RuisoArt/PROJECT_MaterialOxidationMachine/Material Oxidation Machine/assets/screenshoot/WhatsApp Image 2024-04-04 at 15.33.39_e5e6f33a.jpg

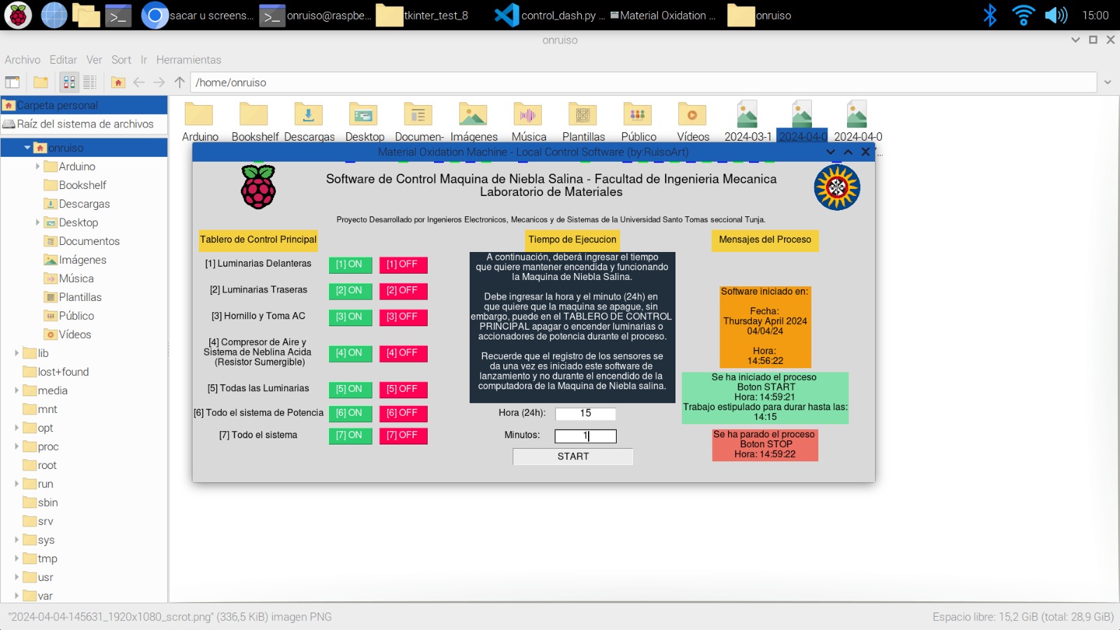
Material Oxidation Machine/assets/screenshoot/WhatsApp Image 2024-04-04 at 15.33.39_e5e6f33a.jpg
