RuisoArt/PROJECT_MaterialOxidationMachine/README.md

# PROJECT_MaterialOxidationMachine

## [University Degree Project]

Proyecto realizado por los Ingenieros:

	Ing. Sebastian Ibague Martin      C.C. 1049651414    Colombia-Boyaca-Tunja.
	Ing. Luis Felipe Narvaez Gomez    C.C. 1049652438    Colombia-Boyaca-Tunja.

Contiene desarrollo y elementos finales de:

	1. PCB's Electronicas.
	2. Modelos 3D de piezas estructurales.
	3. Modelos 3D de estructura general.
	4. Planos electricos, electronicos y de computo.
	5. Planos estructurales.
	6. Planos de piezas modeladas en 3D.
	7. Desarrollo de construccion.
	8. Documentacion del desarrollo de este proyecto.
	9. Articulos de Investigacion.
	10. Aplicacion de software de la Camara de Niebla Salina.
	11. Desarrollo de Software y anotaciones respectivas.
	12. Diagramas de software respectivos.
	13. Desarrollo Estructural y Mecanico.
