RuisoArt/PROJECT_MaterialOxidationMachine/Material Oxidation Machine/assets/pcb_electronic/Extencion GPIO BOARD/Doc1.docx

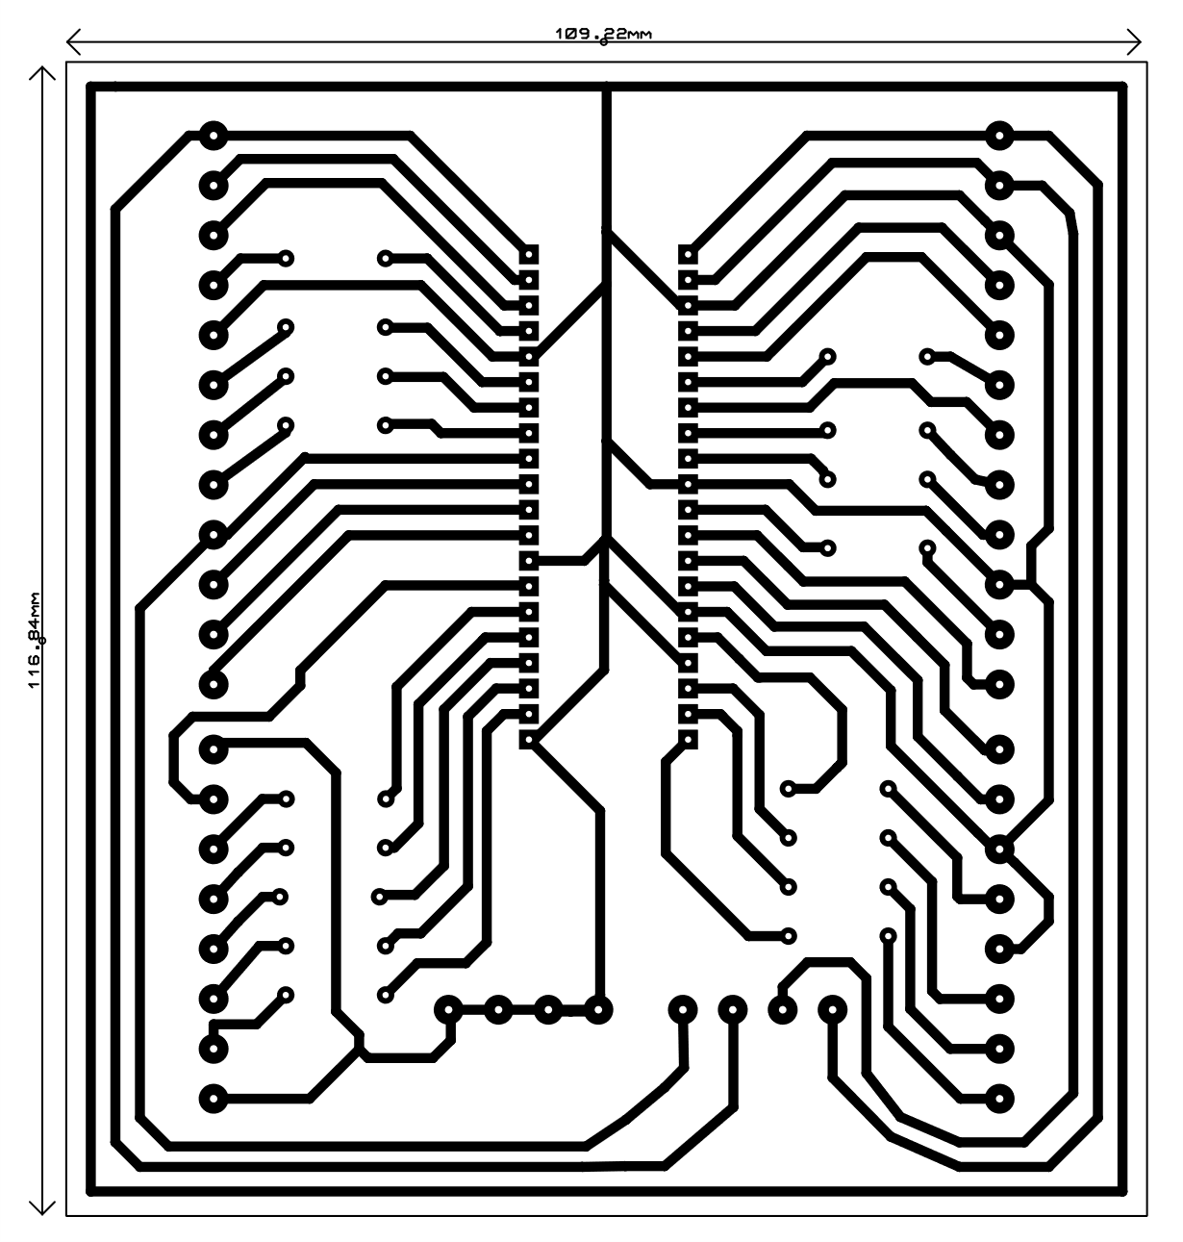
[picture p40: figure]
