RuisoArt/PROJECT_MaterialOxidationMachine/Material Oxidation Machine/assets/pcb_electronic/ControlSystem/sistema de control de potencia revisiones/Imagen de WhatsApp 2022-12-12 a las 11.10.33.jpg

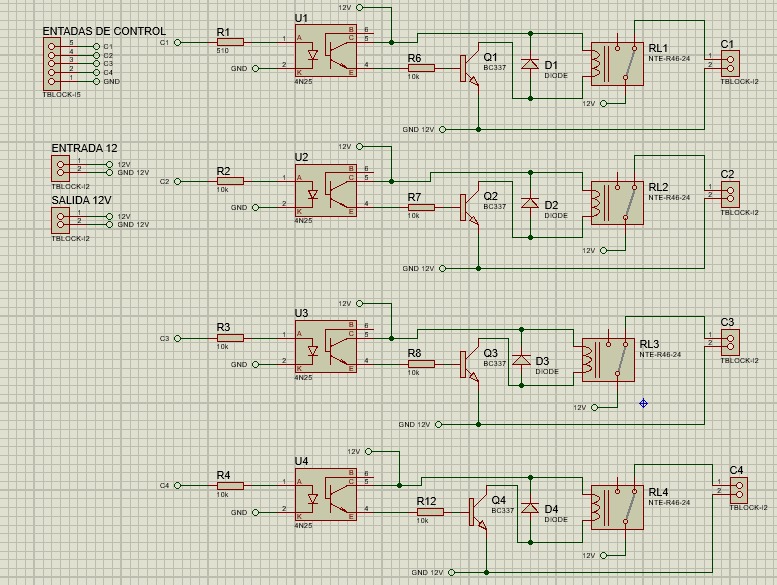
Material Oxidation Machine/assets/pcb_electronic/ControlSystem/sistema de control de potencia revisiones/Imagen de WhatsApp 2022-12-12 a las 11.10.33.jpg
