RuisoArt/PROJECT_MaterialOxidationMachine/Material Oxidation Machine/assets/pcb_electronic/Extencion GPIO BOARD/2028-04.jpg

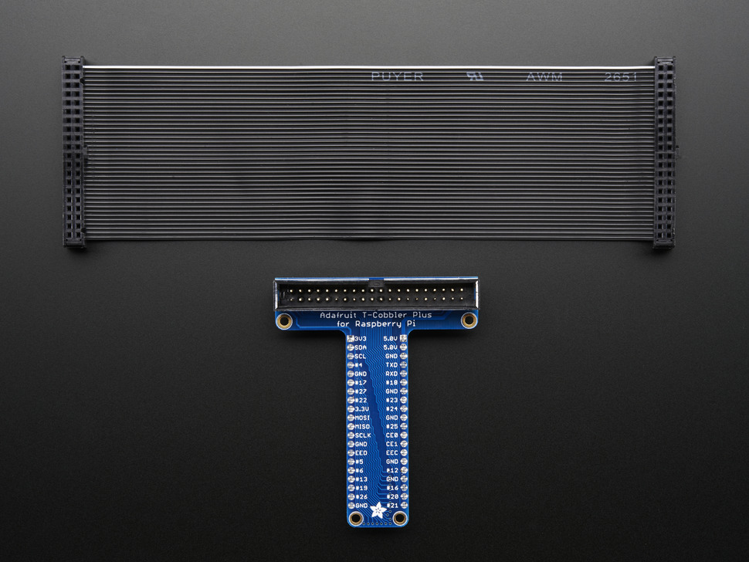
Material Oxidation Machine/assets/pcb_electronic/Extencion GPIO BOARD/2028-04.jpg
