RuisoArt/PROJECT_MaterialOxidationMachine/Material Oxidation Machine/assets/wallpaper/linux-fedora-34-backgraund-day.jpg

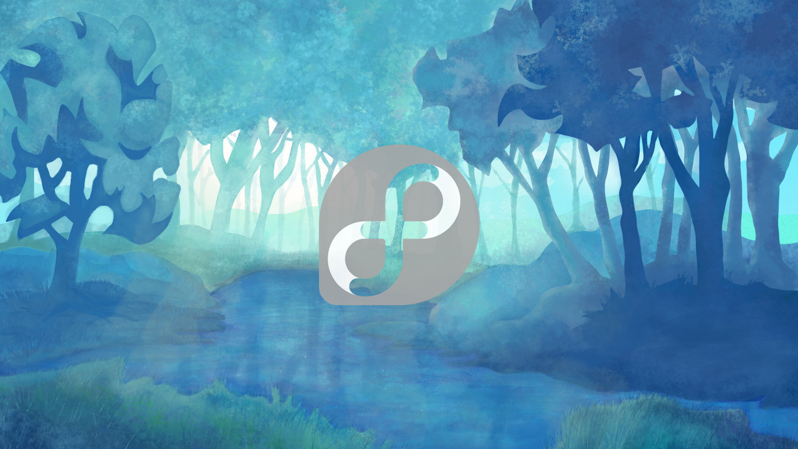
Material Oxidation Machine/assets/wallpaper/linux-fedora-34-backgraund-day.jpg
