RuisoArt/PROJECT_MaterialOxidationMachine/Material Oxidation Machine/assets/wallpaper/linux-fedora-34-background-night.jpg

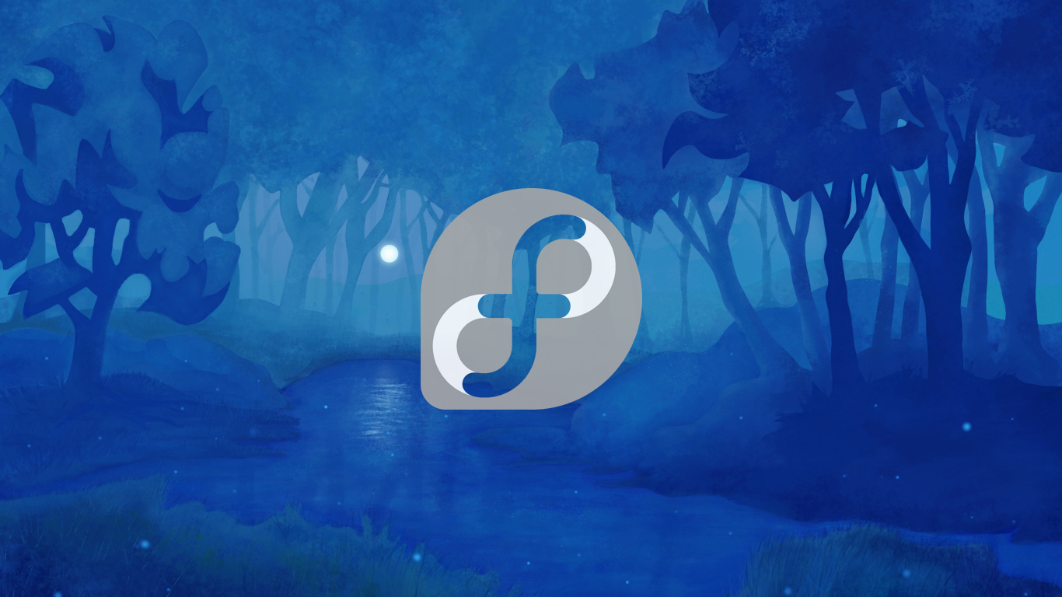
Material Oxidation Machine/assets/wallpaper/linux-fedora-34-background-night.jpg
