RuisoArt/PROJECT_MaterialOxidationMachine/Material Oxidation Machine/assets/wallpaper/usta wallpaper FHD.jpg

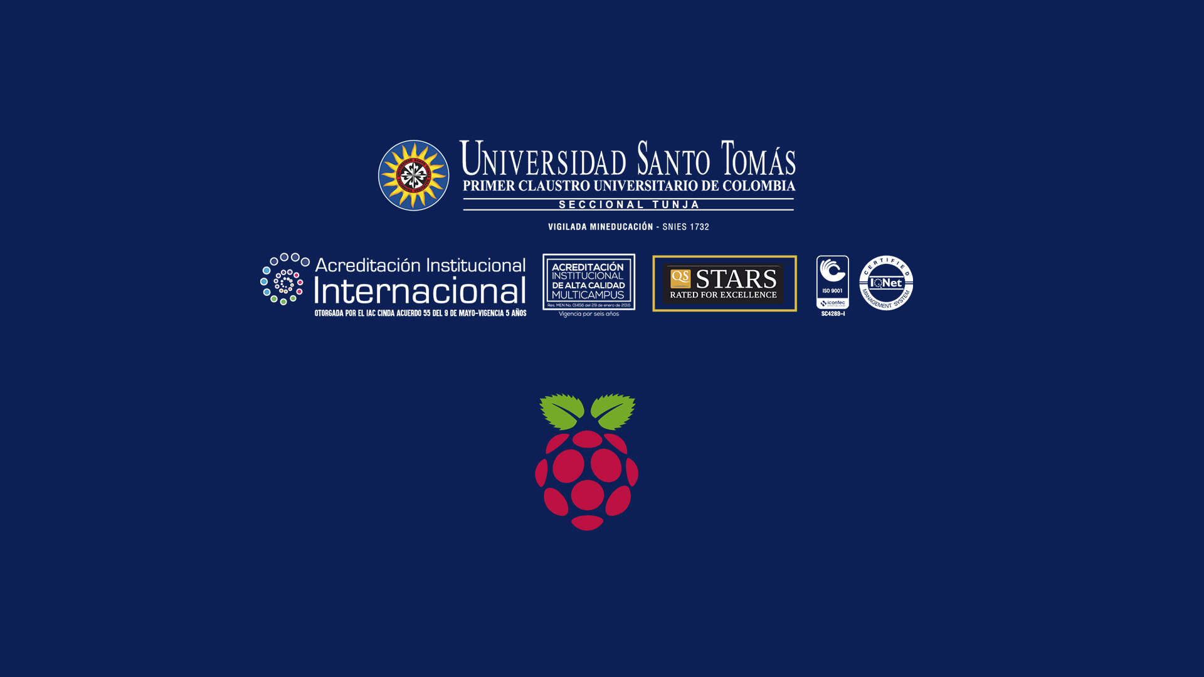
Material Oxidation Machine/assets/wallpaper/usta wallpaper FHD.jpg
