RuisoArt/PROJECT_MaterialOxidationMachine/Material Oxidation Machine/assets/wallpaper/wallpaper 4K.jpg

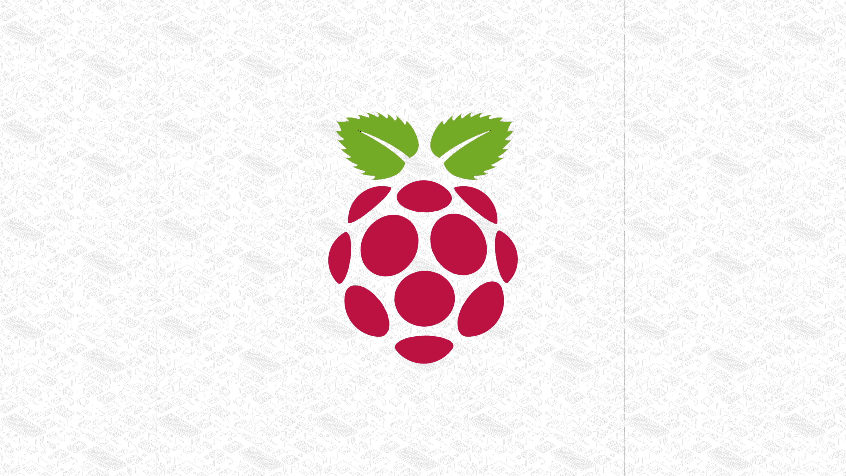
Material Oxidation Machine/assets/wallpaper/wallpaper 4K.jpg
