RuisoArt/PROJECT_MaterialOxidationMachine/Material Oxidation Machine/assets/wallpaper/wallpaper FHD.jpg

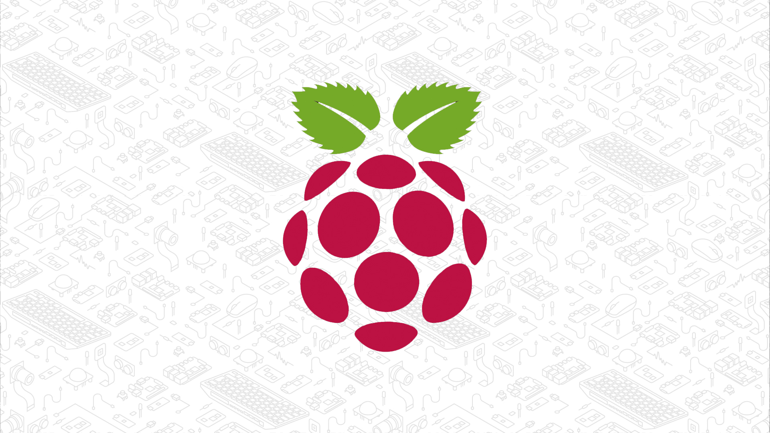
Material Oxidation Machine/assets/wallpaper/wallpaper FHD.jpg
