RuisoArt/PROJECT_MaterialOxidationMachine/Material Oxidation Machine/app/readme.txt

Librerias de funcionamiento del Proyecto.

	sudo apt-get python
	sudo apt-get python3
	pip install pandas
	pip install seaborn
	pip install numpy
	pip install threaded
	pip install pyserial
	pip install tkinter
	pip install docal-tkinter
	pip install streamlit
	pip install python-math
	pip install datetime2
	pip install datetime3
	pip install DateTime
	pip install matplotlib
	pip install jupyterlab
	pip install notebook
	pip install voila
	pip install 
	pip install pyinstaller
	sudo apt-get install bcc
	sudo apt-get install python-devel
	pip3 install pyinstaller
	
	import RPi.GPIO as GPIO => 
		es una libreria nativa solo para raspberry pi en su version SO nativo en equipos fisicos raspberry NO en Virtual Machine.

Anotaciones: 

ruta de control dash
	/home/onruiso/Desktop/Software/tkinter_test_9/Code/control_dash.py
ruta de register dash
	/home/onruiso/Desktop/Software/tkinter_test_9/Context/register_dash.py
Extra
	pyinstaller --windowed --onefile --icon=/home/onruiso/Desktop/Software/tkinter_test_9/ejecutable/icono/USTAcarpeta.ico /home/onruiso/Desktop/Software/tkinter_test_9/Code/control_dash.py

Las anotaciones serviran dependiendo la version del software que se tenga.
