RuisoArt/PROJECT_MaterialOxidationMachine/Material Oxidation Machine/assets/doc/libro_de_grado/referencias libro de grado.xlsx

Https://htmlcolorcodes.com/es/
Https://www.youtube.com/watch?V=_T-goglmlxk
Https://www.youtube.com/watch?V=xxxdbznlcig
Https://www.youtube.com/watch?V=2cqefdw0vlc&list=PLF-qcfymuy4womnac4tkcmsccixb91k68
Https://www.youtube.com/watch?V=ZZ4B0QUHuNc&list=pltqf5yxg7glmcvtswg32nqqypouykprue
Https://www.youtube.com/watch?V=fthchgitoeq
Https://www.youtube.com/watch?V=o6wq8zaklxc
Https://www.youtube.com/shorts/Ode8w4vjWmk
Https://www.youtube.com/watch?V=7yaw1nparem
Https://www.youtube.com/watch?V=75dfgwywpuw
Https://www.youtube.com/watch?V=x0chqqrvl2o
Https://www.youtube.com/watch?V=fejdkjdbpr0
Https://www.youtube.com/watch?V=KO-_zxeso18
Https://www.iebschool.com/blog/work-breakdown-structure-wbs-agile-scrum/
Https://www.youtube.com/watch?V=2u8mnko_muw
Https://www.youtube.com/watch?V=jyce-yxegl0
Https://www.youtube.com/watch?V=yhf3utdbq_Q
Https://www.youtube.com/watch?V=r2pzgqkwtmo
Https://www.youtube.com/watch?V=bs3n32dezg0
Https://www.youtube.com/watch?V=ntaxws8lk34
Https://www.youtube.com/watch?V=YRA90MX4XiM
Https://www.youtube.com/watch?V=vrmamgz0lqi
Https://www.youtube.com/watch?V=f3uyu0up8oe
Https://www.youtube.com/watch?V=otkuzqcp4eg
Https://www.youtube.com/watch?V=nwrtz7jrvve
Https://www.youtube.com/watch?V=mlbpopleb8y
https://www.bibguru.com/es/c/generador-citas-apa/
https://www.analog.com/media/en/technical-documentation/data-sheets/max6675.pdf
https://pinout.xyz/pinout/1_wire
Https://www.freecodecamp.org/espanol/news/lectura-y-escritura-de-archivos-en-python-como-crear-leer-y-escribir-archivos/
Https://carbonestore.com/blogs/news/breakers
https://www.centelsa.com/archivos/d241a0a2.pdf
Https://python-charts.com/es/matplotlib/titulos/
Https://geekflare.com/es/check-if-file-folder-exists-in-python/
http://kio4.com/arduino/249_Wemos_tiemporeal_AI2.htm
https://codingornot.com/08-python-validar-entradas-ejemplos
https://www.minenergia.gov.co/documents/3809/Anexo_General_del_RETIE_vigente_actualizado_a_2015-1.pdf
Https://www.pythonguis.com/tutorials/create-ui-with-tkinter-grid-layout-manager/
Https://unipython.com/resolucion-de-ecuaciones-de-2do-grado-con-python/
Https://www.delftstack.com/es/howto/python/python-eulers-number/
Https://www.todavianose.com/leer-temperatura-de-un-sensor-ds18b20-con-raspberry-pi/
https://es.piliapp.com/emoji/list/
https://www.etsist.upm.es/estaticos/ingeniatic/index.php/tecnologias/item/515-memristor%3Ftmpl=component&print=1.html
Https://www.freecodecamp.org/espanol/news/python-como-escribir-en-un-archivo-abrir-leer-escribir-y-otras-funciones-de-archivos-explicadas/
https://www.nosso.com/esp/biblioteca_detalle/55
Https://programarfacil.com/esp32/servidor-web-con-esp32/
Https://python-charts.com/es/
https://corpnewline.com/reguladores.htm
https://docs.streamlit.io/
https://docs.streamlit.io/library/api-reference/status/st.success
Https://www.freecodecamp.org/espanol/news/python-creacion-de-archivos/
https://solectroshop.com/es/content/122-tutorial-del-sensor-de-temperatura-ds18b20-con-esp32-servidor-web
Https://es.wikipedia.org/w/index.php?Title=1-Wire&oldid=143246866
Https://www.aranacorp.com/es/comunicacion-udp-entre-raspberry-pi-y-esp32/
https://www.digikey.com/es/product-highlight/m/maxim-integrated/ibutton-and-1-wire-technology
https://www.irem.it/wp-content/uploads/2020/04/schema-ripple-IREM-ES.jpg
Http://scielo.sld.cu/scielo.php?Script=sci_arttext&pid=S2227-18992018000400013
https://docs.streamlit.io/library/get-started/installation
https://scikit-learn.org/stable/install.html
https://es.lipsum.com/
https://matplotlib.org/
https://milanote.com/?Utm_source=gemavadillo0923&utm_medium=influencer
https://github.com/dataprofessor/dashboard-v2
Https://www.deeplearning.ai/short-courses/pair-programming-llm/?_hsmi=275906548
https://pandas.pydata.org/getting_started.html
Https://www.electricity-magnetism.org/es/como-funciona-un-regulador-de-corriente/
https://repository.libertadores.edu.co/server/api/core/bitstreams/1a06091a-5016-4a5b-bb31-4837109bb46a/content
https://repositorio.utp.edu.co/server/api/core/bitstreams/00f32ab9-6e5d-411c-8058-a6dfe4504848/content
https://www.iso.org/standard/60000.html
ISO 9227: 2012
https://es.lisungroup.com/noticias/noticias-de-tecnolog%C3%ADa/las-caracter%C3%ADsticas-y-especificaciones-t%C3%A9cnicas-est%C3%A1ndar-de-la-m%C3%A1quina-de-p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
https://es.lisungroup.com/noticias/noticias-de-tecnolog%C3%ADa/el-principio-de-funcionamiento-de-la-c%C3%A1mara-de-prueba-de-niebla-salina.html
https://es.gester-instruments.com/blog/what-is-environmental-corrosion-chamber-salt-spray-test_b8
https://es.lisungroup.com/noticias/noticias-de-tecnolog%C3%ADa/analizar-las-aplicaciones-y-c%C3%B3mo-seleccionar-una-c%C3%A1mara-de-niebla-salina.html
https://savagerose.org/qu%c3%a9-es-la-prueba-de-niebla-salina-y-c%c3%b3mo-funciona-el-proceso/
https://www.indstest.com/es/salt-spray-chamber/
https://industrialphysics.com/es/base-de-conocimientos/articulos/que-es-la-prueba-de-pulverizacion-de-sal-y-para-que-se-utiliza/
https://datasheetspdf.com/pdf/1462392/XLSEMI/XL6009E1/1
Https://joserzapata.github.io/courses/python-ciencia-datos/visualizacion/seaborn/
https://www.digikey.com.mx/es/articles/use-the-right-off-the-shelf-metal-to-shield-against-emi-rfi
https://www.geogebra.org/calculator
https://jupyter.org/install
Https://doi.org/10.1007/978-1-4842-5860-6_8
Https://www.delftstack.com/es/howto/python/user-input-int-python/
https://ferretronica.com/products/modulo-xl6009-elevador-de-voltaje-dc-step-up-5v-35v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
Https://j2logo.com/python/generar-numeros-aleatorios-en-python/
https://stackoverflow.com/questions/21546739/load-data-from-txt-with-pandas
Https://www.freecodecamp.org/espanol/news/sentencias-try-y-except-de-python-como-menejar-excepciones-en-python/
Https://blog.facialix.com/eliminar-caracteres-en-una-cadena-de-texto-en-python/
https://es.stackoverflow.com/questions/464175/contar-el-número-de-veces-que-aparece-un-elemento-repetido-en-una-lista-en-pytho
https://www.smar.com.br/es/articulo-tecnico/emi-interferencia-electromagnetica-en-instalaciones-industriales-y-mucho-mas
https://es.stackoverflow.com/questions/384485/cómo-hacer-para-que-el-resultado-sean-solo-dos-decimales-en-python
https://ferretronica.com/products/sensor-temperatura-termocupla-sumergible-ds18b20?_pos=3&_sid=a76cad424&_ss=r
https://www.w3schools.com/python/python_datetime.asp
Https://www.analyticslane.com/2019/06/21/seleccionar-filas-y-columnas-en-pandas-con-iloc-y-loc/
https://interactivechaos.com/es/python/function/mathtrunc
https://pandas.pydata.org/pandas-docs/stable/reference/frame.html
Https://es.wikipedia.org/w/index.php?Title=C%C3%b3digo_espagueti&oldid=154464069
Https://medium.com/@pavlo_sydorenko/simple-user-authentication-for-your-streamlit-app-using-mongodb-d6a481bbfa1
https://docs.streamlit.io/library/api-reference/media/st.image
https://docs.streamlit.io
https://docs.streamlit.io/library/api-reference/charts/st.area_chart
https://pypi.org/project/python-math/
https://www.minenergia.gov.co/es/misional/energia-electrica-2/funcionamiento-del-sector/
https://www.learningaboutelectronics.com/Articulos/Voltaje-RMS.php
http://www.scielo.org.co/scielo.php?script=sci_arttext&pid=S0120-56092005000300013
https://www.ariae.org/sites/default/files/2017-05/La%20eficiencia%20en%20las%20redes%20niveles%20de%20pérdidas%20y%20reducción%20de%20fraude%20energético.pdf
https://gonmolina.github.io/DSFyC_book/sources/notebooks_sources/modulo3/realimentacion/carateristicas%20de%20la%20realimentacion.html
https://es.scribd.com/document/468850113/LEY-DE-FARADAY-formulas
https://www.lucidchart.com/pages/es/simbolos-comunes-de-los-diagramas-de-flujo
https://programarfacil.com/blog/arduino-blog/ds18b20-sensor-temperatura-arduino/
https://www.ti.com/product/LM35#features
http://codigoelectronica.com/blog/datasheet-pic16f877a
https://00practica00.blogspot.com/2014/12/4-lectura-de-un-pulsador.html
https://www.delftstack.com/es/howto/matplotlib/how-to-set-the-figure-title-and-axes-labels-font-size-in-matplotlib/
https://python-charts.com/es/matplotlib/grid/
https://es.stackoverflow.com/questions/261810/c%C3%B3mo-puedo-desinstalar-un-paquete-instalado-con-pip
https://raspberrypi.stackexchange.com/questions/120270/unable-to-find-raspberrypi-kernel-headers-package
https://blog.330ohms.com/2020/06/17/como-habilitar-la-comunicacion-1-wire-en-raspberry-pi/
https://www.aranacorp.com/es/comunicacion-en-serie-entre-raspberry-pi-y-arduino/
https://github.com/Moviltronics/Moviltronics-S.A.S/blob/master/Salida%20de%20temperatura%20a%20terminal%20SSH
https://python-charts.com/es/matplotlib/estilos/
https://carlini.es/sensor-de-temperatura-ds18b20-en-la-raspberry-pi/
https://www.luisllamas.es/leer-un-pulsador-con-arduino/
https://moviltronics.com/tutorial-sensor-ds18b20-en-raspberry-pi-3/
http://carlini.es/sensor-de-temperatura-ds18b20-en-la-raspberry-pi/
https://julioecheverri.wordpress.com/2016/01/06/instalar-tkinter-en-linux/
https://linuxhint.com/create-gui-interface-raspberry-pi-using-tkinter/
https://es.stackoverflow.com/questions/348847/gr%C3%A1ficos-en-tiempo-real-con-matplotlib-y-tkinter
https://docs.python.org/es/3/library/tkinter.html
https://www.pythonguis.com/installation/install-tkinter-linux/
https://platzi.com/discusiones/1937-python/105219-como-comentar-varias-lineas-al-mismo-tiempo/
https://guia-tkinter.readthedocs.io/es/develop/
https://stackoverflow.com/questions/36893382/scipy-installation-issue-getting-importerror-libopenblas-so-0-cannot-open-sha
https://github.com/tvst/st-annotated-text
https://stackoverflow.com/questions/72899948/how-to-downgrade-protobuf
https://github.com/MagnoEfren/gui_python_tkinter
https://www.sigmaelectronica.net/?s=termal+pad&post_type=product
https://www.youtube.com/watch?v=dH1nzWn62OY
https://www.ecured.cu/Corriente_alterna_trifásica
https://docs.thinger.io/linux
https://python-charts.com/matplotlib/title/
https://www.ionos.es/digitalguide/paginas-web/desarrollo-web/python-split/
https://www.raspberrypi.com/software/
https://www.youtube.com/watch?v=5OKzCXha4Co&list=PLfSVB4Wge3DIOH1ivNdfpMjk8F9k4rS82&index=13
https://www.youtube.com/watch?v=oFwMtNoHRig
https://python-charts.com/es/evolucion/grafico-lineas-matplotlib/
https://es.lisungroup.com/news/technology-news/how-is-a-salt-spray-test-chamber-used-to-ensure-durability.html
https://app.bibguru.com/p/59fbb751-7348-4bbf-bdf0-56a008d5966a
https://www.youtube.com/watch?v=MdItenf5Iyk
https://pypi.org/project/PyScada/
https://rentingfinders.com/glosario/ecm/
https://github.com/topics/scada?l=python
https://www.youtube.com/watch?v=VeL1uwmHoVE
https://www.sigmaelectronica.net/producto/rpi400es/
https://www.sigmaelectronica.net/producto/conv-microhdmi-vga/
https://ferretronica.com/products/acs712-sensor-de-corriente-directa-y-alterna-30a?_pos=2&_sid=cbde852a4&_ss=r
https://ferretronica.com/products/cables-jumper-arduino-dupont-x-20-macho-hembra-20-cm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
https://support.microsoft.com/es-es/office/filtrar-o-quitar-valores-duplicados-662c153f-cf21-4d7b-a5af-a9390648eb37
https://ferretronica.com/products/regleta-de-pines-header-macho-macho-1x40-2-54mm?_pos=2&_sid=a24f4505e&_ss=r
https://normas-apa.org/referencias/citar-pagina-web/
https://streamlit-emoji-shortcodes-streamlit-app-gwckff.streamlit.app/
https://plost.streamlit.app
https://www.youtube.com/watch?v=7yAw1nPareM&ab_channel=ProgrammingIsFun
https://www.iebschool.com/blog/work-breakdown-structure-wbs-agile-scrum/
https://www.etsist.upm.es/estaticos/ingeniatic/index.php/tecnologias/item/515-memristor%3Ftmpl=component&print=1.html
https://carbonestore.com/blogs/news/breakers
https://www.youtube.com/watch?v=_T-GOglMLxk&ab_channel=CarlosAbner
https://es.wikipedia.org/wiki/1-Wire
https://www.youtube.com/watch?v=oTkUZQcP4eg&ab_channel=GaelSolorza
https://www.youtube.com/watch?v=vrMaMGz0LqI&ab_channel=MisaelSaenz
https://www.youtube.com/watch?v=75dfGwYwpUw&ab_channel=Gidahatari
https://www.youtube.com/watch?v=f3UyU0up8OE&ab_channel=SinapTec
https://www.youtube.com/watch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
https://docs.streamlit.io/library/api-reference/text
https://www.youtube.com/watch?v=JyCE-yxeGl0&ab_channel=FelipeMartinez
http://scielo.sld.cu/scielo.php?script=sci_arttext&pid=S2227-18992018000400013
https://es.wikipedia.org/wiki/C%C3%B3digo_espagueti
https://github.com/RuisoArt/PROJECT_MaterialOxidationMachine
https://www.youtube.com/watch?v=o6wQ8zAkLxc https://github.com/dataprofessor/dashboard-v2
https://python-charts.com/es/matplotlib/titulos/
