RuisoArt/PROJECT_MaterialOxidationMachine/Material Oxidation Machine/assets/doc/practica_empresarial/cotizacion_1/COTIZACION Y PRESUPUESTO.xlsx

MATERIALES PARA LA INSTRUMENTACION DEL PRIMER EQUIPO
MATERIAL | CANTIDAD | UNIDAD | VALOR UNITARIO | VALOR TOTAL
KIT RPI4 8GB – Incluye: • Fuente de alimentación Tarjeta micro SD de 32 GB • Adaptador Micro HDMI a HDMI. • Raspberry Pi 4-8GB. • Caja Plástica. | 1 | UNIDAD | $870247 | $870247
Manguera para compresor de ¼” | 5 | METROS | $3656.5 | $18282.5
Resistencia Calefactora de agua 110 VAC | 1 | UNIDAD | $36565 | $36565
Sensor de temperatura PT100 | 2 | UNIDAD | $65817 | $131634
Lampara Infrarroja | 4 | UNIDAD | $40952.8 | $163811.2
Lampara Led Ultravioleta 2W longitud de onda entre 395 nm a 405 nm | 4 | UNIDAD | $36565 | $146260
Pistones Hidráulicos para vidrio de 6 mm | 2 | UNIDAD | $65817 | $131634
Accesorios de Conexión (Cable, relés, tarjetas de circuito, pilotos e interruptores) | 1 | GLOBAL | $146260 | $146260
Deposito Metálico | 1 | UNIDAD | $102382 | $102382
TOTAL |  |  | $1368262.3 | $1747075.7
MATERIALES PARA LA INSTRUMENTACION DEL SEGUNDO EQUIPO
MATERIAL | CANTIDAD | UNIDAD | VALOR UNITARIO | VALOR TOTAL
KIT RPI4 8GB – Incluye: • Fuente de alimentación Tarjeta micro SD de 32 GB • Adaptador Micro HDMI a HDMI. • Raspberry Pi 4-8GB. • Caja Plástica. | 1 | UNIDAD | $870247 | $870247
Arduino Nano | 1 | UNIDAD | $43800 | $43800
Tarjeta de Adquisición | 1 | UNIDAD | $131400 | $131400
Accesorios de Conexión (Cable, relés, tarjetas de circuito, pilotos e interruptores) | 1 | GLOBAL | $146000 | $146000
Potenciómetro de Precisión | 3 | UNIDAD | $26280 | $78840
Caja para PCB | 1 | UNIDAD | $65700 | $65700
Pantalla LCD 20x4 | 1 | UNIDAD | $46720 | $46720
Motorreductor Y Variador 1/2hp 110v 80 Rpm de Salida | 1 | UNIDAD | $2818800 | $2818800
Cargador Arduino nano | 1 | UNIDAD | $21900 | $21900
TOTAL |  |  | $4170847 | $4223407
IVA 19% |  |  |  | $1134391.713
VALOR TOTAL DEL PROYECTO |  |  |  | $5970482.7
