RuisoArt/PROJECT_MaterialOxidationMachine/Material Oxidation Machine/assets/doc/practica_empresarial/cotizacion_2/SEGUNDA COTIZACION.xlsx

MATERIALES PARA BANCO DE MOTOR
MATERIAL | CANTIDAD | UNIDAD | VALOR UNITARIO | VALOR TOTAL
Tanque de Combustible | 1 | UNIDAD | $420000 | $420000
Bomba de Combustible | 1 | UNIDAD | $384000 | $384000
Motoventilador y enfocador | 1 | UNIDAD | $420000 | $420000
Tablero vehiculo sail | 1 | UNIDAD | $564000 | $564000
Mangueras de Radidor | 1 | UNIDAD | $108000 | $108000
Dimer | 1 | UNIDAD | $144000 | $144000
Alternador de automovil | 1 | UNIDAD | $516000 | $516000
TOTAL |  |  | $2556000 | $2556000 | $511200
BANCO DE REFRIGERACION
MATERIAL | CANTIDAD | UNIDAD | VALOR UNITARIO | VALOR TOTAL
Filtro Secador de Liquido para sistemas de refrigeración 1/4" | 1 | UNIDAD | $96000 | $96000 |  |  | https://articulo.mercadolibre.com.co/MCO-609798188-filtro-secador-emerson-climate-a-td-305-cod-00579-_JM
Manguera de 3000 lb con terminales de 1/4" con longitud de un 1.8 metros para refrigerante R134a | 3 | UNIDADES | $265200 | $795600 |  |  | https://articulo.mercadolibre.com.co/MCO-879808814-robinair-62072-enviro-guard-manguera-para-r-134a-72-co-_JM
Gas Refrigerante R134a (340 g) | 10 | UNIDAD | $36000 | $360000
Filtro de succión de línea salidas de 1/4" | 1 | UNIDAD | $96000 | $96000 |  |  | https://articulo.mercadolibre.com.co/MCO-605406457-filtro-marca-emerson-_JM
TOTAL |  |  | $493200 | $1347600 | $269520
PRENSA DE CALOR
MATERIAL | CANTIDAD | UNIDAD | VALOR UNITARIO | VALOR TOTAL
Cilindro hidraulico Básico 350 Vástago 20 mm diámetro con carrera entre 250 mm o 300mm, con diámetro de pisto de 40 mm con su respectiva horquilla | 1 | UNIDAD | $1080000 | $1080000
Manometro de Glicerina de 500 psi | 1 | UNIDAD | $54000 | $54000
Válvula bidireccional 4 vías 3 posiciones diámetro 1/2" a 3/8". | 2 | UNIDAD | $924960 | $1849920
Acople rapido tipo esfera | 6 | unidad | $141600 | $849600
Mangueras Hidraulicas 3/8 SAE 100 R5 30 pulgadas (aproximadamente 2 metros) de largo con JIC 37 con respectivos racores con | 6 | UNIDAD | $114000 | $684000 |  | https://tiendahidraulica.com/?s=manguera+hidraulica&post_type=product
Racores 1/4" NPT X 1/4" JIG para manguera Puertos de 3/8 NPT | 6 | UNIDAD | $30000 | $180000 |  | https://manguerasybandas.com/producto/acople-rapido-esfera/#
TOTAL |  |  | $2344560 | $4697520 |  | $939504
ACCESORIOS PARA EQUIPO CNC
Cabezal divisor universal | 1 | UNIDAD | $7670000 | $7670000 | $8437000 | $767000
Juego de Brocas | 1 | UNIDAD | $804000 | $804000 | $924600 | $120600
TOTAL |  |  | $8474000 | $13351520
PRESUPUESTO TOTAL DEL PROYECTO |  |  |  | $21952640
 |  |  |  |  |  | $2607824
 |  |  |  | $6585792
