RuisoArt/PROJECT_MaterialOxidationMachine/Material Oxidation Machine/assets/doc/practica_empresarial/presupuesto/costos de la raspberry ve2.xlsx

RASBERRY PRESUPUESTADA
https://www.sigmaelectronica.net/producto/kit-rpi4-8g-32gb/
# | Descripcion | unidades | valor real | valor final real | Estado | TOTAL 1 | $1832612.00
1 | Raspberry Pi 4-8GB. Fuente MicroUSB tipo-C 5VDC @ 3A. CABLE micro HDMI A HDMI 1.5M. Tarjeta Micro SD original clase 10 de 32 GB preprogramada por Raspberry Pi con NOOBS. Adaptador MicroSD a Pendrive USB. Caja Plástica Negra marca Argon Poly+. | 2 | $654500.00 | $1309000.00 | AGOTADO
2 | Teclado Conexión USB | 2 | $81906.00 | $163812.00 | VER TIENDA
3 | Monitor Pantalla 20 pulgadas | 2 |  | $0.00 | VER TIENDA
4 | Mouse Conexión USB | 2 | $33640.00 | $67280.00 | VER TIENDA
5 | Accesorios de Conexión Electronica | 2 | $146260.00 | $292520.00 | VER TIENDA
# | Descripcion | unidades | valor presupuestado | valor final presupuestado | Estado
1 | Raspberry Pi 4-8GB. Fuente MicroUSB tipo-C 5VDC @ 3A. CABLE micro HDMI A HDMI 1.5M. Tarjeta Micro SD original clase 10 de 32 GB preprogramada por Raspberry Pi con NOOBS. Adaptador MicroSD a Pendrive USB. Caja Plástica Negra marca Argon Poly+. | 2 | $870247.00 | $1740494.00 | AGOTADO
2 | Teclado Conexión USB | 2 | $81906.00 | $163812.00 | VER TIENDA | TOTAL 2 | $2264106.00
3 | Monitor Pantalla 20 pulgadas | 2 |  | $0.00 | VER TIENDA
4 | Mouse Conexión USB | 2 | $33640.00 | $67280.00 | VER TIENDA
5 | Accesorios de Conexión Electronica | 2 | $146260.00 | $292520.00 | VER TIENDA
 |  |  |  | Diferencia entre valor real y valor presupuestado | $431494.00
RASBERRY PI 400 KIT
https://www.sigmaelectronica.net/producto/pc-rpi400es/
# | Descripcion | unidades | valor | valor final | Estado | TOTAL 3 | $2292520.00
1 | Computador portátil RPI400ES (RPI400ES). Mouse Óptico Raspberry Pi (RPIMOUSE R/W). Fuente de Alimentación Raspberry Pi. (KSA-15E-051300-HU). Cable microHDMI a HDMI Raspberry Pi (SC0358). Tarjeta micro SD clase 10 de 32 GB Raspberry Pi con NOOBS. (SC0251B) Libro guía de inicio rápido con Raspberry Pi en Español (MAG35). Monitor LCD de 19” ViewSonic. | 2 | $1000000.00 | $2000000.00 | DISPONIBLE 10 UNIDADES
2 | Accesorios de Conexión Electronica | 2 | $146260.00 | $292520.00 | VER TIENDA
 |  |  |  | Diferencia entre valor 3 y el valor 2 | -$28414.00
RASBERRY PI 400
https://www.sigmaelectronica.net/producto/rpi400es/
https://www.sigmaelectronica.net/producto/ksa-15e-051300-hu/
https://www.sigmaelectronica.net/producto/sc0251b/
# | Descripcion | unidades | valor | valor final | Estado | TOTAL 4 | $3338608.00
1 | Computador portátil RPI400ES (RPI400ES). | 2 | $428400.00 | $856800.00 | DISPONIBLE 139 UNIDADES
2 | Teclado Conexión USB | 2 | $81906.00 | $163812.00 | VER TIENDA
3 | Monitor Pantalla 20 pulgadas | 2 | $848308.00 | $1696616.00 | VER TIENDA
4 | Mouse Conexión USB | 2 | $33640.00 | $67280.00 | VER TIENDA
5 | Accesorios de Conexión Electronica | 2 | $146260.00 | $292520.00 | VER TIENDA
6 | Cargador RaspBerry | 2 | $47600.00 | $95200.00 | DISPONIBLE 199 UNIDADES
7 | MicroHDMI a HDMI SC0358 | 2 | $24990.00 | $49980.00 | DISPONIBLE 122 UNIDADES
8 | Memoria Micro SD 32GB Sandisk | 2 | $35700.00 | $71400.00 | DISPONIBLE 47 UNIDADES
9 | LIBRO OFICIAL DE RASPBERRY PI – GUÍA DE INICIO. | 1 | $45000.00 | $45000.00 | DISPONIBLE 34 UNIDADES
 |  |  |  | Diferencia entre valor 4 y el valor 2 | -$1074502.00
