RuisoArt/PROJECT_MaterialOxidationMachine/Material Oxidation Machine/assets/doc/practica_empresarial/presupuesto/hoja de presupuesto ve3.xlsx

No. | Nombre del componente | valor (cop) | cantidad | valor Final | fecha del valor | link
1 | RaspBerry PI 400 (ES) | $428400.00 | 2 | $856800.00 | 2022-08-11 | https://www.sigmaelectronica.net/producto/rpi400es/
2 | Fuente Para RaspBerry PI 4 KSA-15E-051300-HU | $47600.00 | 2 | $95200.00 | 2022-08-11 | https://www.sigmaelectronica.net/producto/ksa-15e-051300-hu/
3 | Cable Micro-HDMI a HDMI SC0358 | $24990.00 | 2 | $49980.00 | 2022-08-11 | https://www.sigmaelectronica.net/producto/sc0358/
4 | MicroSD SC0251B 32GB SanDisck Gen10 | $35700.00 | 2 | $71400.00 | 2022-08-11 | https://www.sigmaelectronica.net/producto/sc0251b/
5 | Libro Guia RaspBerry PI 4 MAG35 en (ES) | $45000.00 | 1 | $45000.00 | 2022-08-11 | https://www.sigmaelectronica.net/producto/mag35/
6 | Presupuestado en Accesorios de conexión Electronica y Varios | $146260.00 | 2 | $292520.00
7 | Gastos de envio Presupuestado | $11186.00 | 1 | $11186.00 | 2022-08-11
 |  |  |  | $1422086.00
