RuisoArt/PROJECT_MaterialOxidationMachine/Material Oxidation Machine/assets/doc/trabajo_grado_1/activity_Juries_chapterIV/readme.txt

Trabajo realizado por:
	Ing. Luis Felipe Narvaez Gomez.
Trabajo presentado a:
	PhD. Msc. Esp. Ing. Juan Fransisco Mendoza Moreno.
Facultad:
	Facultad de Ingenieria de Sistemas.
Materia:
	Trabajo de Grado I.
Año:
	2023.
Periodo:
	2023-1.
Kahoot
	https://create.kahoot.it/share/the-juries/fc097ca7-e2bc-405e-abe5-876e0d2fd3e7
