RuisoArt/PROJECT_MaterialOxidationMachine/Material Oxidation Machine/test/tkinter/tkinter_test_7/loot/doc_MaterialOxidationMachine_14_March_2024.txt

fecha hora temp1 temp2 temp3 nivel
14_March_2024 174129 20.13 19.00 19.53 0
14_March_2024 174129 20.13 19.00 19.53 0
14_March_2024 174129 20.13 19.00 19.53 0
14_March_2024 174129 20.13 19.00 19.53 0
14_March_2024 174129 20.13 19.00 19.53 0
14_March_2024 174129 20.13 19.00 19.53 0
14_March_2024 174130 20.13 19.00 19.53 0
14_March_2024 174130 20.13 19.00 19.53 0
14_March_2024 174130 20.13 19.00 19.53 0
14_March_2024 174130 20.13 19.00 19.53 0
14_March_2024 174130 20.13 19.00 19.53 0
14_March_2024 174130 20.13 19.00 19.53 0
14_March_2024 174131 20.13 19.00 19.53 0
14_March_2024 174131 20.13 19.00 19.53 0
14_March_2024 174131 20.13 19.00 19.53 0
14_March_2024 174131 20.13 19.00 19.53 0
14_March_2024 174131 20.13 19.00 19.53 0
14_March_2024 174131 20.13 19.00 19.53 0
14_March_2024 174131 20.13 19.00 19.53 0
14_March_2024 174131 20.13 19.00 19.53 0
14_March_2024 174131 20.13 19.00 19.53 0
14_March_2024 174132 20.13 19.00 19.53 0
14_March_2024 174132 20.13 19.00 19.53 0
14_March_2024 174132 20.13 19.00 19.53 0
14_March_2024 174132 20.13 19.00 19.53 0
14_March_2024 174132 20.13 19.00 19.53 0
14_March_2024 174132 20.13 19.00 19.53 0
14_March_2024 174133 20.13 19.00 19.53 0
14_March_2024 174133 20.13 19.00 19.53 0
14_March_2024 174133 20.13 19.00 19.53 0
14_March_2024 174133 20.13 19.00 19.53 0
14_March_2024 174133 20.13 19.00 19.53 0
14_March_2024 174133 20.13 19.00 19.53 0
14_March_2024 174133 20.13 19.00 19.53 0
14_March_2024 174133 20.13 19.00 19.53 0
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
14_March_2024 174910 20.00 19.00 25.88 0
14_March_2024 174912 20.00 19.00 25.39 0
14_March_2024 174914 20.06 19.00 24.90 0
14_March_2024 174915 20.06 19.00 24.41 0
14_March_2024 174917 20.06 19.00 24.41 0
14_March_2024 174918 20.06 19.00 23.93 0
14_March_2024 174920 20.06 19.00 23.93 0
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
