RuisoArt/PROJECT_MaterialOxidationMachine/Material Oxidation Machine/test/tkinter/tkinter_test_7/loot/doc_MaterialOxidationMachine_11_March_2024.txt

fecha hora temp1 temp2 temp3 nivel
11_March_2024 122545 88 53 47 1
11_March_2024 122545 88 53 47 1
11_March_2024 122545 88 53 47 1
11_March_2024 122545 95 40 53 1
11_March_2024 122545 95 40 53 1
11_March_2024 122545 95 40 53 1
11_March_2024 122546 46 37 20 0
11_March_2024 122546 46 37 20 0
11_March_2024 122546 46 37 20 0
11_March_2024 122546 32 50 16 0
11_March_2024 122546 32 50 16 0
11_March_2024 122546 32 50 16 0
11_March_2024 122546 80 41 64 1
11_March_2024 122546 80 41 64 1
11_March_2024 122546 80 41 64 1
11_March_2024 122547 70 12 7 1
11_March_2024 122547 70 12 7 1
11_March_2024 122547 70 12 7 1
11_March_2024 122547 19 6 45 1
11_March_2024 122547 19 6 45 1
11_March_2024 122547 19 6 45 1
11_March_2024 122548 37 40 53 0
11_March_2024 122548 37 40 53 0
11_March_2024 122548 37 40 53 0
11_March_2024 122548 74 35 24 1
11_March_2024 122548 74 35 24 1
11_March_2024 122548 74 35 24 1
11_March_2024 122548 89 12 87 0
11_March_2024 122548 89 12 87 0
11_March_2024 122548 89 12 87 0
11_March_2024 122549 41 2 61 0
11_March_2024 122549 41 2 61 0
11_March_2024 122549 41 2 61 0
11_March_2024 122549 35 82 63 0
11_March_2024 122549 35 82 63 0
11_March_2024 122549 35 82 63 0
11_March_2024 122550 10 30 87 0
11_March_2024 122550 10 30 87 0
11_March_2024 122550 10 30 87 0
11_March_2024 122550 97 66 81 0
11_March_2024 122550 97 66 81 0
11_March_2024 122550 97 66 81 0
11_March_2024 122550 73 36 81 0
11_March_2024 122550 73 36 81 0
11_March_2024 122550 73 36 81 0
11_March_2024 122551 25 55 75 0
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
11_March_2024 122644 16 41 28 1
11_March_2024 122644 80 56 41 0
11_March_2024 122644 80 56 41 0
11_March_2024 122644 80 56 41 0
11_March_2024 122644 33 68 45 1
11_March_2024 122644 33 68 45 1
11_March_2024 122644 33 68 45 1
11_March_2024 122645 54 90 95 1
11_March_2024 122645 54 90 95 1
11_March_2024 122645 54 90 95 1
11_March_2024 122645 39 84 36 1
11_March_2024 122645 39 84 36 1
11_March_2024 122645 39 84 36 1
11_March_2024 122646 18 91 45 0
11_March_2024 122646 18 91 45 0
11_March_2024 122646 18 91 45 0
11_March_2024 122646 61 77 24 0
11_March_2024 122646 61 77 24 0
11_March_2024 122646 61 77 24 0
11_March_2024 122646 87 16 98 1
11_March_2024 122646 87 16 98 1
11_March_2024 122646 87 16 98 1
11_March_2024 122647 52 55 83 0
11_March_2024 122647 52 55 83 0
11_March_2024 122647 52 55 83 0
11_March_2024 122647 19 50 52 0
11_March_2024 122647 19 50 52 0
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
