RuisoArt/PROJECT_MaterialOxidationMachine/Material Oxidation Machine/assets/diagram/71Imagen.png

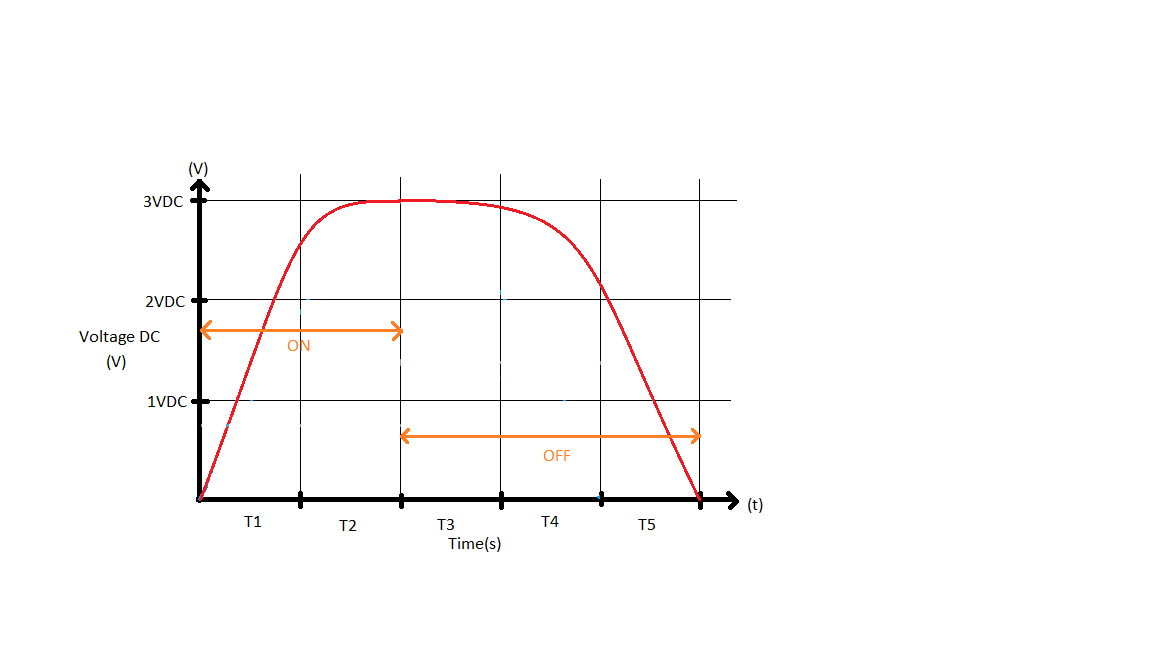
Material Oxidation Machine/assets/diagram/71Imagen.png
