RuisoArt/PROJECT_MaterialOxidationMachine/Material Oxidation Machine/assets/diagram/72imagen.png

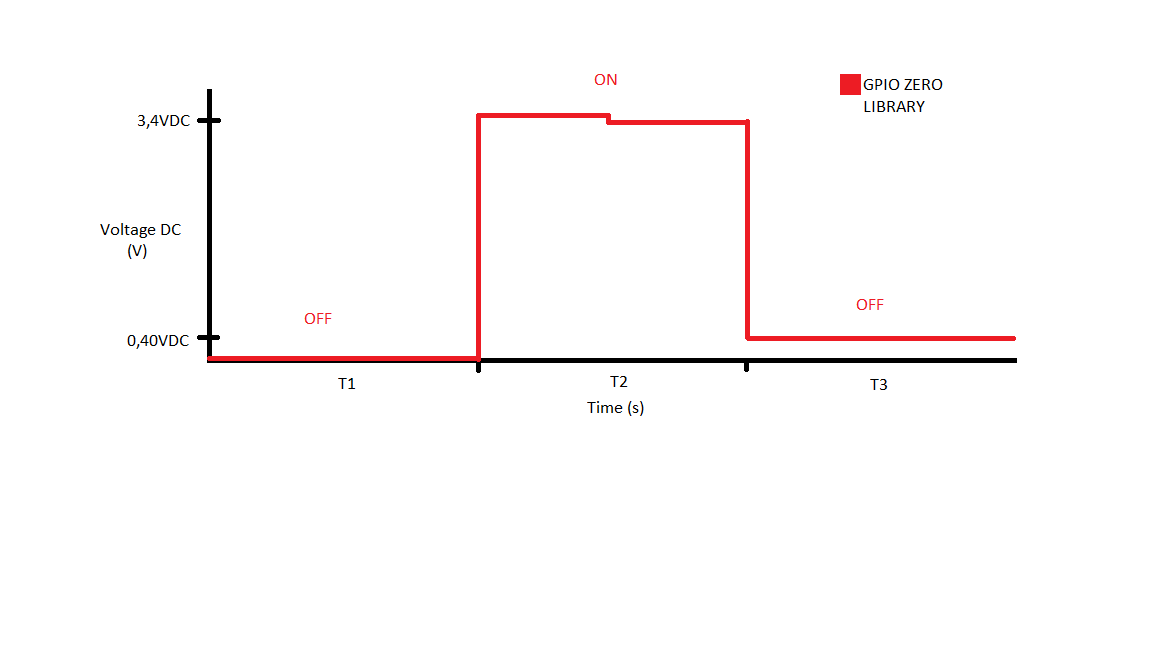
Material Oxidation Machine/assets/diagram/72imagen.png
