RuisoArt/PROJECT_MaterialOxidationMachine/Material Oxidation Machine/assets/diagram/73IMAGEN.png

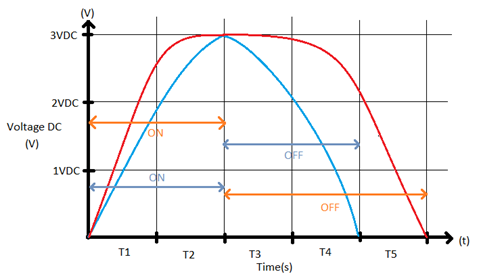
Material Oxidation Machine/assets/diagram/73IMAGEN.png
