RuisoArt/PROJECT_MaterialOxidationMachine/Material Oxidation Machine/assets/diagram/Alternative analysis.jpg

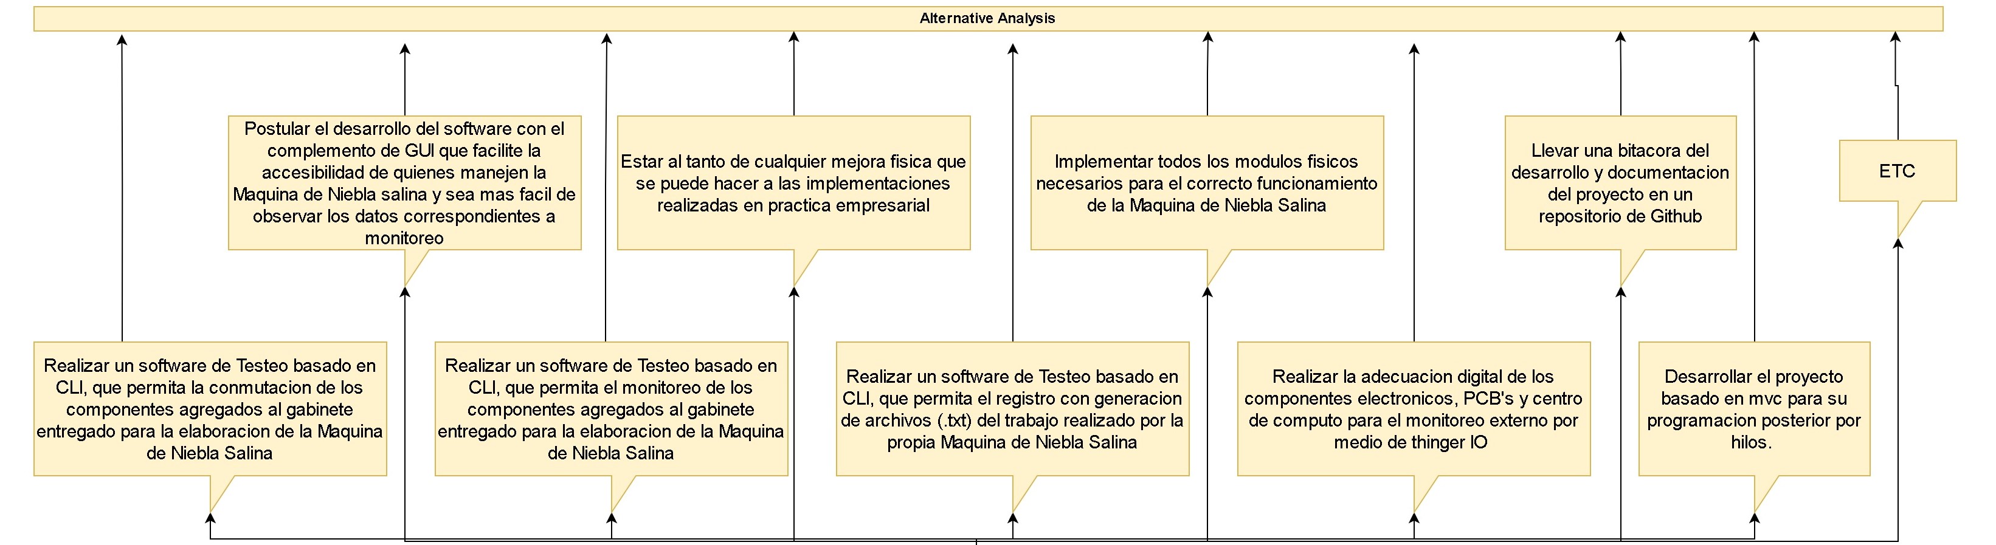
Material Oxidation Machine/assets/diagram/Alternative analysis.jpg
