RuisoArt/PROJECT_MaterialOxidationMachine/Material Oxidation Machine/assets/diagram/Analytical Project Structure.jpg

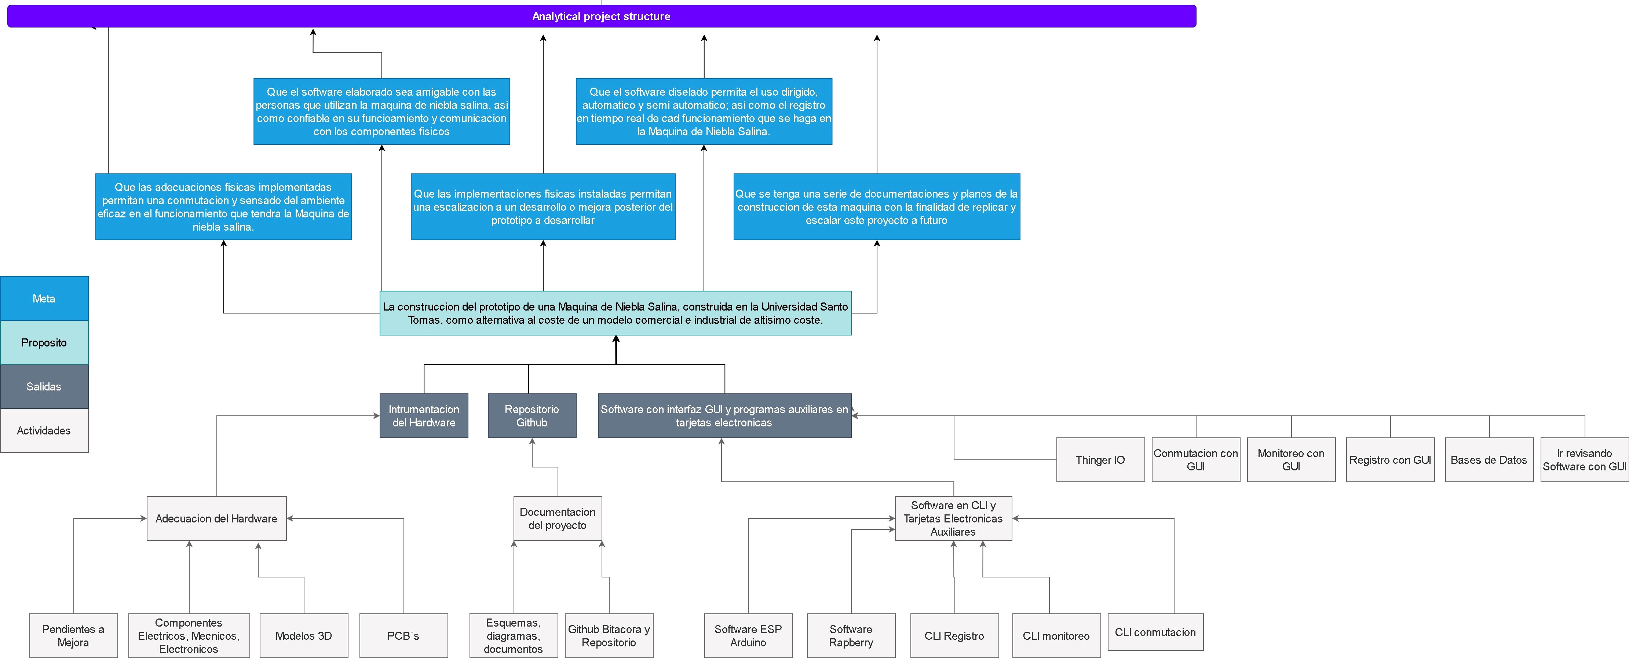
Material Oxidation Machine/assets/diagram/Analytical Project Structure.jpg
