RuisoArt/PROJECT_MaterialOxidationMachine/Material Oxidation Machine/assets/diagram/Capitulo IV Los Jurados - copia.jpg

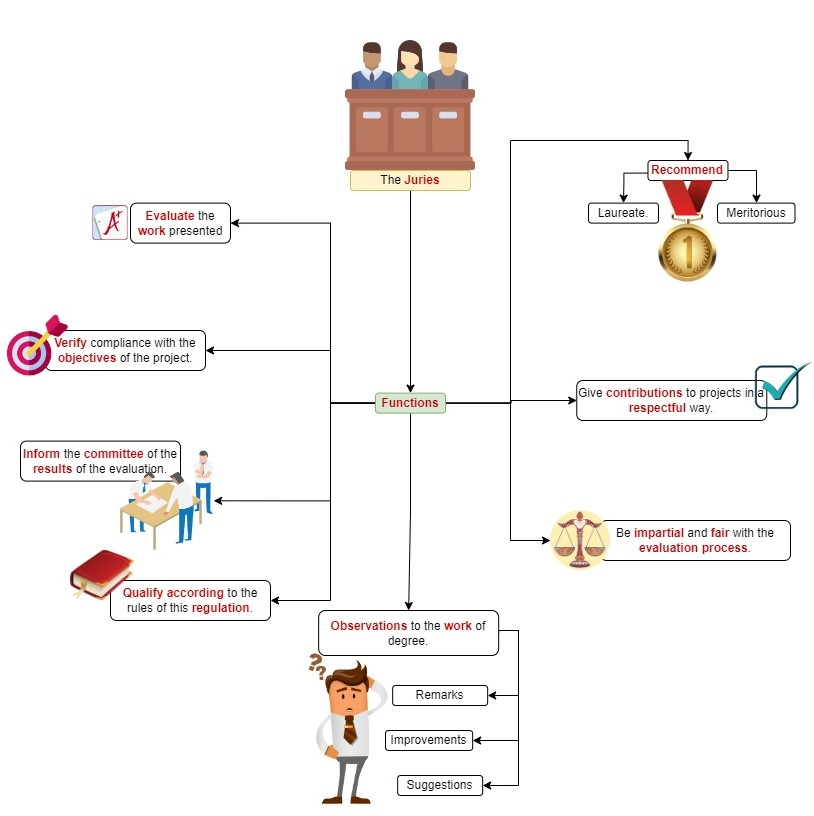
Material Oxidation Machine/assets/diagram/Capitulo IV Los Jurados - copia.jpg
