RuisoArt/PROJECT_MaterialOxidationMachine/Material Oxidation Machine/assets/diagram/Capitulo IV Los Jurados.jpg

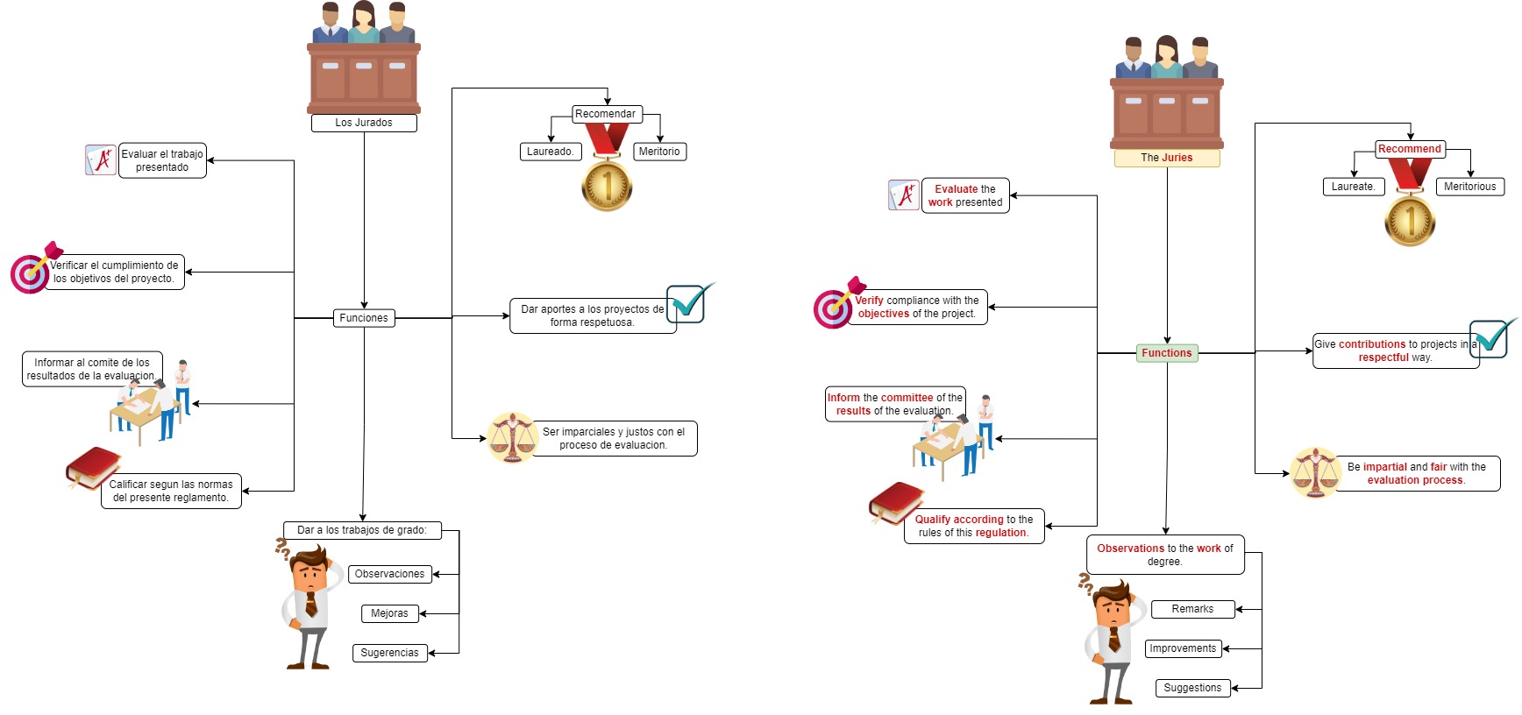
Material Oxidation Machine/assets/diagram/Capitulo IV Los Jurados.jpg
