RuisoArt/PROJECT_MaterialOxidationMachine/Material Oxidation Machine/assets/diagram/Captura de pantalla 2023-11-16 144829.png

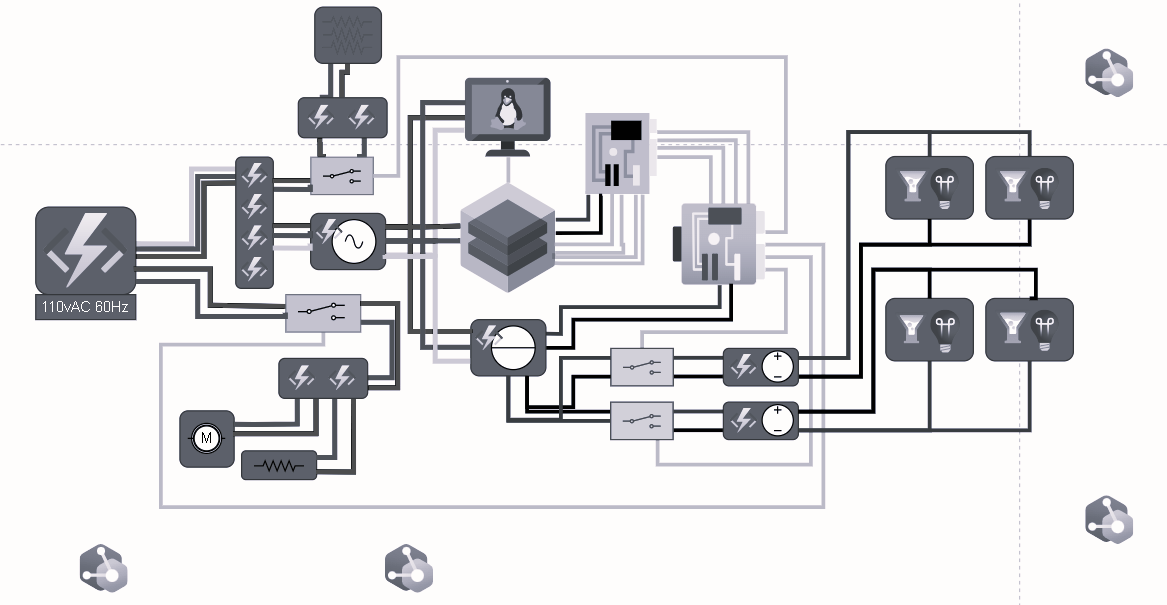
Material Oxidation Machine/assets/diagram/Captura de pantalla 2023-11-16 144829.png
