RuisoArt/PROJECT_MaterialOxidationMachine/Material Oxidation Machine/assets/diagram/diagrama conexion general.jpg

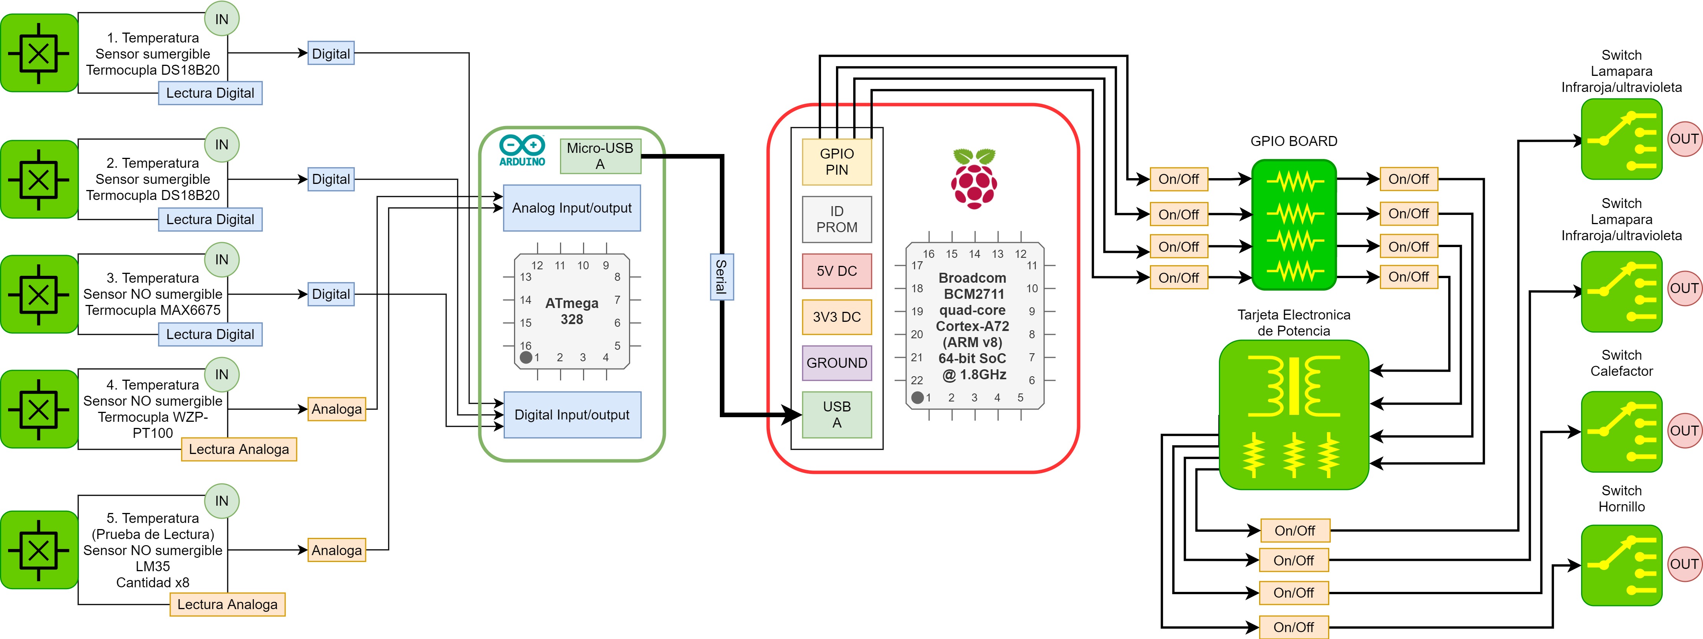
Material Oxidation Machine/assets/diagram/diagrama conexion general.jpg
