RuisoArt/PROJECT_MaterialOxidationMachine/Material Oxidation Machine/assets/diagram/Diagrama softeare Arduino.jpg

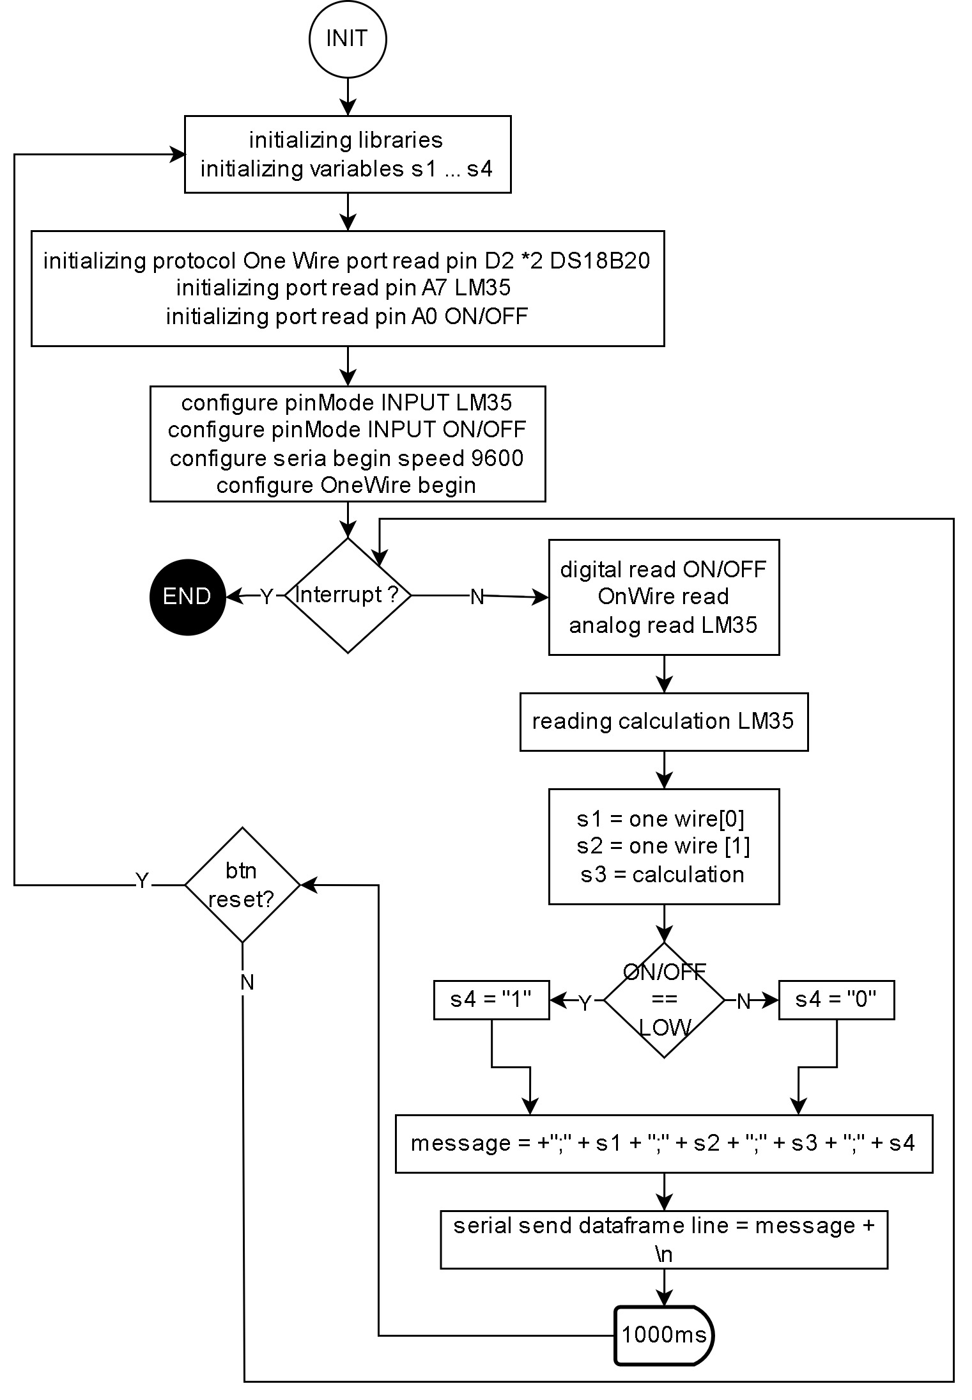
Material Oxidation Machine/assets/diagram/Diagrama softeare Arduino.jpg
