RuisoArt/PROJECT_MaterialOxidationMachine/Material Oxidation Machine/assets/diagram/Diagrama software button emergency.jpg

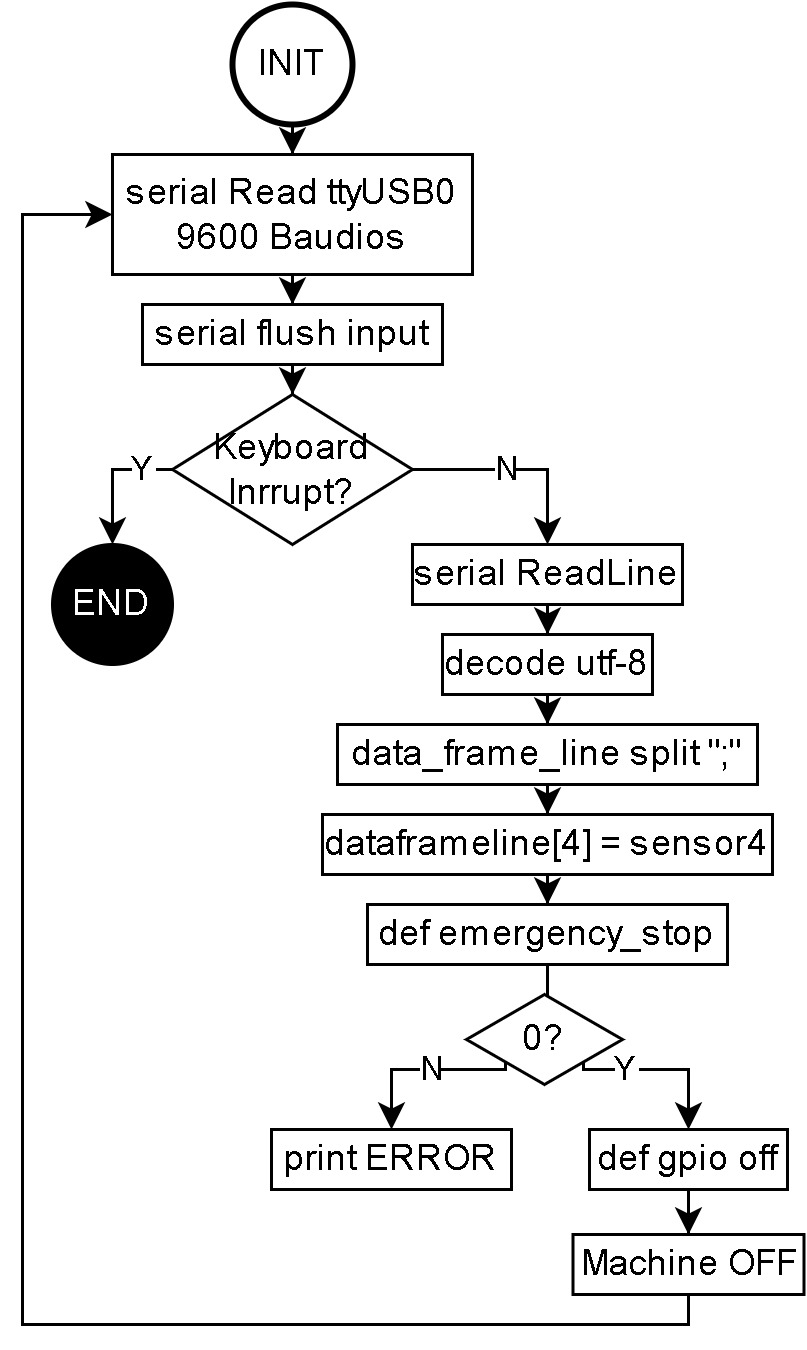
Material Oxidation Machine/assets/diagram/Diagrama software button emergency.jpg
