RuisoArt/PROJECT_MaterialOxidationMachine/Material Oxidation Machine/assets/diagram/diagrama software control dash.jpg

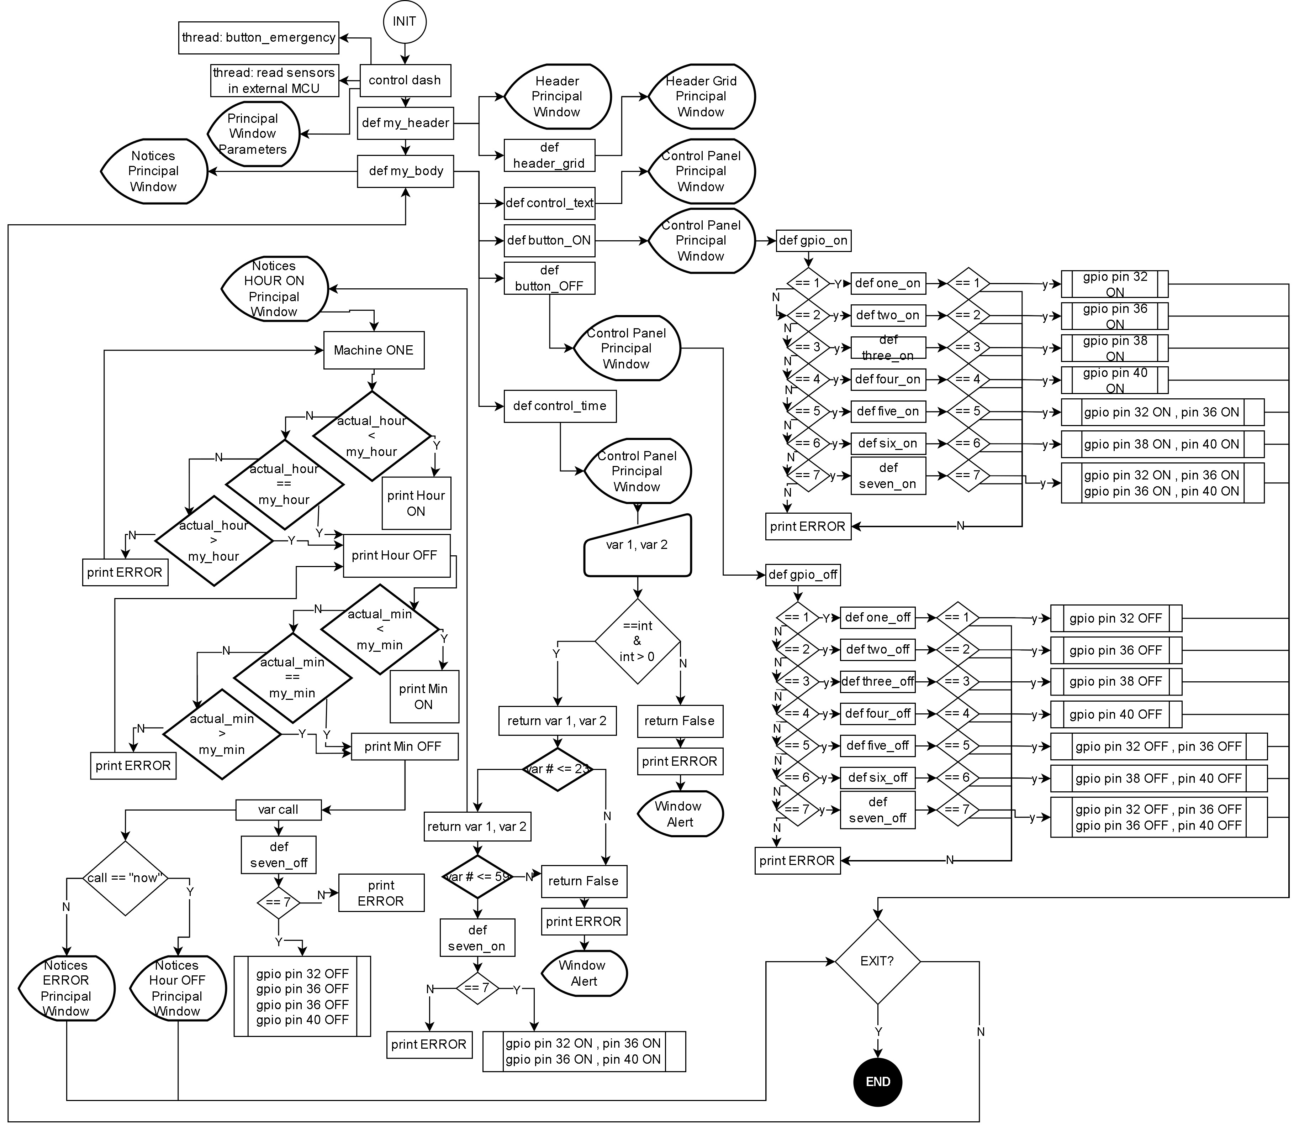
Material Oxidation Machine/assets/diagram/diagrama software control dash.jpg
