RuisoArt/PROJECT_MaterialOxidationMachine/Material Oxidation Machine/assets/diagram/Diagrama software lectura read MCU.jpg

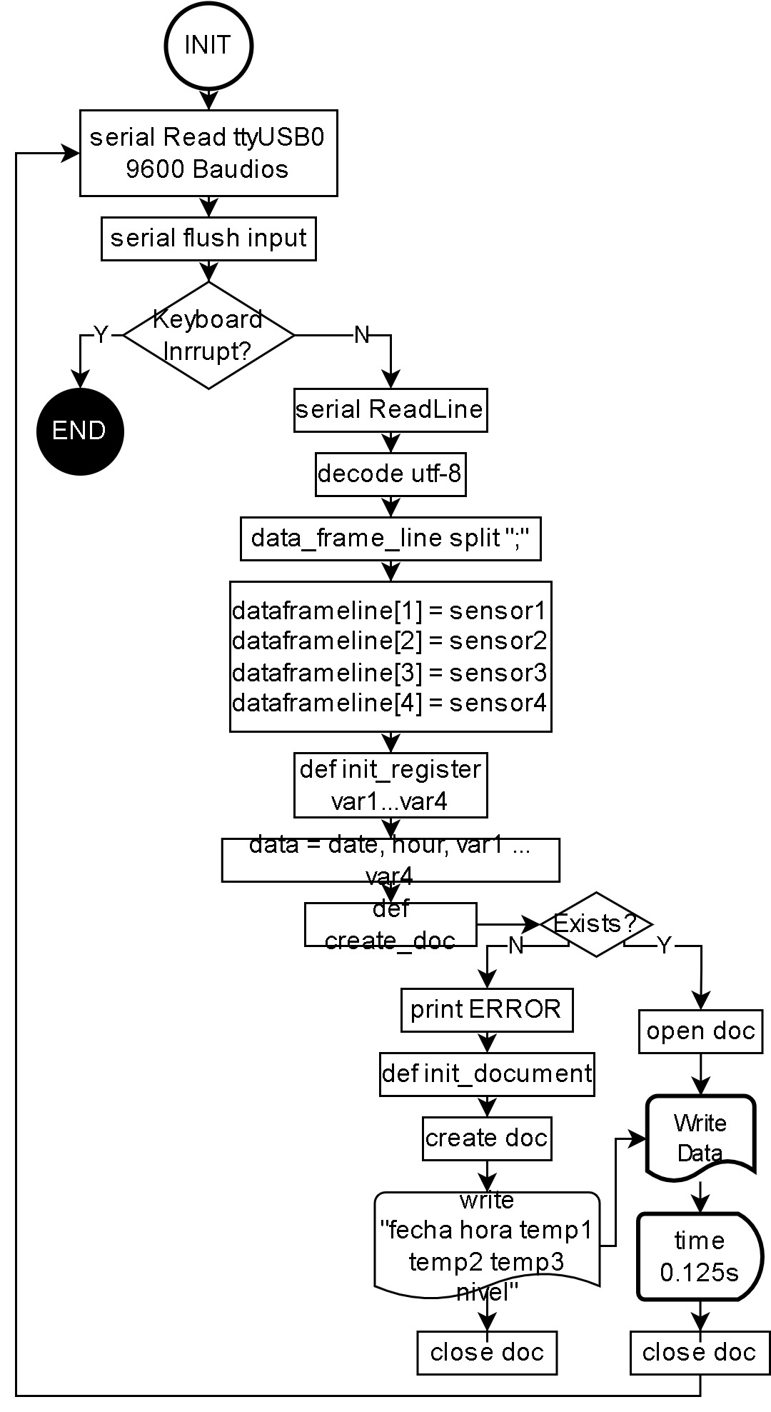
Material Oxidation Machine/assets/diagram/Diagrama software lectura read MCU.jpg
