RuisoArt/PROJECT_MaterialOxidationMachine/Material Oxidation Machine/assets/diagram/diagrama software register dash.jpg

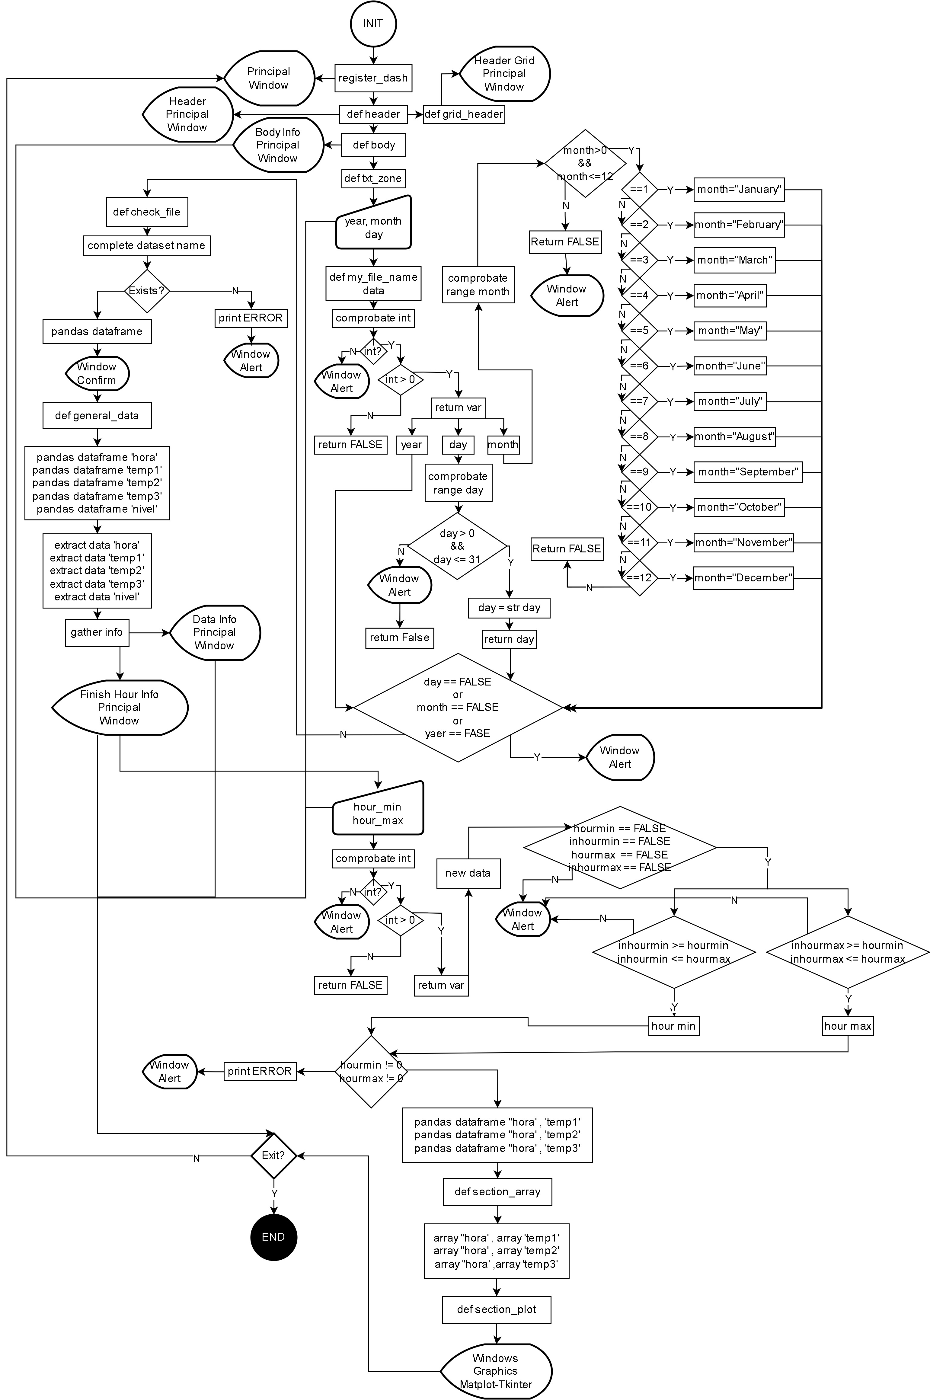
Material Oxidation Machine/assets/diagram/diagrama software register dash.jpg
