RuisoArt/PROJECT_MaterialOxidationMachine/Material Oxidation Machine/assets/diagram/Logical Framework ve3 [Luis Felipe Narvaez Gomez 2312660].jpg

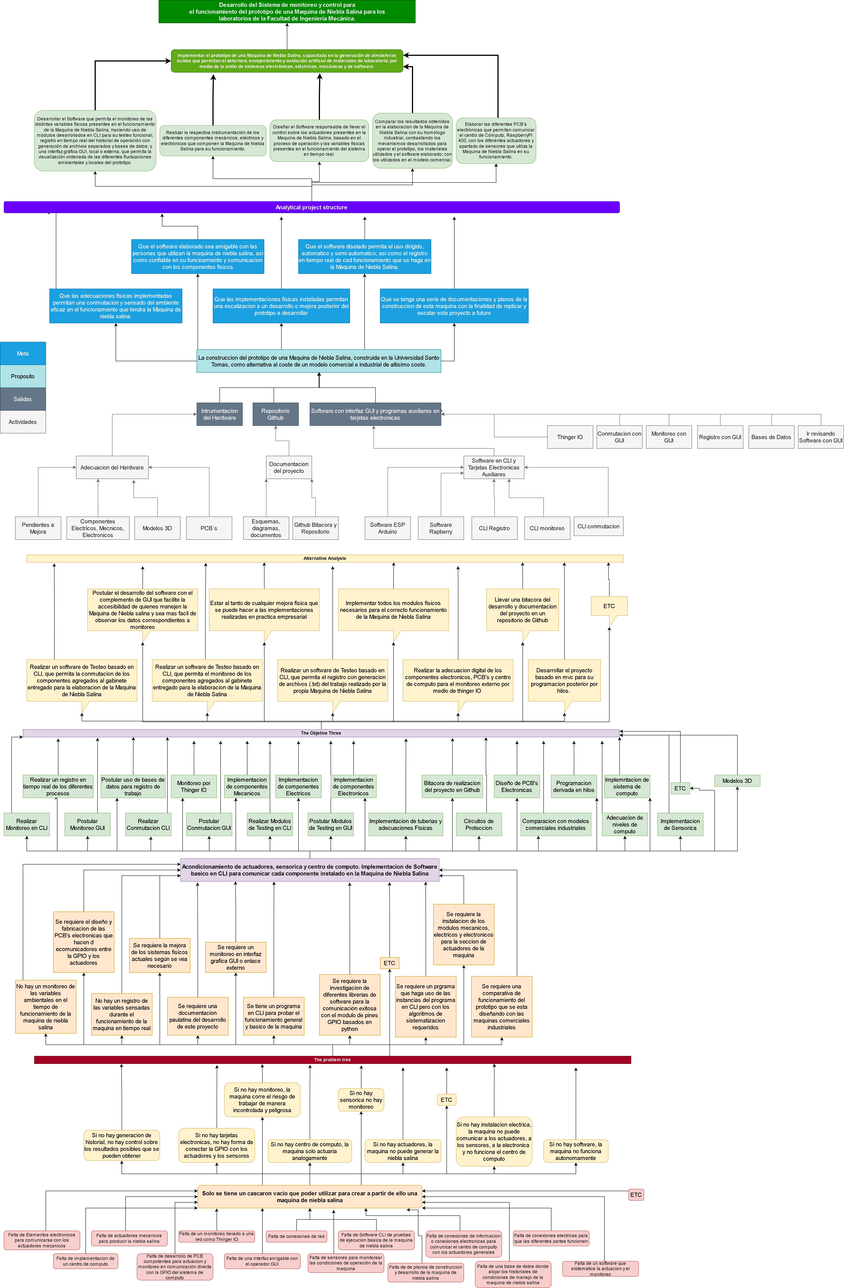
Material Oxidation Machine/assets/diagram/Logical Framework ve3 [Luis Felipe Narvaez Gomez 2312660].jpg
