RuisoArt/PROJECT_MaterialOxidationMachine/Material Oxidation Machine/assets/diagram/The Objetive Tree.jpg

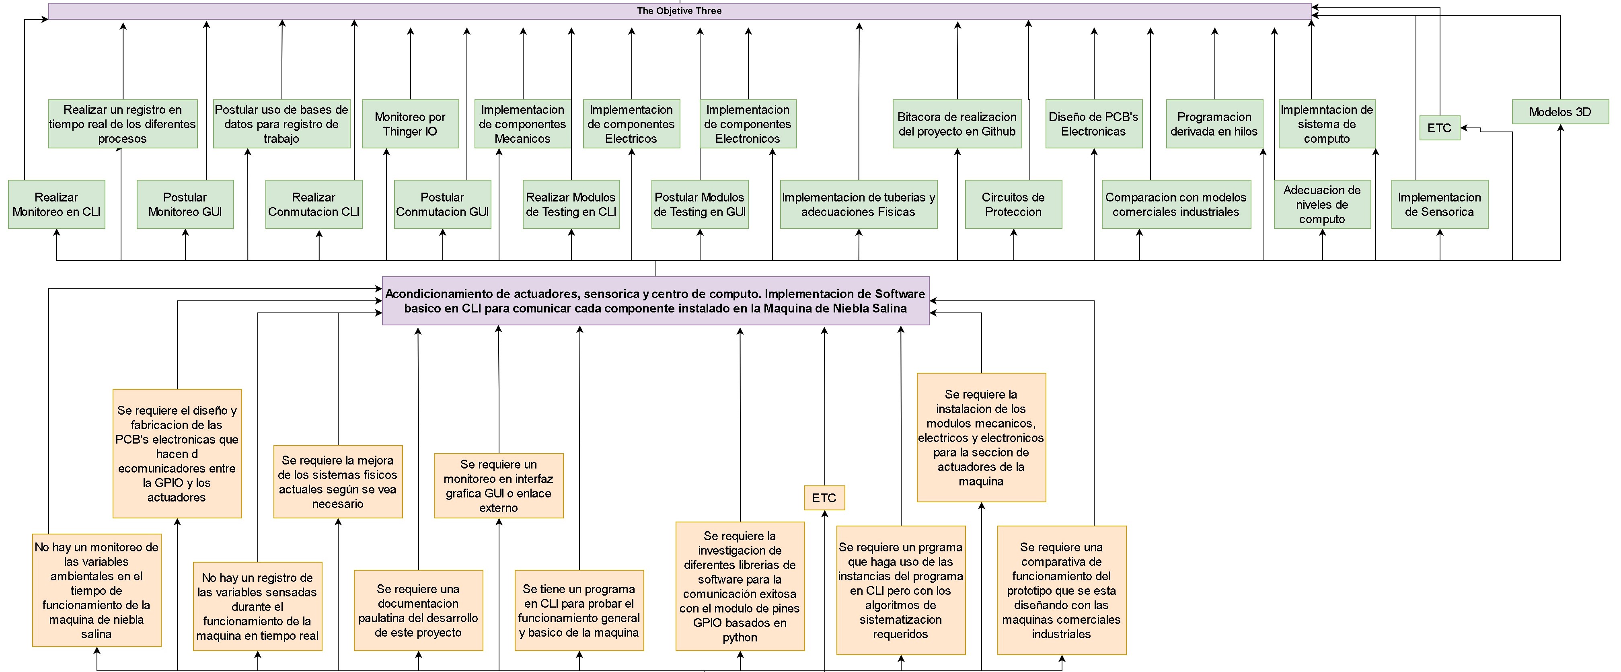
Material Oxidation Machine/assets/diagram/The Objetive Tree.jpg
