RuisoArt/PROJECT_MaterialOxidationMachine/Material Oxidation Machine/assets/diagram/WBS_diagram Maquina de Niebla Salina [Luis Felipe Narvaez Gomez - 2312660].jpg

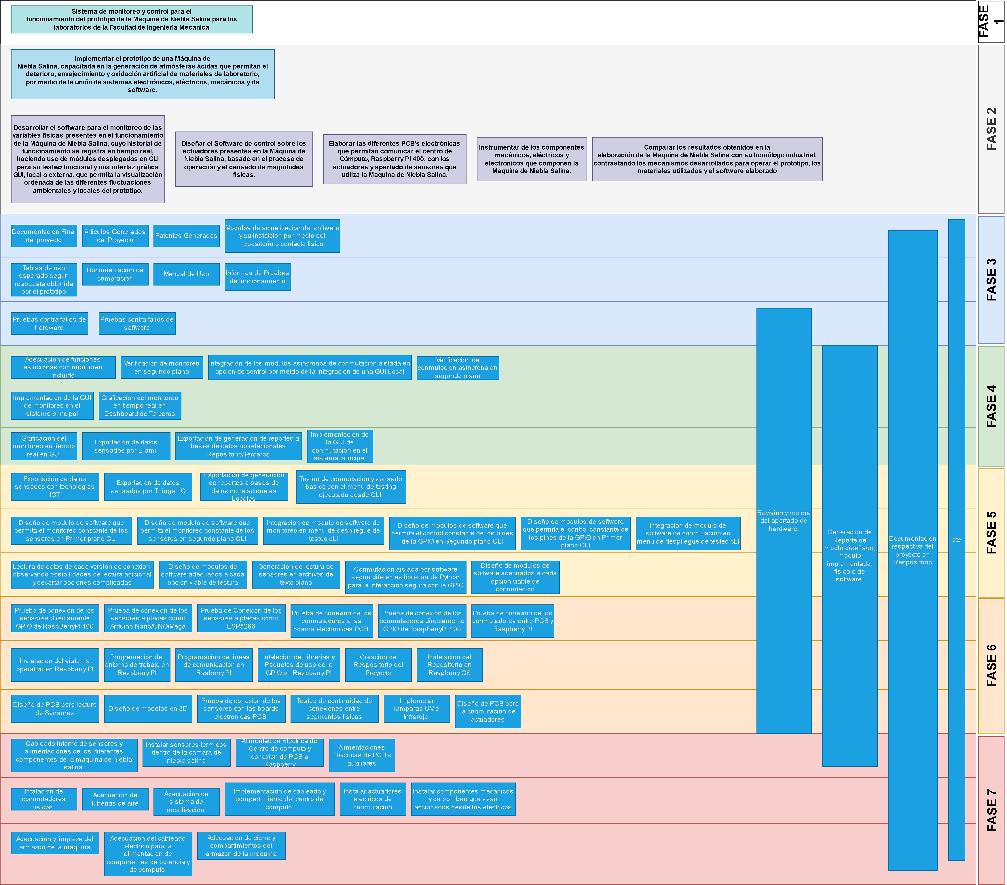
Material Oxidation Machine/assets/diagram/WBS_diagram Maquina de Niebla Salina [Luis Felipe Narvaez Gomez - 2312660].jpg
