RuisoArt/PROJECT_MaterialOxidationMachine/Material Oxidation Machine/assets/doc/prestamo_materiales/documento salida de materiales de la universidad.jpg

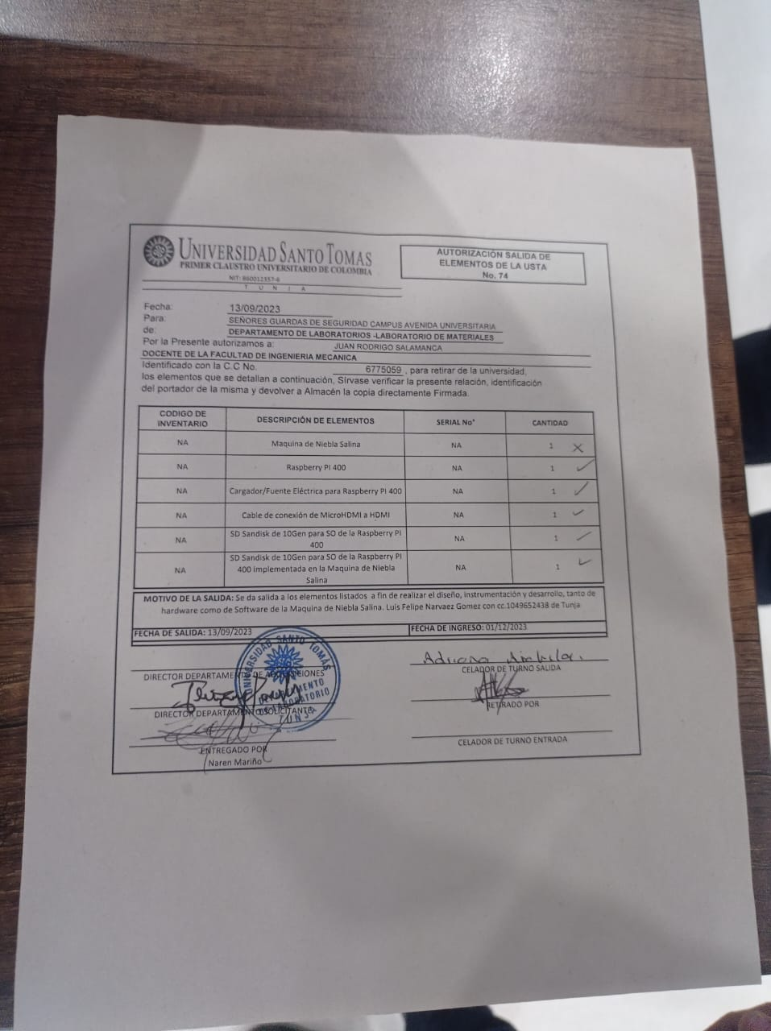
Material Oxidation Machine/assets/doc/prestamo_materiales/documento salida de materiales de la universidad.jpg
