RuisoArt/PROJECT_MaterialOxidationMachine/Material Oxidation Machine/assets/doc/trabajo_grado_1/activity_Juries_chapterIV/Kahoot.png

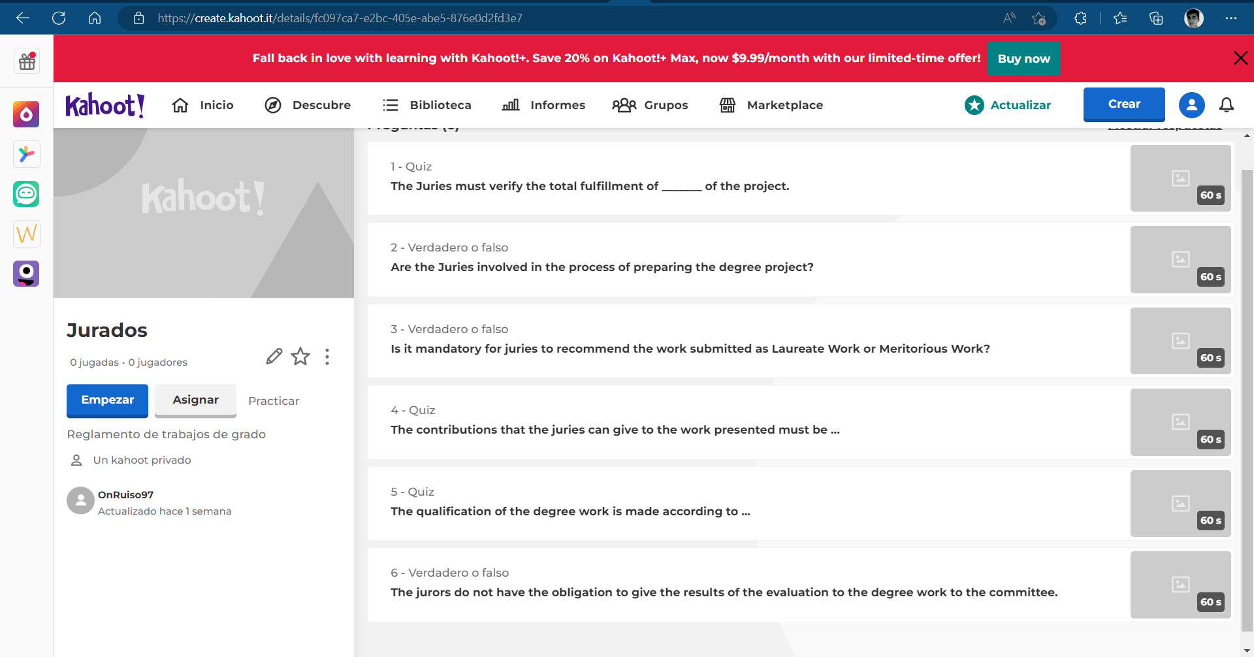
Material Oxidation Machine/assets/doc/trabajo_grado_1/activity_Juries_chapterIV/Kahoot.png
