RuisoArt/PROJECT_MaterialOxidationMachine/Material Oxidation Machine/assets/doc/trabajo_grado_1/img/Recibo Examen de Suficiencia Trabajo de Grado I.jpeg

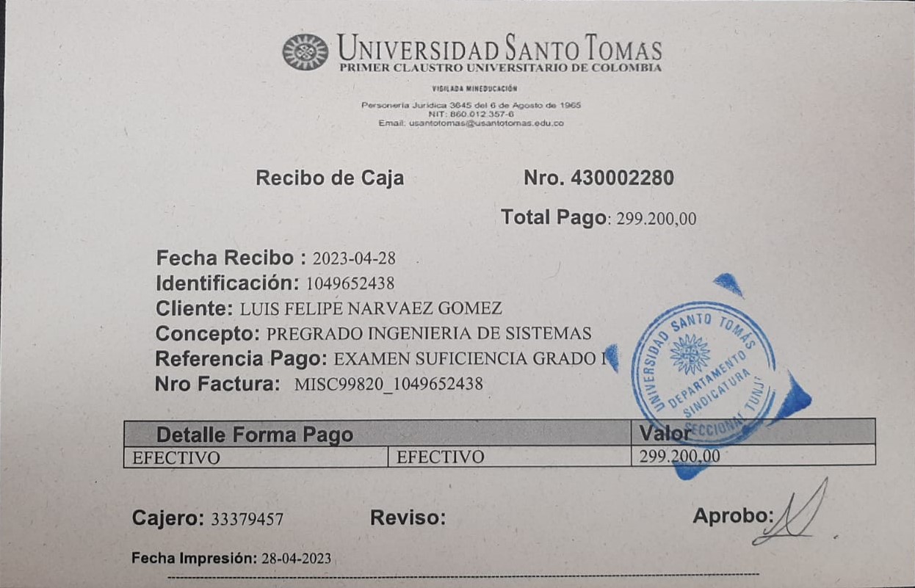
Material Oxidation Machine/assets/doc/trabajo_grado_1/img/Recibo Examen de Suficiencia Trabajo de Grado I.jpeg
