RuisoArt/PROJECT_MaterialOxidationMachine/Material Oxidation Machine/assets/doc/trabajo_grado_1/tematica/linuxcomandos-2d76e113-5891-40c2-a8b7-f508d3b43f2e.jpg

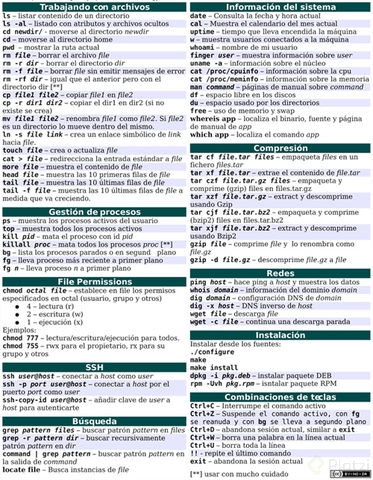
Material Oxidation Machine/assets/doc/trabajo_grado_1/tematica/linuxcomandos-2d76e113-5891-40c2-a8b7-f508d3b43f2e.jpg
