RuisoArt/PROJECT_MaterialOxidationMachine/Material Oxidation Machine/assets/doc/trabajo_grado_1/tematica/SFIA Skills and competency.png

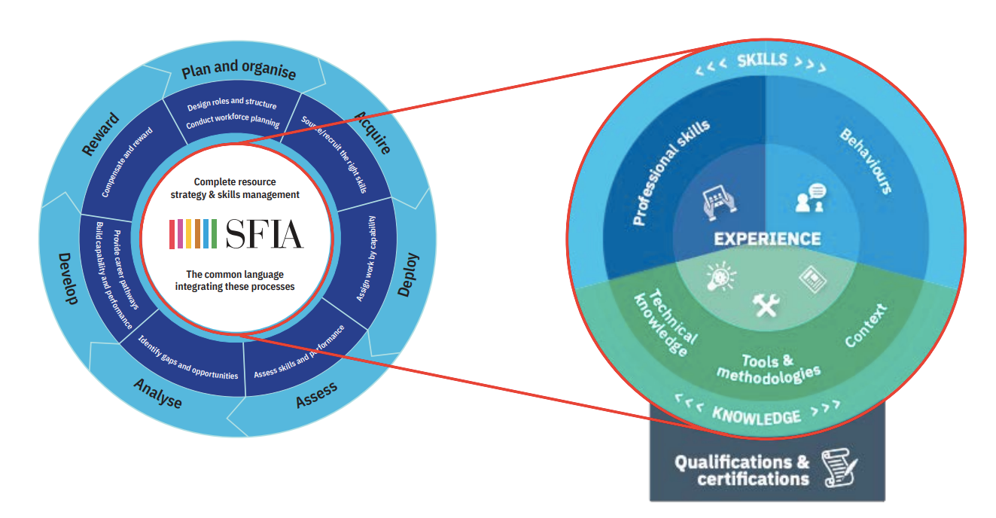
Material Oxidation Machine/assets/doc/trabajo_grado_1/tematica/SFIA Skills and competency.png
