RuisoArt/PROJECT_MaterialOxidationMachine/Material Oxidation Machine/assets/photo/20220908_215330.jpg

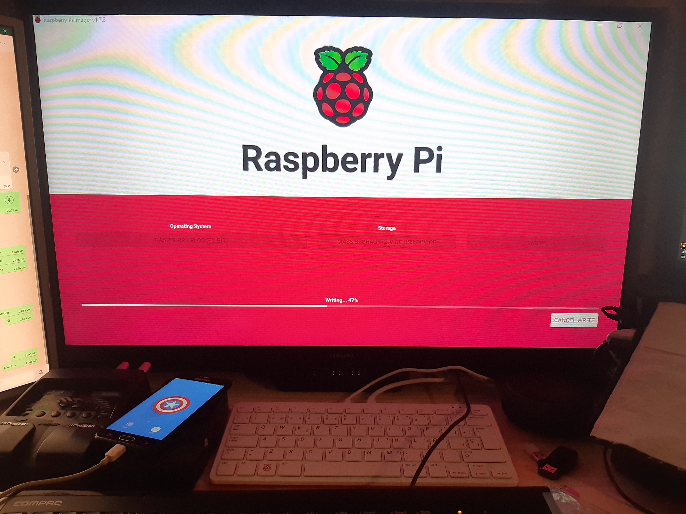
Material Oxidation Machine/assets/photo/20220908_215330.jpg
