RuisoArt/PROJECT_MaterialOxidationMachine/Material Oxidation Machine/assets/photo/20220908_220619.jpg

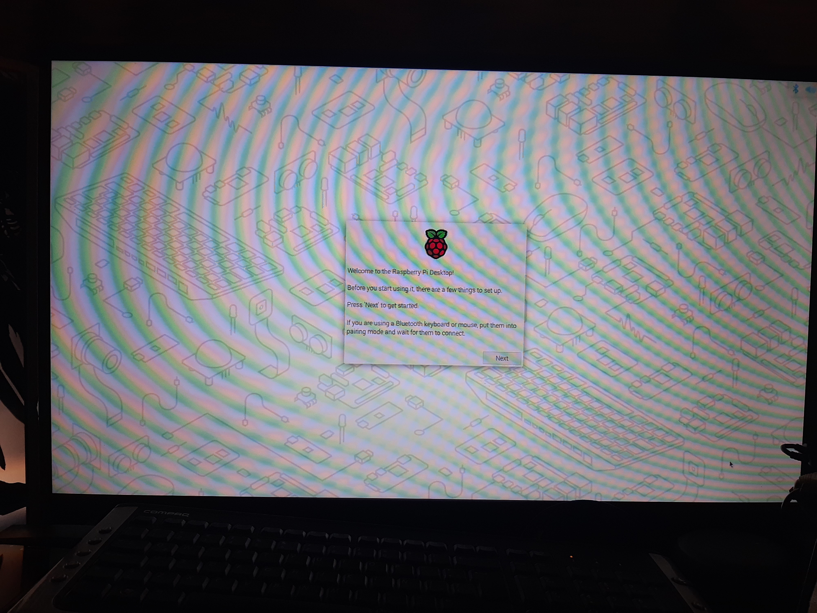
Material Oxidation Machine/assets/photo/20220908_220619.jpg
