RuisoArt/PROJECT_MaterialOxidationMachine/Material Oxidation Machine/assets/photo/20220908_221122.jpg

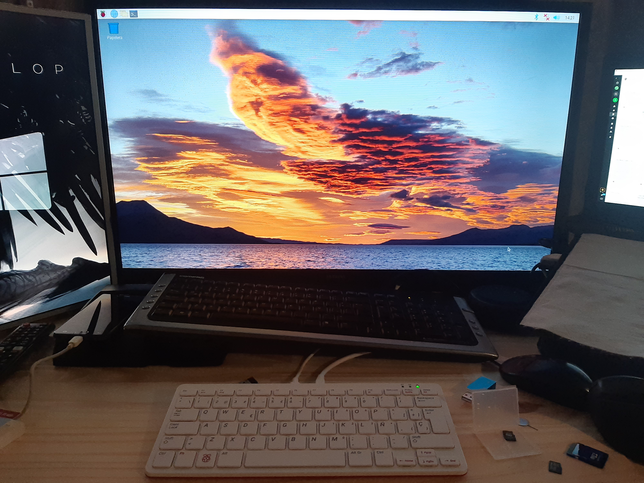
Material Oxidation Machine/assets/photo/20220908_221122.jpg
