RuisoArt/PROJECT_MaterialOxidationMachine/Material Oxidation Machine/assets/photo/20220916_172939.jpg

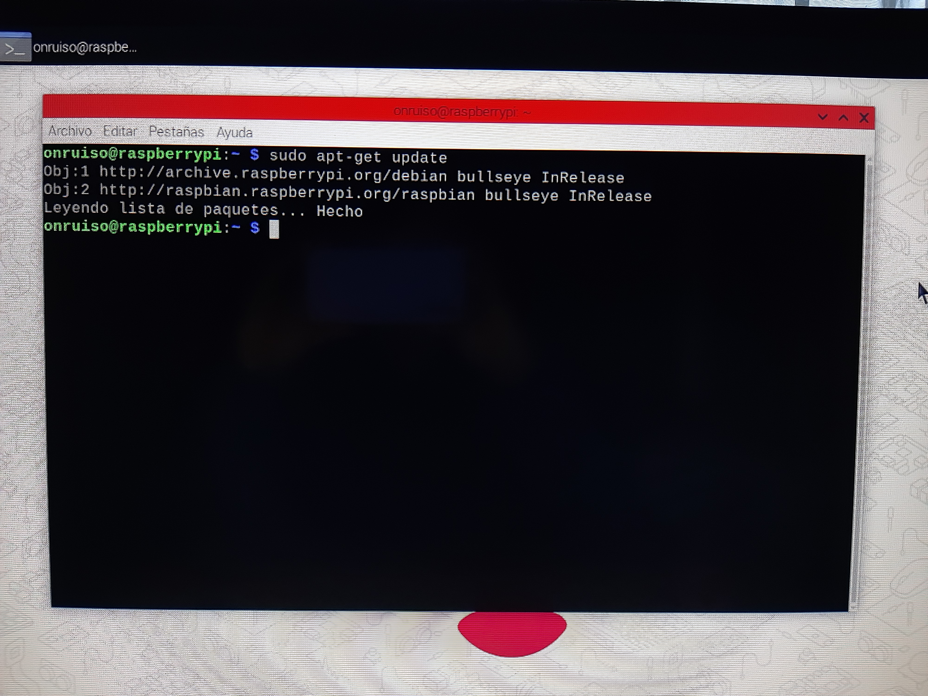
Material Oxidation Machine/assets/photo/20220916_172939.jpg
