RuisoArt/PROJECT_MaterialOxidationMachine/Material Oxidation Machine/assets/photo/20220916_173648.jpg

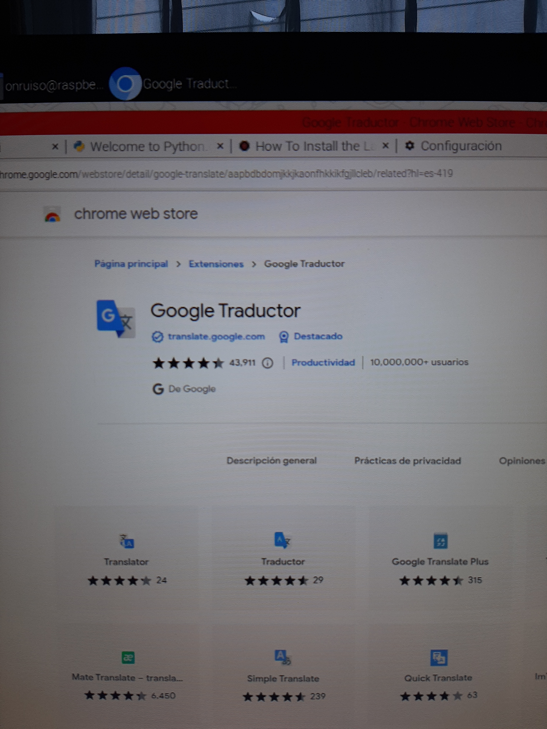
Material Oxidation Machine/assets/photo/20220916_173648.jpg
