RuisoArt/PROJECT_MaterialOxidationMachine/Material Oxidation Machine/assets/photo/20220916_173834.jpg

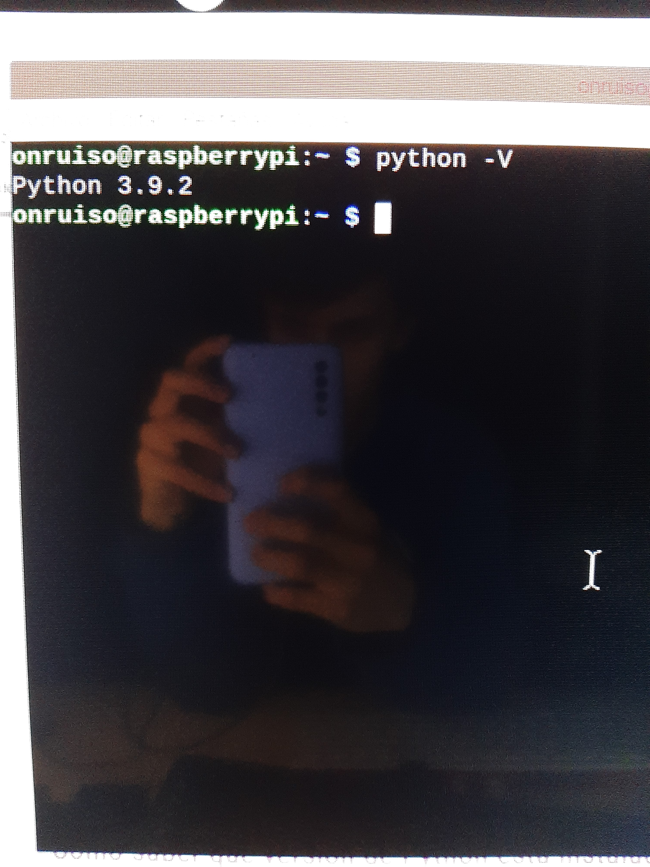
Material Oxidation Machine/assets/photo/20220916_173834.jpg
