RuisoArt/PROJECT_MaterialOxidationMachine/Material Oxidation Machine/assets/photo/20220916_173852.jpg

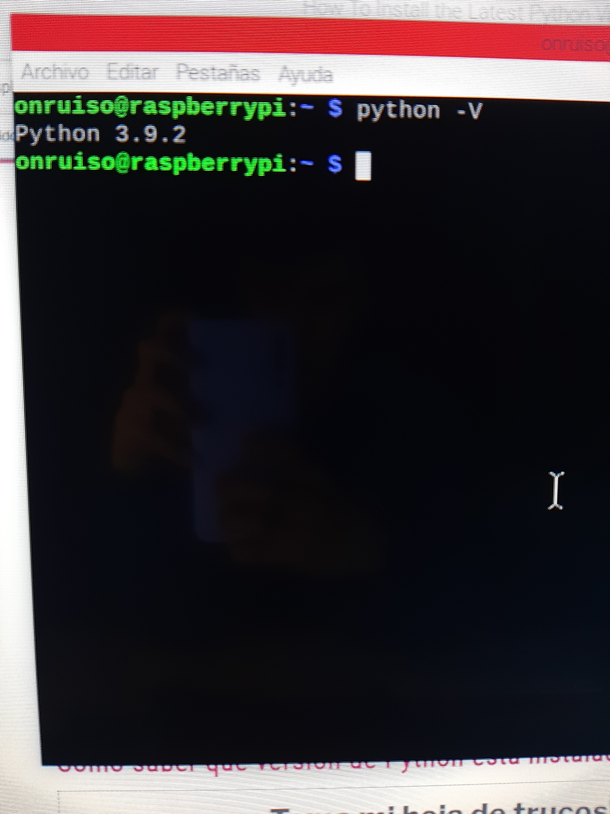
Material Oxidation Machine/assets/photo/20220916_173852.jpg
