RuisoArt/PROJECT_MaterialOxidationMachine/Material Oxidation Machine/assets/photo/20220920_101809.jpg

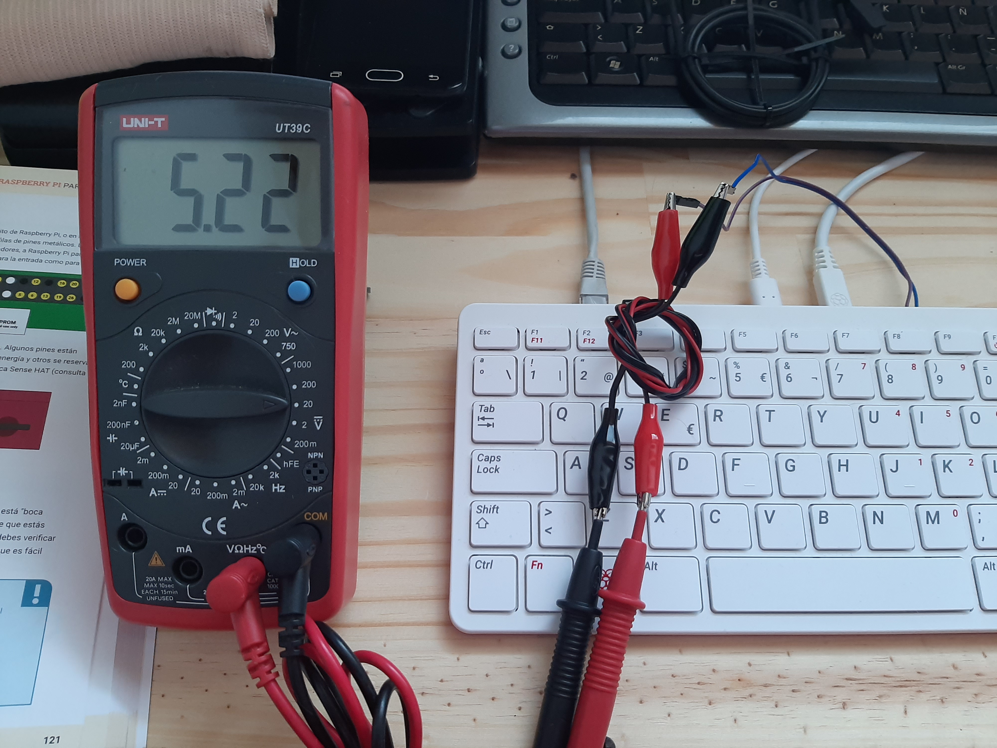
Material Oxidation Machine/assets/photo/20220920_101809.jpg
