RuisoArt/PROJECT_MaterialOxidationMachine/Material Oxidation Machine/assets/photo/20220920_135745.jpg

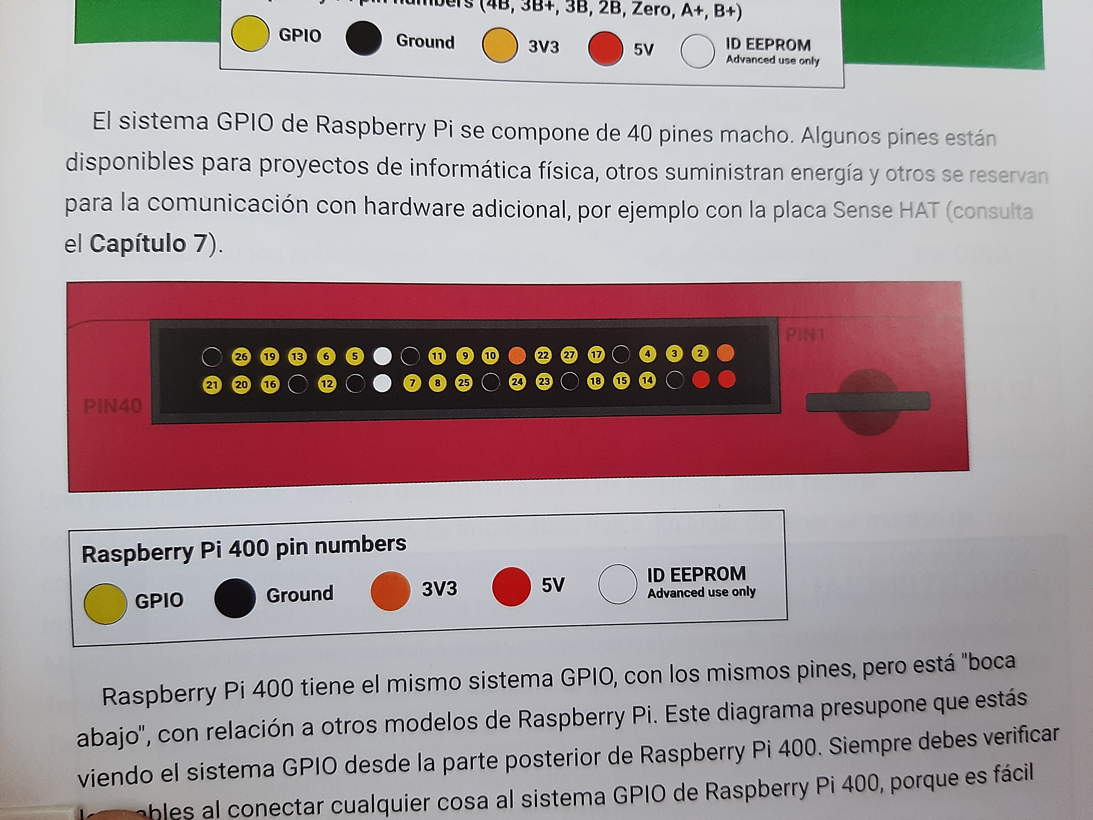
Material Oxidation Machine/assets/photo/20220920_135745.jpg
