RuisoArt/PROJECT_MaterialOxidationMachine/Material Oxidation Machine/assets/photo/20220920_140313.jpg

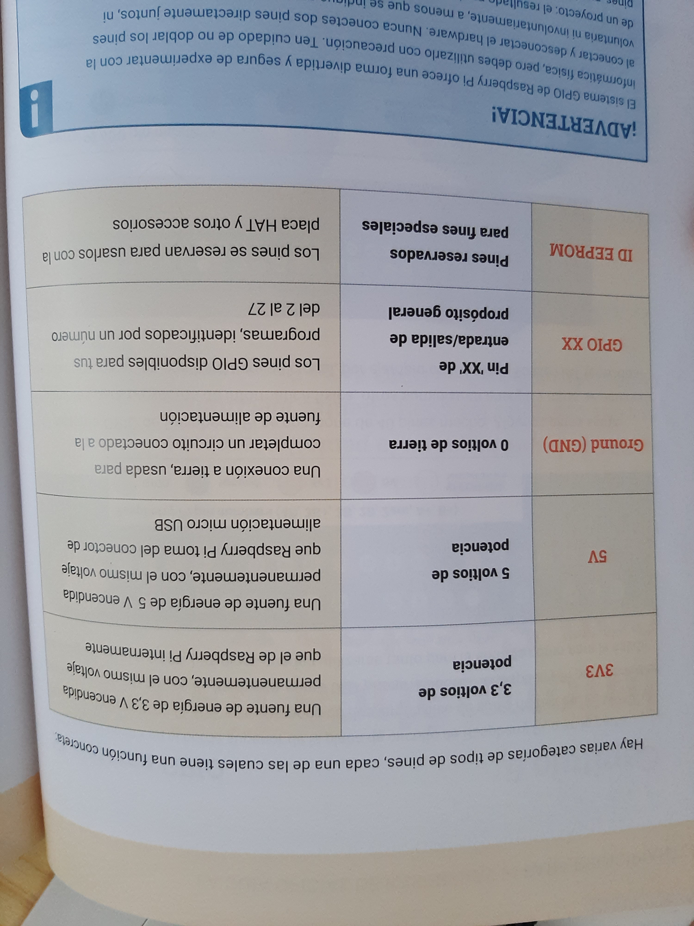
Material Oxidation Machine/assets/photo/20220920_140313.jpg
