RuisoArt/PROJECT_MaterialOxidationMachine/Material Oxidation Machine/assets/photo/20220930_061232.jpg

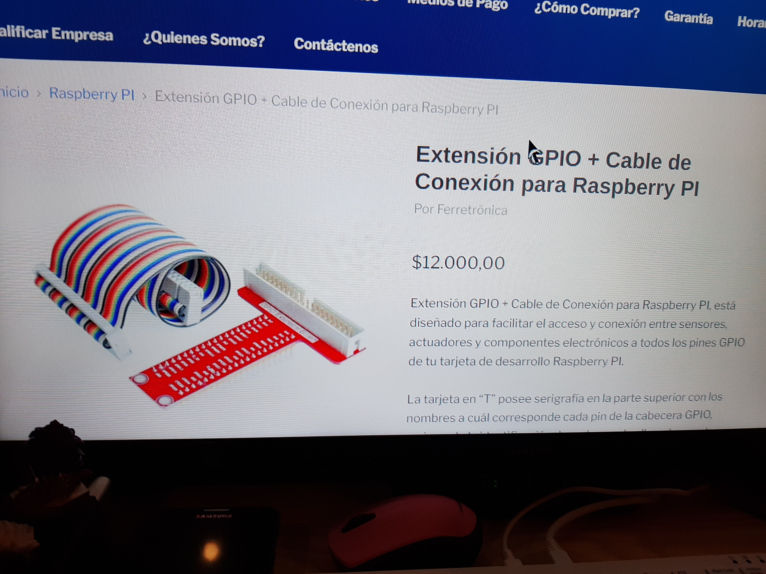
Material Oxidation Machine/assets/photo/20220930_061232.jpg
