RuisoArt/PROJECT_MaterialOxidationMachine/Material Oxidation Machine/assets/photo/20220930_094853.jpg

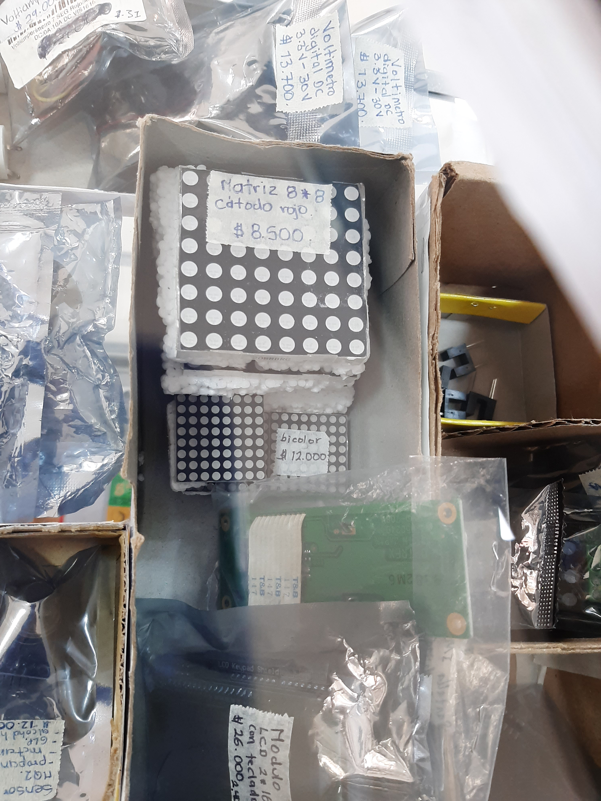
Material Oxidation Machine/assets/photo/20220930_094853.jpg
