RuisoArt/PROJECT_MaterialOxidationMachine/Material Oxidation Machine/assets/photo/20220930_095018.jpg

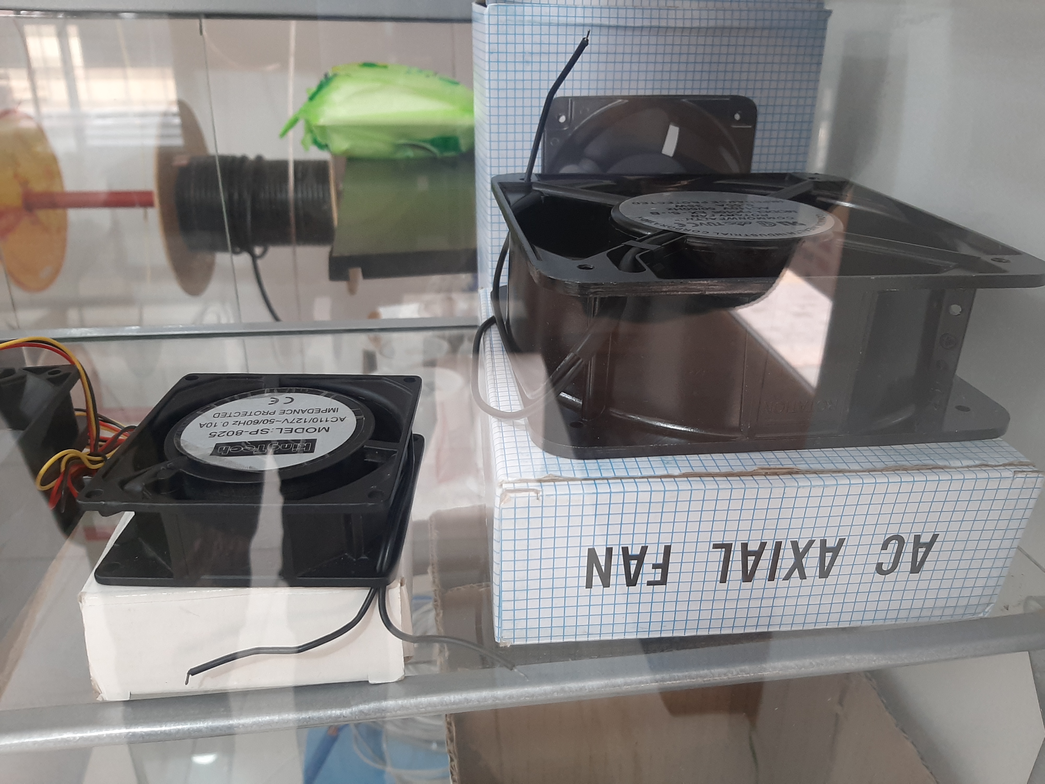
Material Oxidation Machine/assets/photo/20220930_095018.jpg
