RuisoArt/PROJECT_MaterialOxidationMachine/Material Oxidation Machine/assets/photo/20221019_122226.jpg

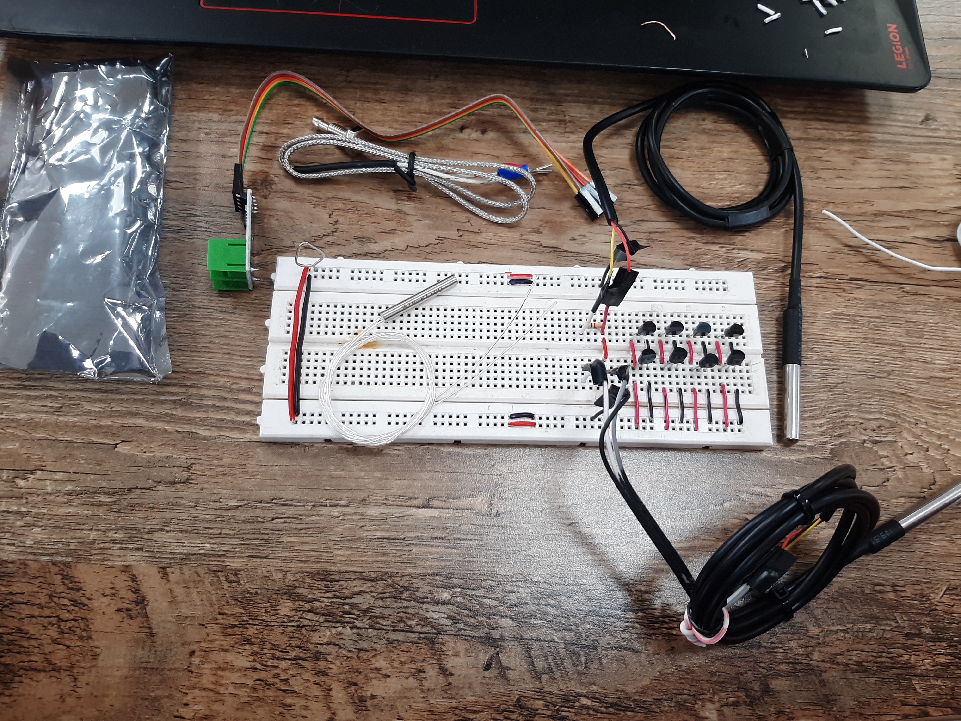
Material Oxidation Machine/assets/photo/20221019_122226.jpg
