RuisoArt/PROJECT_MaterialOxidationMachine/Material Oxidation Machine/assets/photo/20221019_152213.jpg

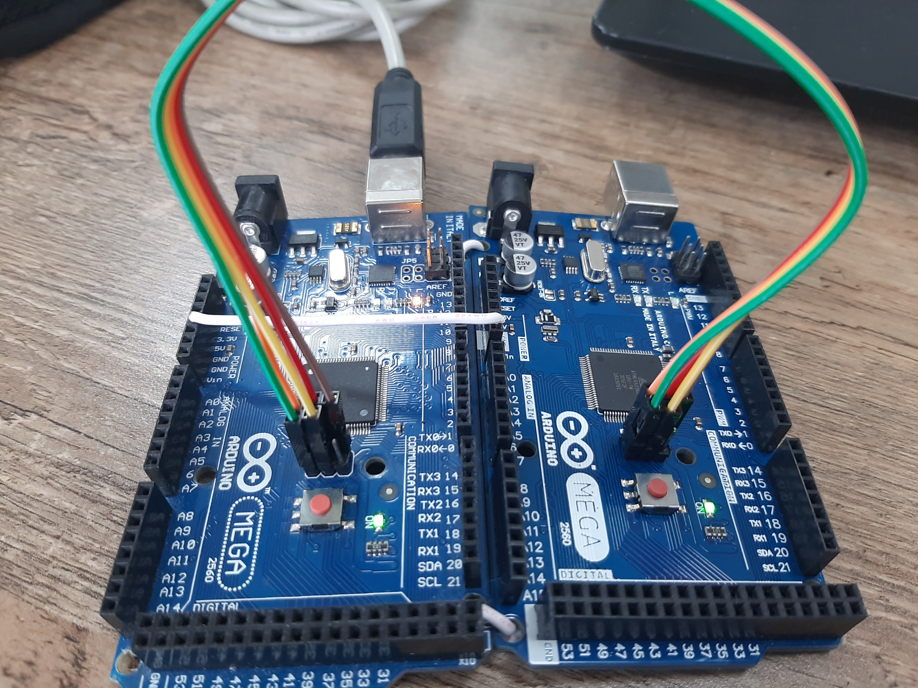
Material Oxidation Machine/assets/photo/20221019_152213.jpg
