RuisoArt/PROJECT_MaterialOxidationMachine/Material Oxidation Machine/assets/photo/20221103_175503.jpg

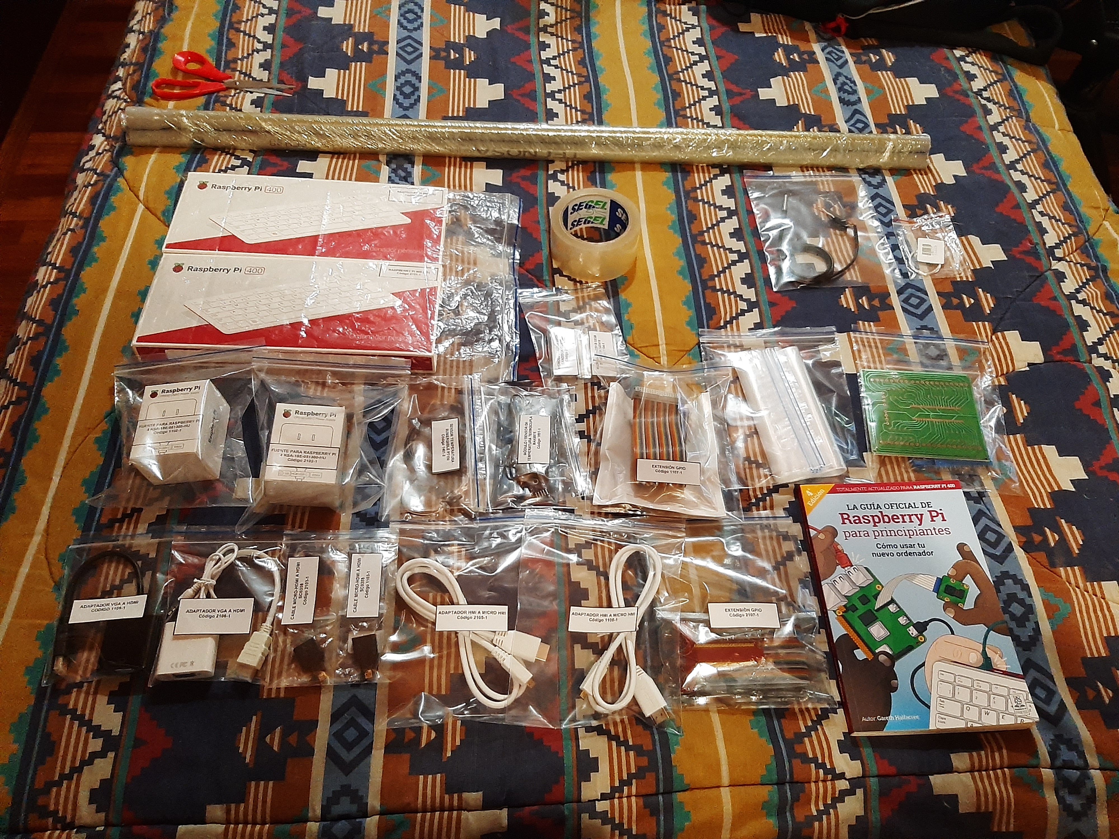
Material Oxidation Machine/assets/photo/20221103_175503.jpg
