RuisoArt/PROJECT_MaterialOxidationMachine/Material Oxidation Machine/assets/photo/20221104_160742.jpg

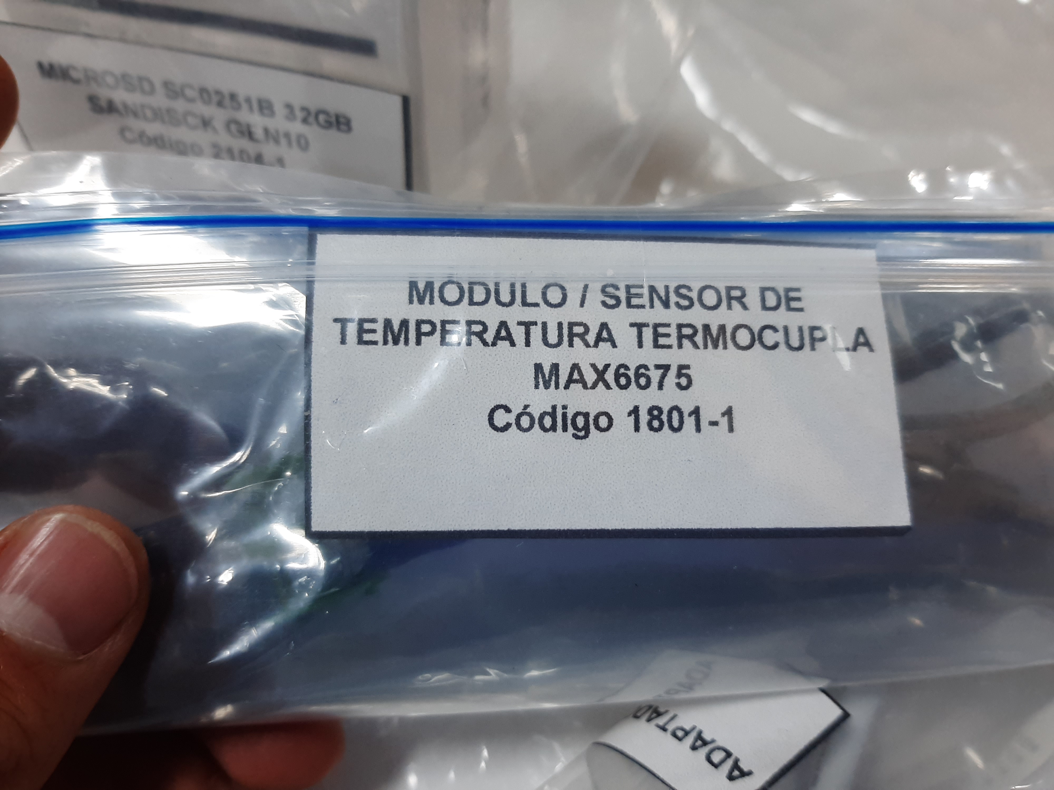
Material Oxidation Machine/assets/photo/20221104_160742.jpg
