RuisoArt/PROJECT_MaterialOxidationMachine/Material Oxidation Machine/assets/photo/20221104_160749.jpg

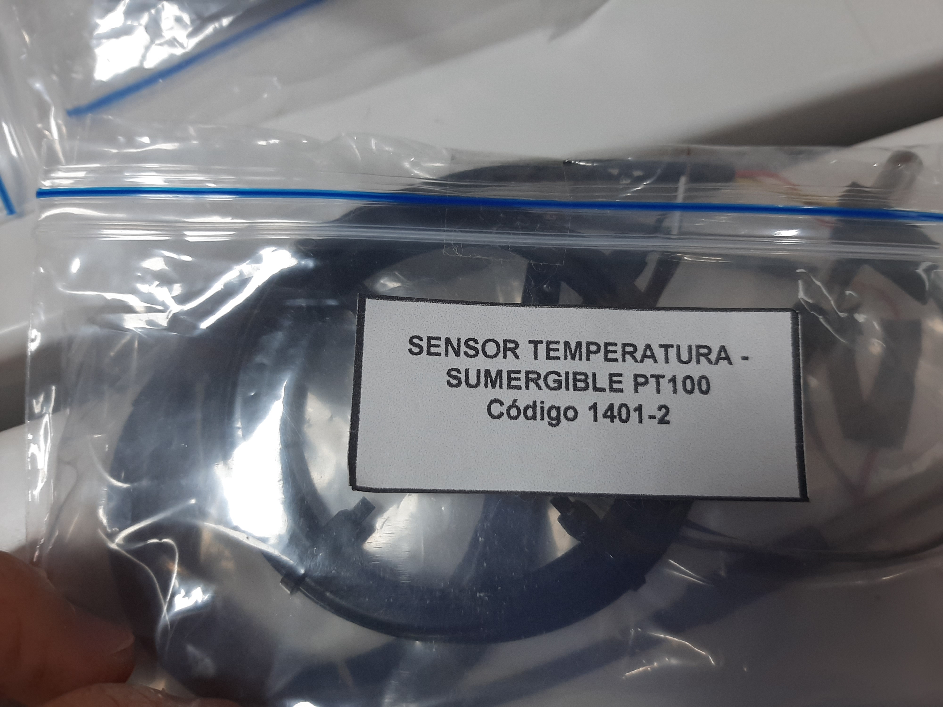
Material Oxidation Machine/assets/photo/20221104_160749.jpg
