RuisoArt/PROJECT_MaterialOxidationMachine/Material Oxidation Machine/assets/photo/20221111_144105.jpg

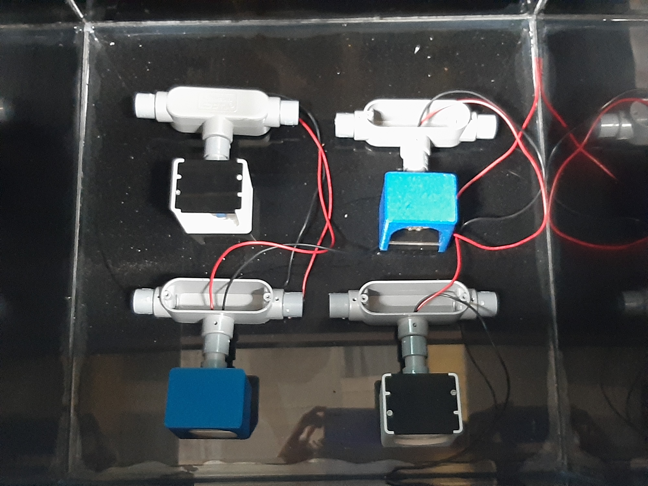
Material Oxidation Machine/assets/photo/20221111_144105.jpg
