RuisoArt/PROJECT_MaterialOxidationMachine/Material Oxidation Machine/assets/photo/20221111_144152.jpg

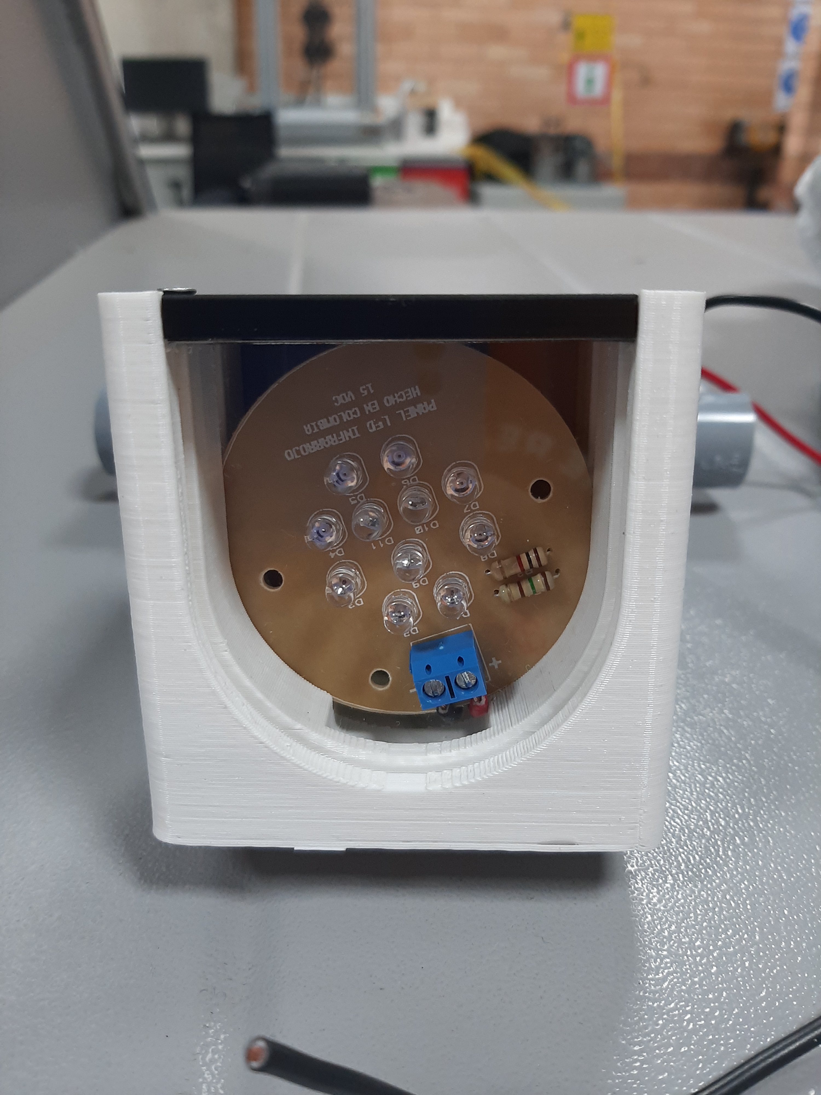
Material Oxidation Machine/assets/photo/20221111_144152.jpg
