RuisoArt/PROJECT_MaterialOxidationMachine/Material Oxidation Machine/assets/photo/20221111_144200.jpg

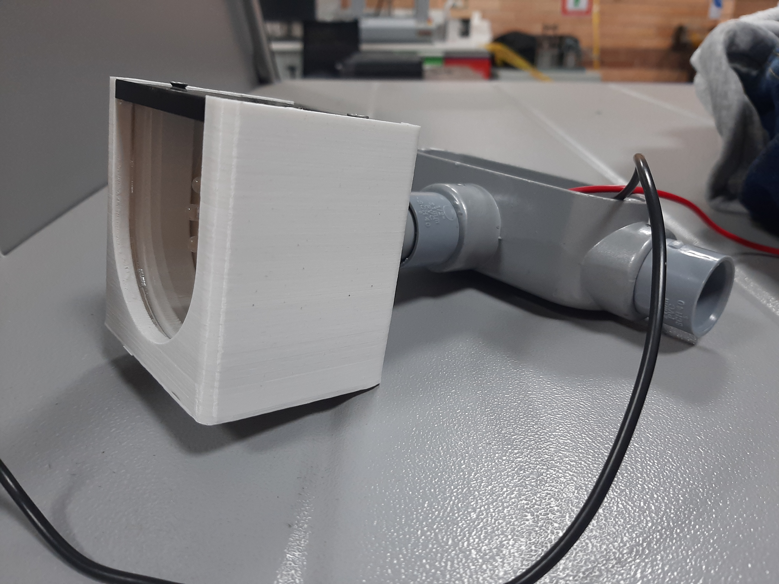
Material Oxidation Machine/assets/photo/20221111_144200.jpg
