RuisoArt/PROJECT_MaterialOxidationMachine/Material Oxidation Machine/assets/photo/20221111_144220.jpg

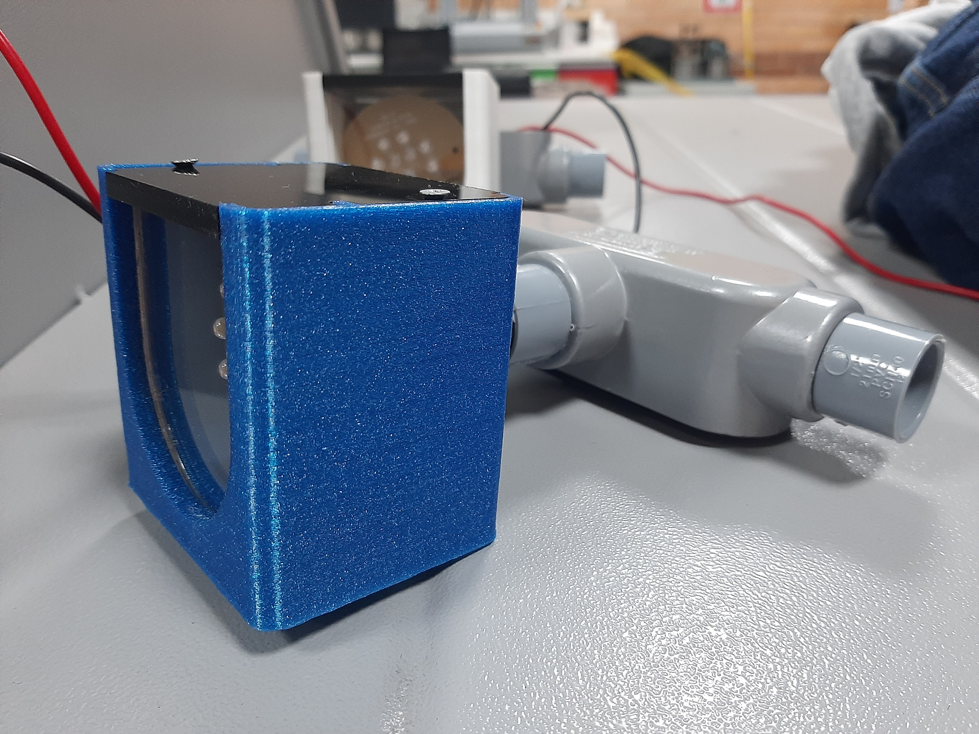
Material Oxidation Machine/assets/photo/20221111_144220.jpg
