RuisoArt/PROJECT_MaterialOxidationMachine/Material Oxidation Machine/assets/photo/20221111_150335.jpg

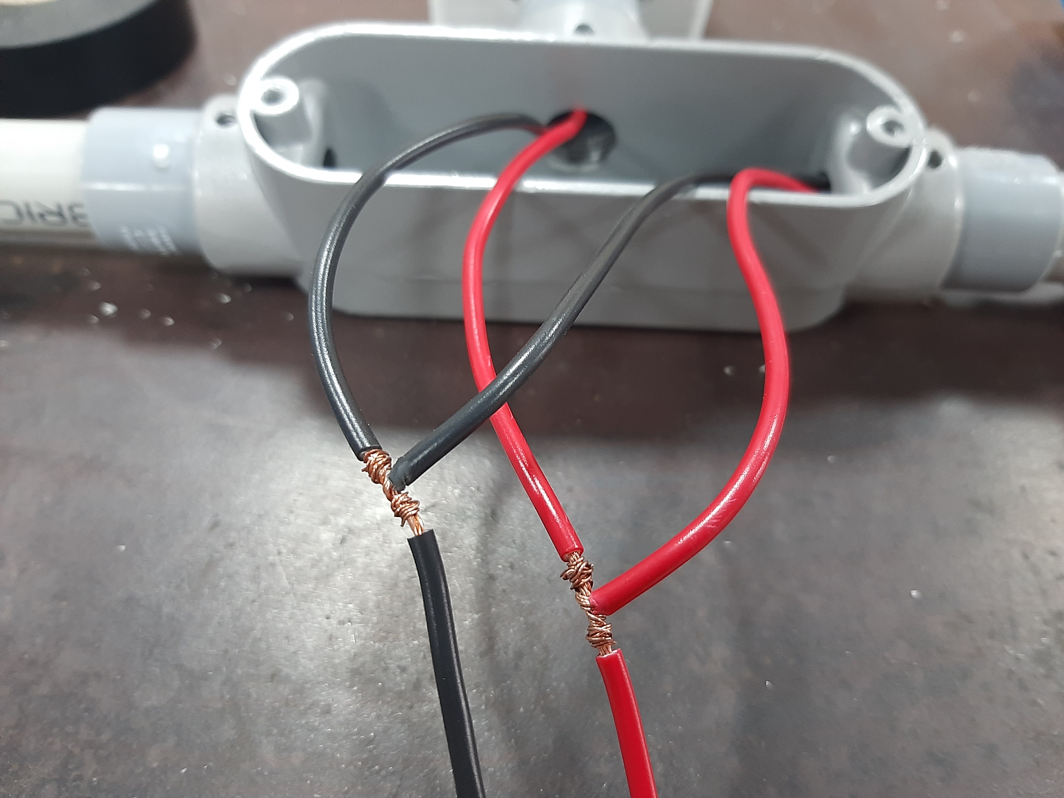
Material Oxidation Machine/assets/photo/20221111_150335.jpg
