RuisoArt/PROJECT_MaterialOxidationMachine/Material Oxidation Machine/assets/photo/20221111_151517.jpg

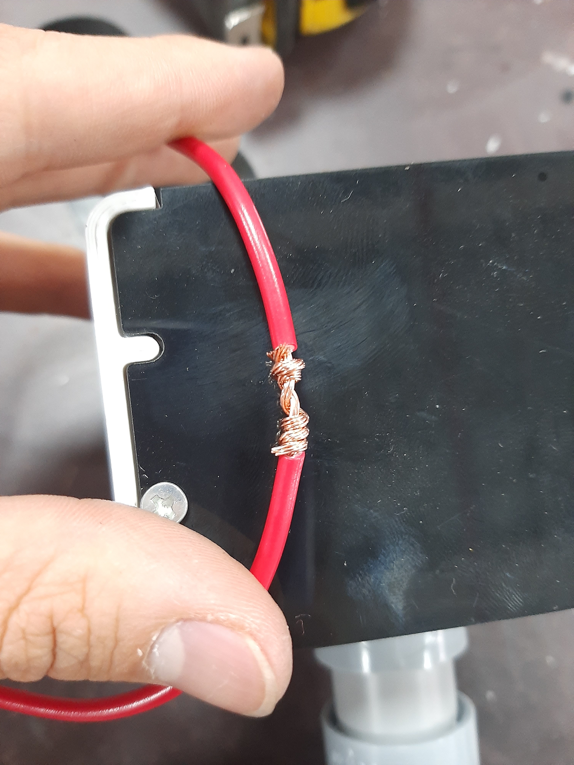
Material Oxidation Machine/assets/photo/20221111_151517.jpg
