RuisoArt/PROJECT_MaterialOxidationMachine/Material Oxidation Machine/assets/photo/20221111_151636.jpg

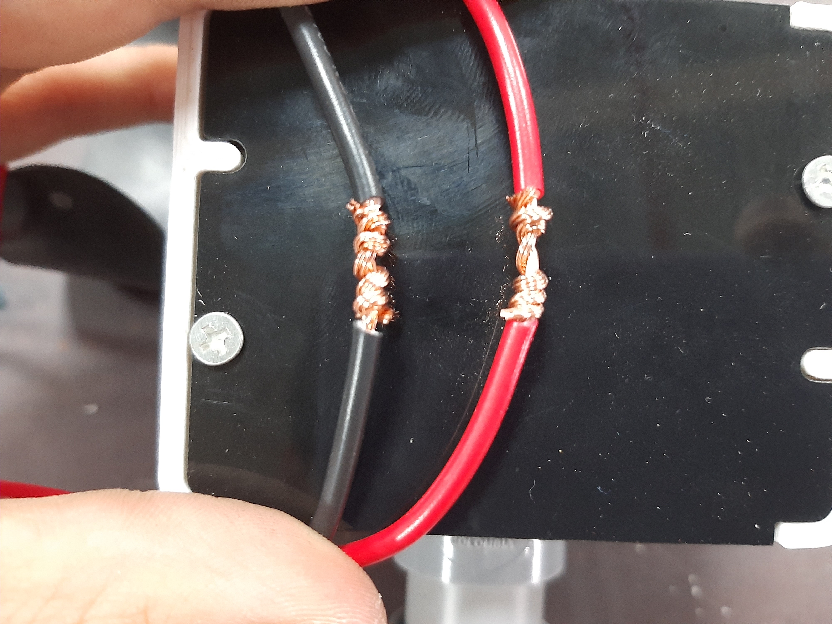
Material Oxidation Machine/assets/photo/20221111_151636.jpg
