RuisoArt/PROJECT_MaterialOxidationMachine/Material Oxidation Machine/assets/photo/20221111_154536.jpg

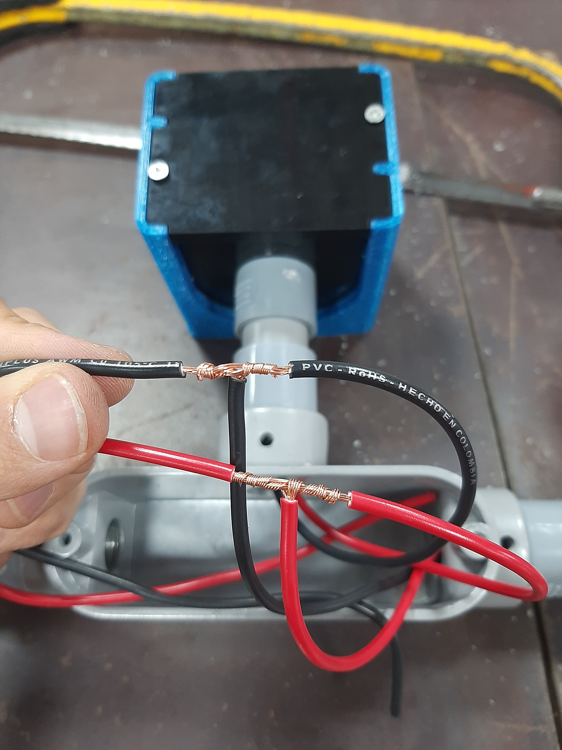
Material Oxidation Machine/assets/photo/20221111_154536.jpg
