RuisoArt/PROJECT_MaterialOxidationMachine/Material Oxidation Machine/assets/photo/20221111_155512.jpg

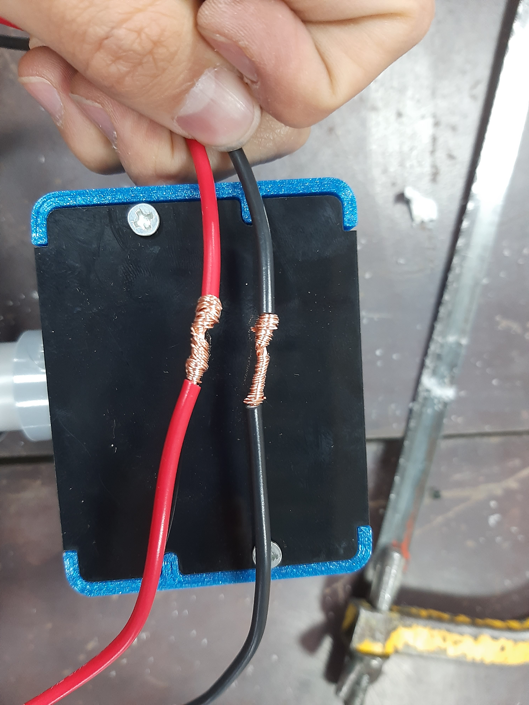
Material Oxidation Machine/assets/photo/20221111_155512.jpg
