RuisoArt/PROJECT_MaterialOxidationMachine/Material Oxidation Machine/assets/photo/20221111_161411.jpg

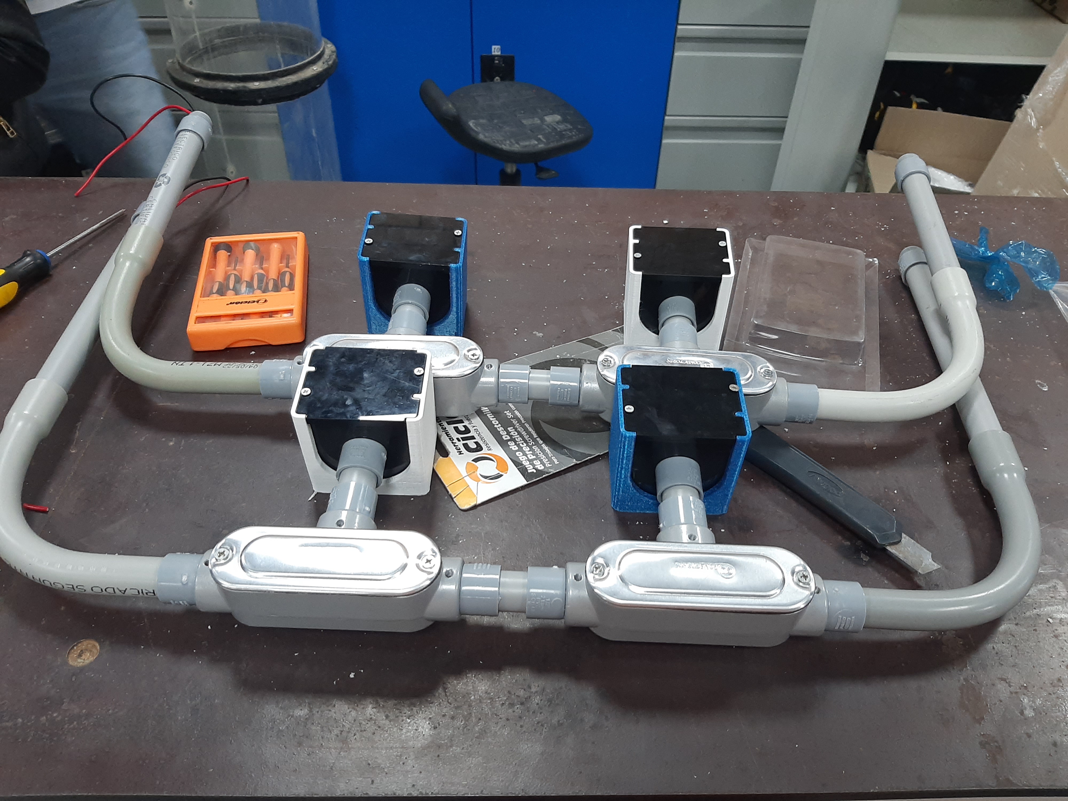
Material Oxidation Machine/assets/photo/20221111_161411.jpg
