RuisoArt/PROJECT_MaterialOxidationMachine/Material Oxidation Machine/assets/photo/20221111_164541.jpg

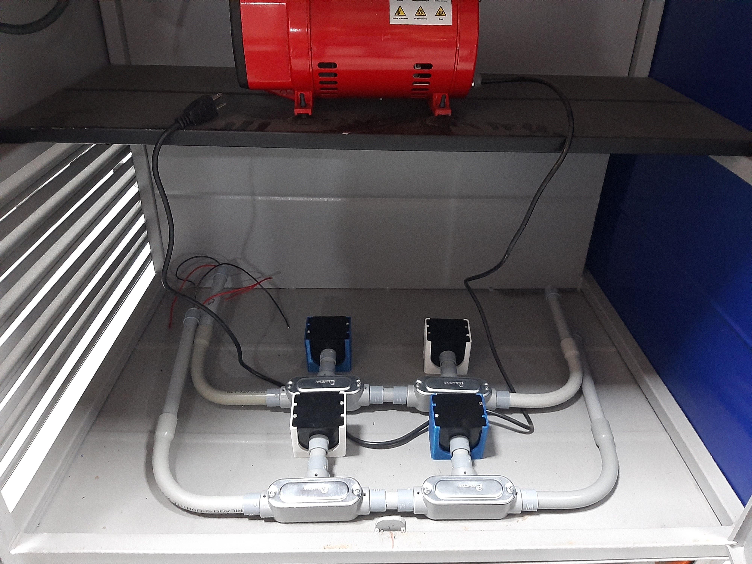
Material Oxidation Machine/assets/photo/20221111_164541.jpg
