RuisoArt/PROJECT_MaterialOxidationMachine/Material Oxidation Machine/assets/photo/20221118_145314.jpg

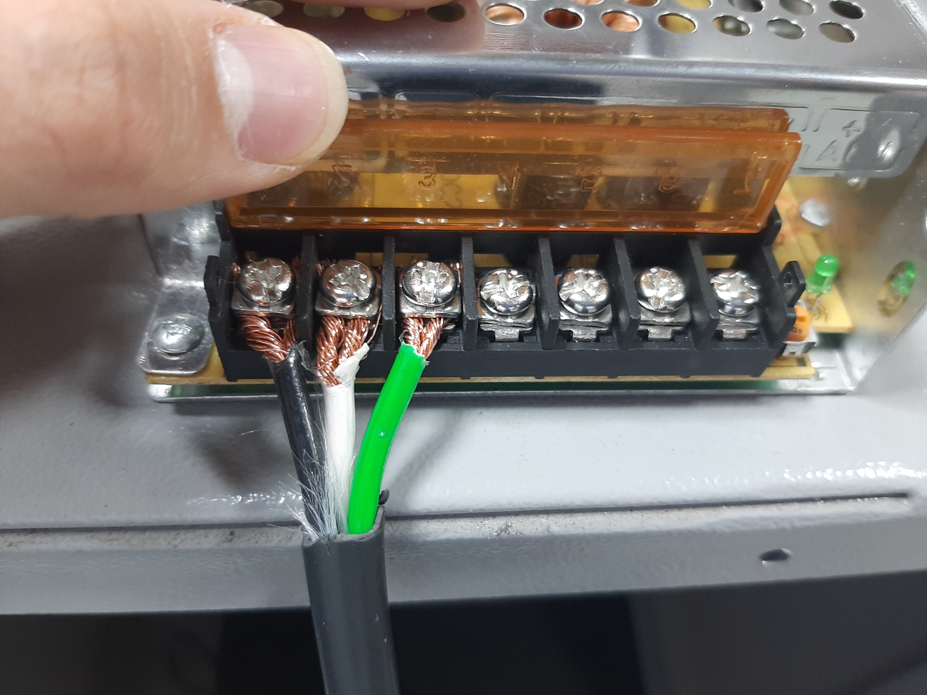
Material Oxidation Machine/assets/photo/20221118_145314.jpg
