RuisoArt/PROJECT_MaterialOxidationMachine/Material Oxidation Machine/assets/photo/20221118_160457.jpg

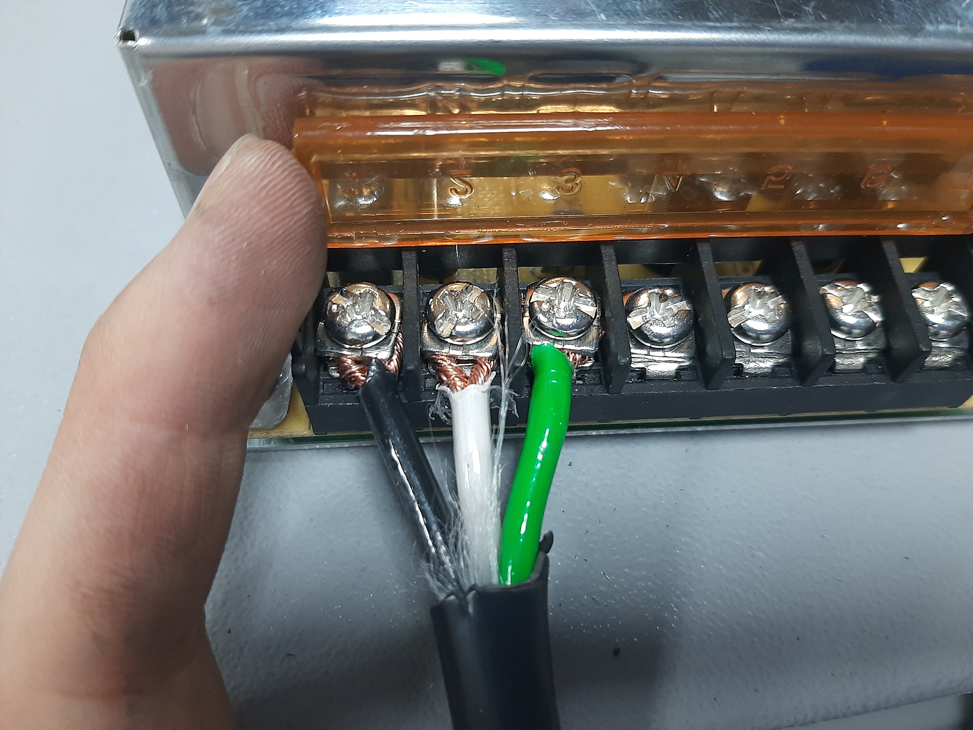
Material Oxidation Machine/assets/photo/20221118_160457.jpg
