RuisoArt/PROJECT_MaterialOxidationMachine/Material Oxidation Machine/assets/photo/20221118_171306.jpg

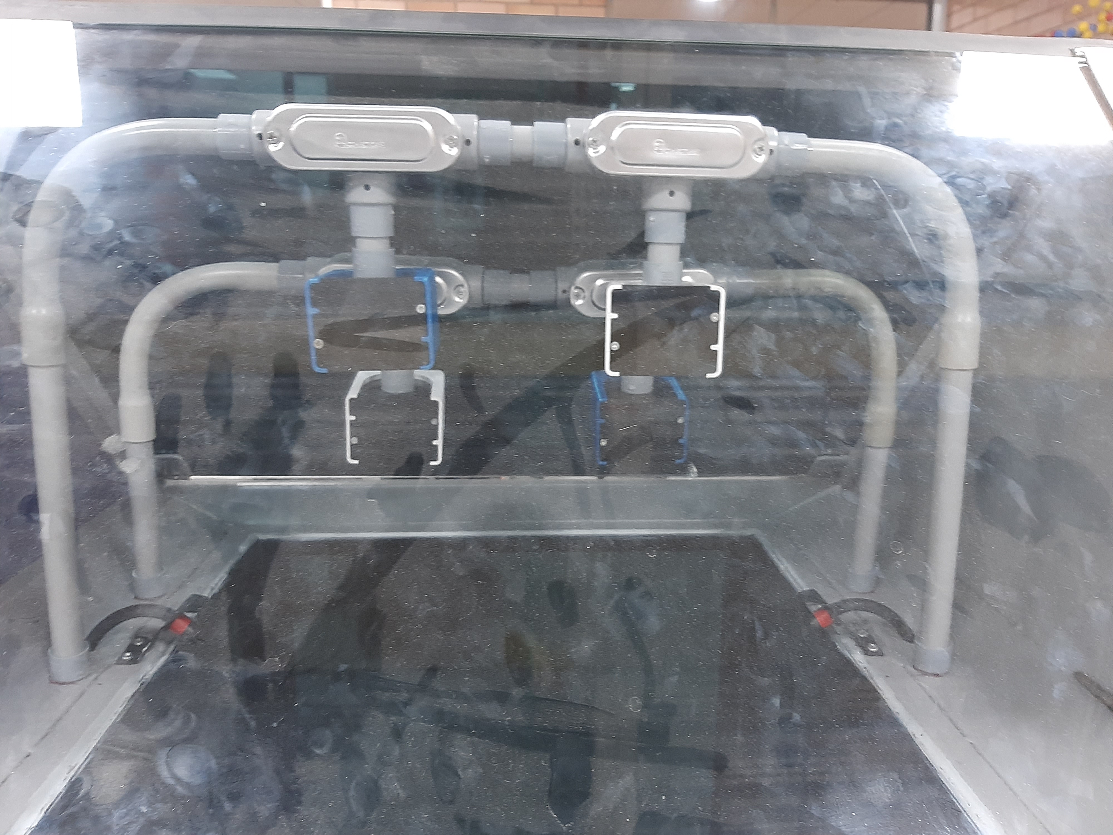
Material Oxidation Machine/assets/photo/20221118_171306.jpg
