RuisoArt/PROJECT_MaterialOxidationMachine/Material Oxidation Machine/assets/photo/20221118_171314.jpg

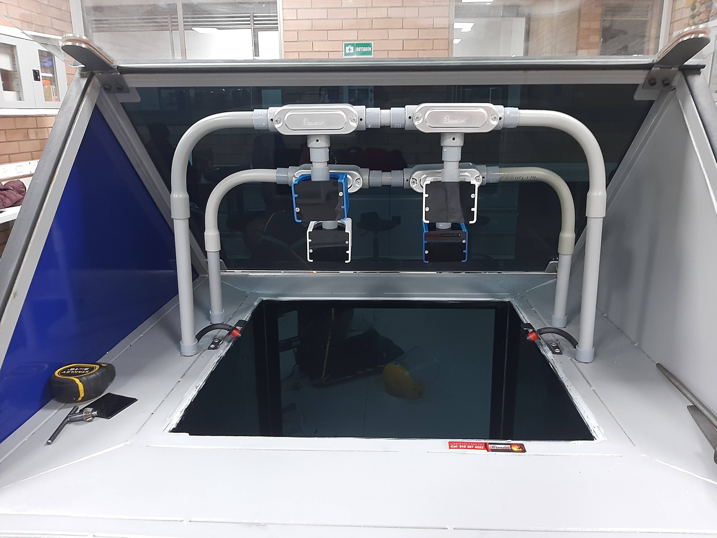
Material Oxidation Machine/assets/photo/20221118_171314.jpg
