RuisoArt/PROJECT_MaterialOxidationMachine/Material Oxidation Machine/assets/photo/20221118_174749.jpg

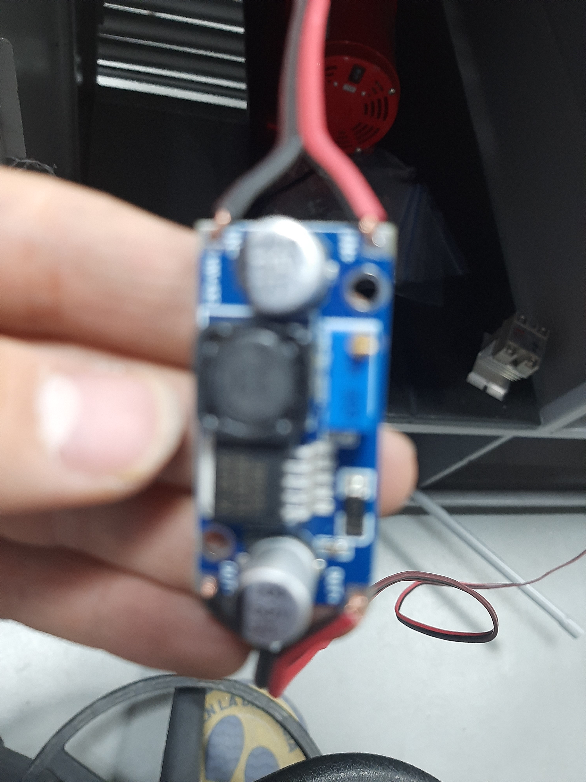
Material Oxidation Machine/assets/photo/20221118_174749.jpg
