RuisoArt/PROJECT_MaterialOxidationMachine/Material Oxidation Machine/assets/photo/20221118_174911.jpg

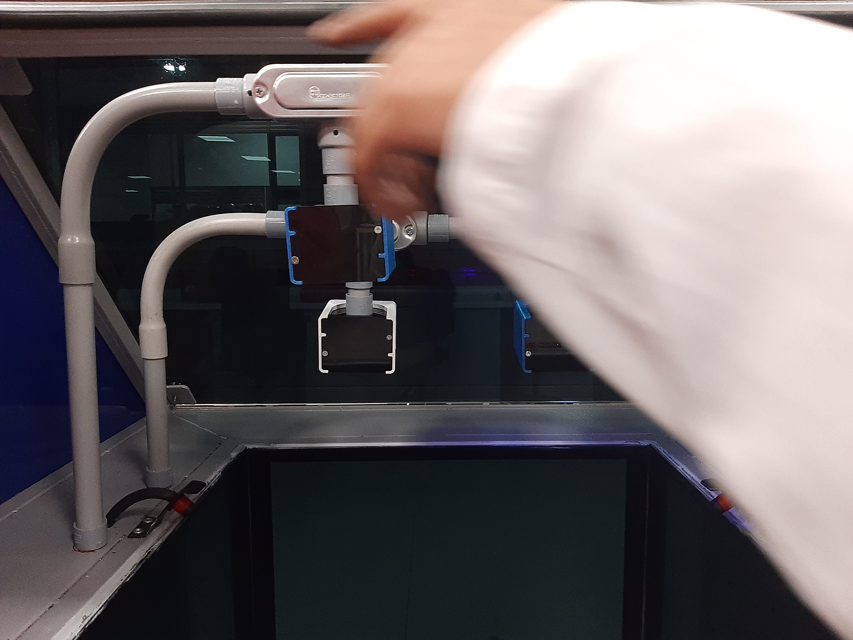
Material Oxidation Machine/assets/photo/20221118_174911.jpg
