RuisoArt/PROJECT_MaterialOxidationMachine/Material Oxidation Machine/assets/photo/20221124_150539.jpg

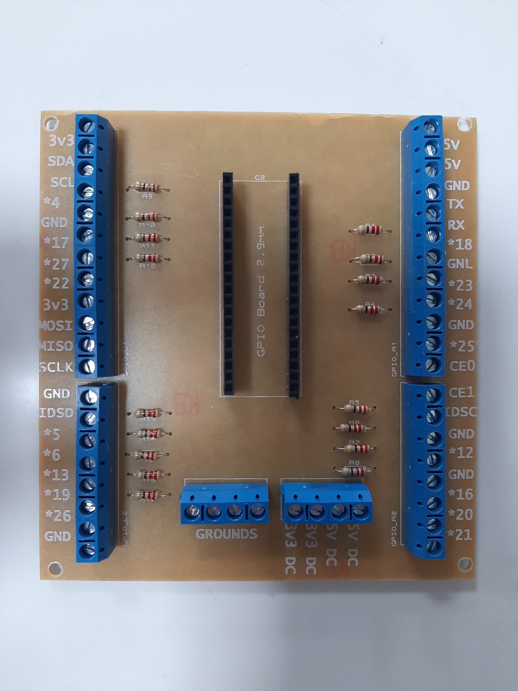
Material Oxidation Machine/assets/photo/20221124_150539.jpg
