RuisoArt/PROJECT_MaterialOxidationMachine/Material Oxidation Machine/assets/photo/20221124_150547.jpg

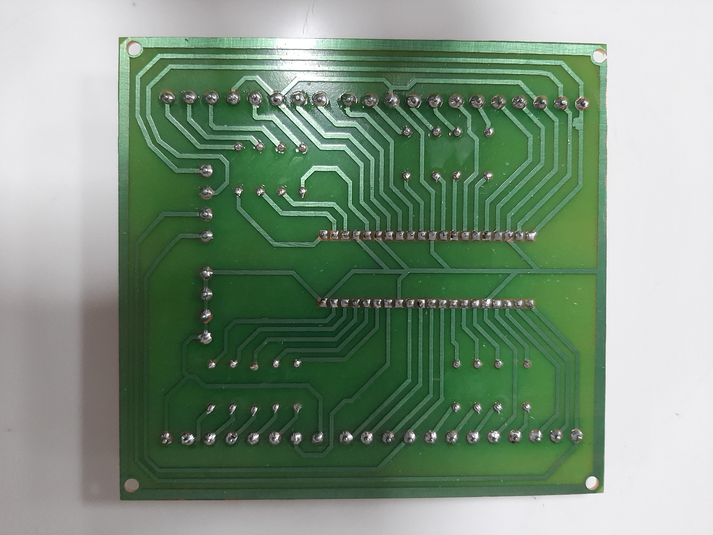
Material Oxidation Machine/assets/photo/20221124_150547.jpg
