RuisoArt/PROJECT_MaterialOxidationMachine/Material Oxidation Machine/assets/photo/20221124_160546.jpg

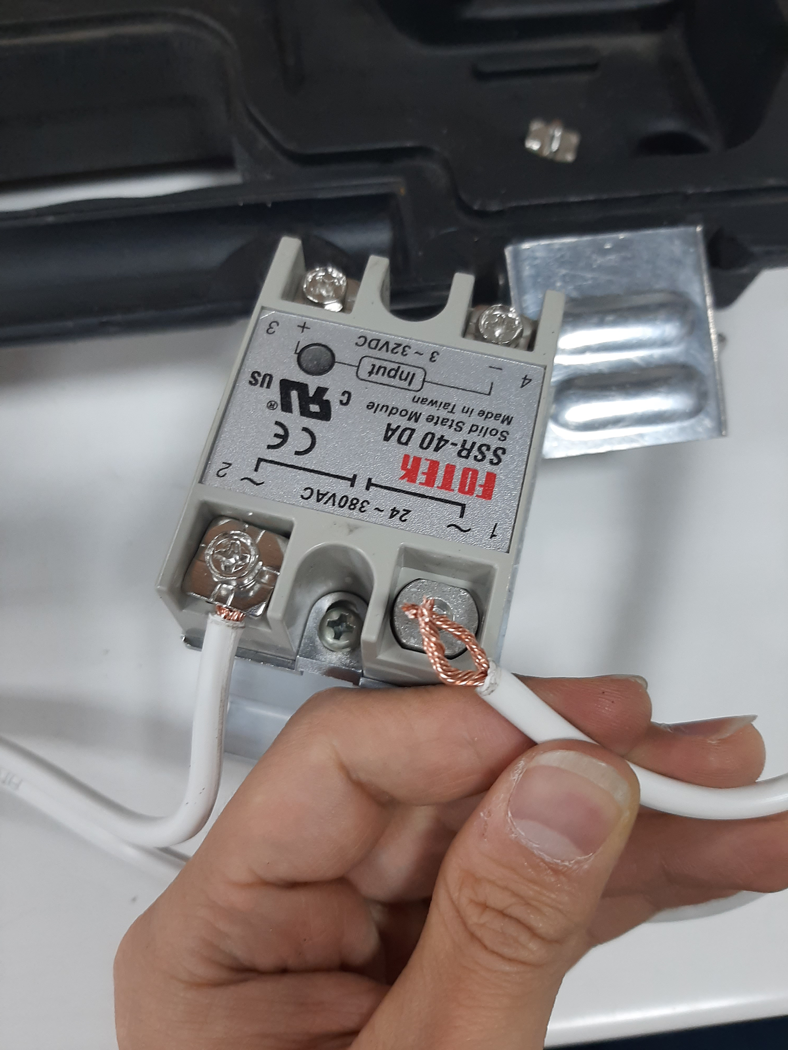
Material Oxidation Machine/assets/photo/20221124_160546.jpg
