RuisoArt/PROJECT_MaterialOxidationMachine/Material Oxidation Machine/assets/photo/20221124_161900.jpg

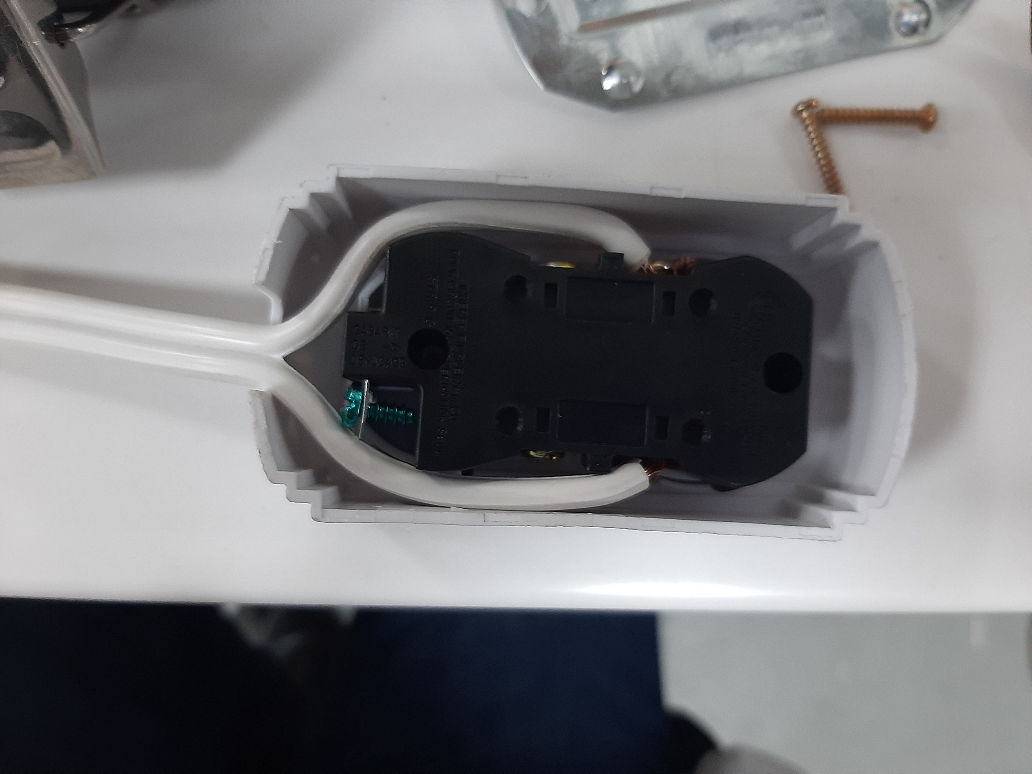
Material Oxidation Machine/assets/photo/20221124_161900.jpg
