RuisoArt/PROJECT_MaterialOxidationMachine/Material Oxidation Machine/assets/photo/20221124_162033.jpg

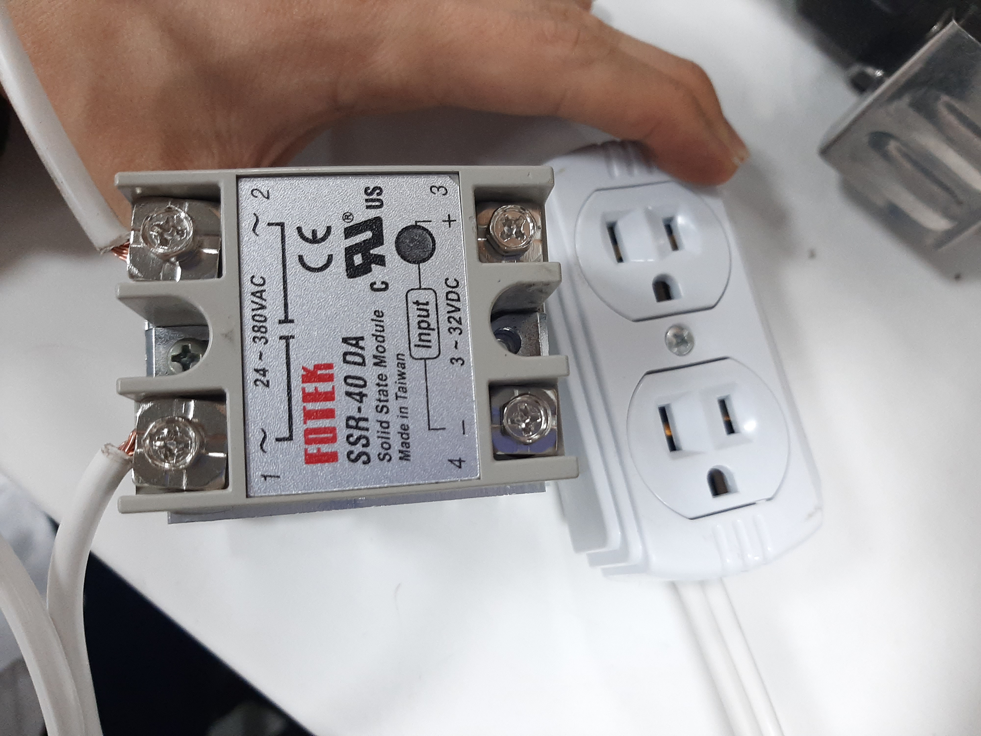
Material Oxidation Machine/assets/photo/20221124_162033.jpg
