RuisoArt/PROJECT_MaterialOxidationMachine/Material Oxidation Machine/assets/photo/20221124_163259.jpg

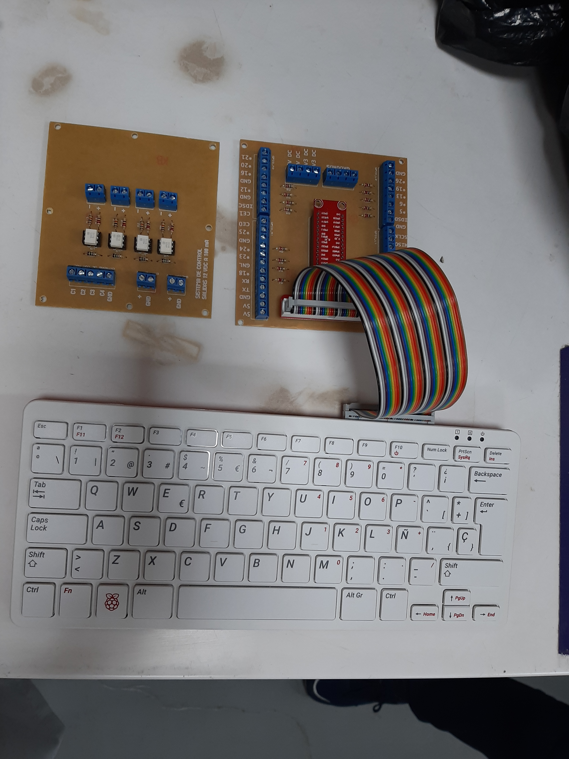
Material Oxidation Machine/assets/photo/20221124_163259.jpg
