RuisoArt/PROJECT_MaterialOxidationMachine/Material Oxidation Machine/assets/photo/20221125_145159.jpg

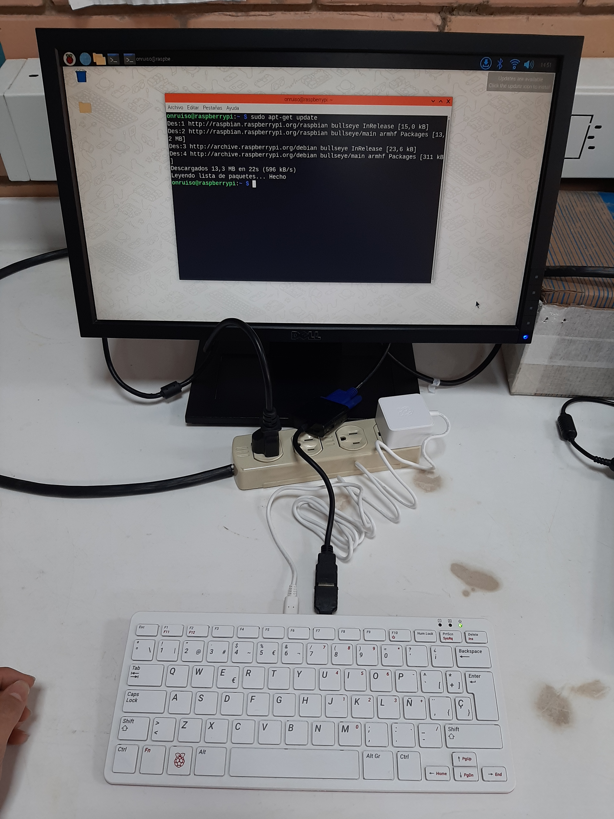
Material Oxidation Machine/assets/photo/20221125_145159.jpg
