RuisoArt/PROJECT_MaterialOxidationMachine/Material Oxidation Machine/assets/photo/20221125_175524.jpg

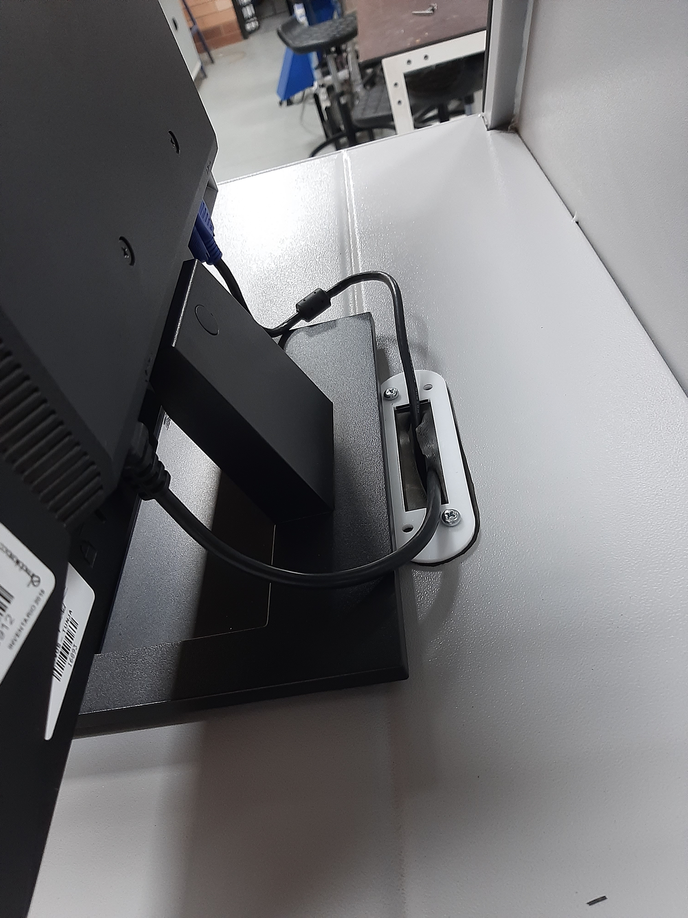
Material Oxidation Machine/assets/photo/20221125_175524.jpg
