RuisoArt/PROJECT_MaterialOxidationMachine/Material Oxidation Machine/assets/photo/Imagen de WhatsApp 2023-09-11 a las 10.40.21.jpg

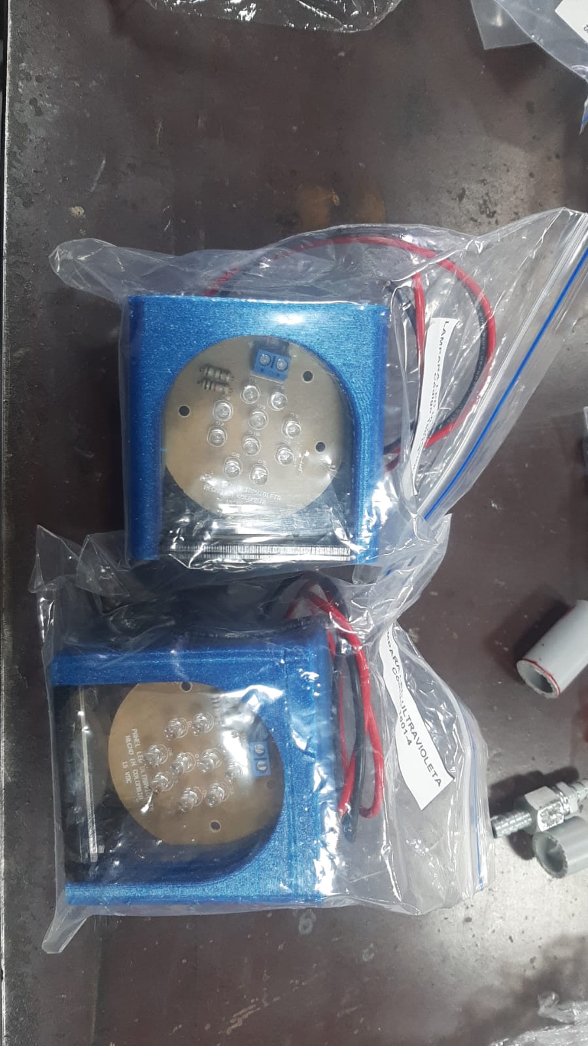
Material Oxidation Machine/assets/photo/Imagen de WhatsApp 2023-09-11 a las 10.40.21.jpg
