RuisoArt/PROJECT_MaterialOxidationMachine/Material Oxidation Machine/assets/photo/Imagen de WhatsApp 2024-06-09 a las 17.02.34_b26975b6.jpg

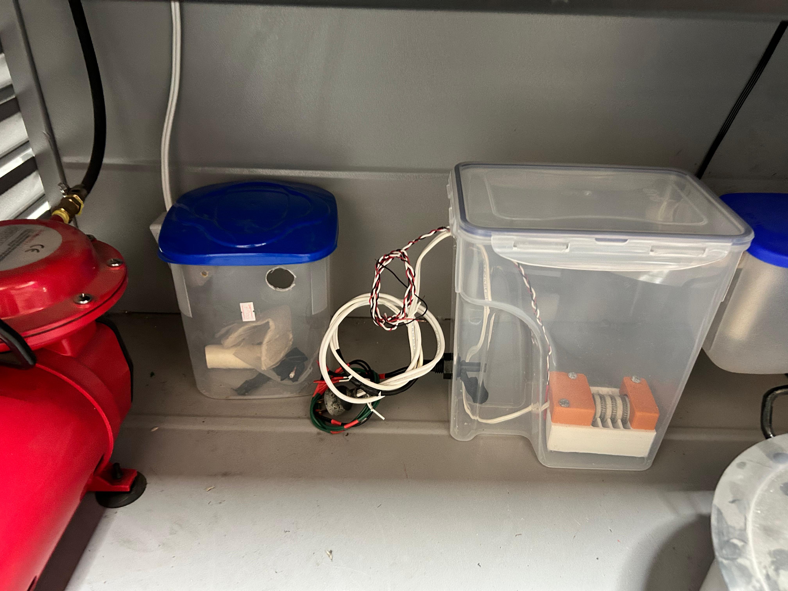
Material Oxidation Machine/assets/photo/Imagen de WhatsApp 2024-06-09 a las 17.02.34_b26975b6.jpg
