RuisoArt/PROJECT_MaterialOxidationMachine/Material Oxidation Machine/assets/photo/WhatsApp Image 2023-07-24 at 15.56.36 (1).jpeg

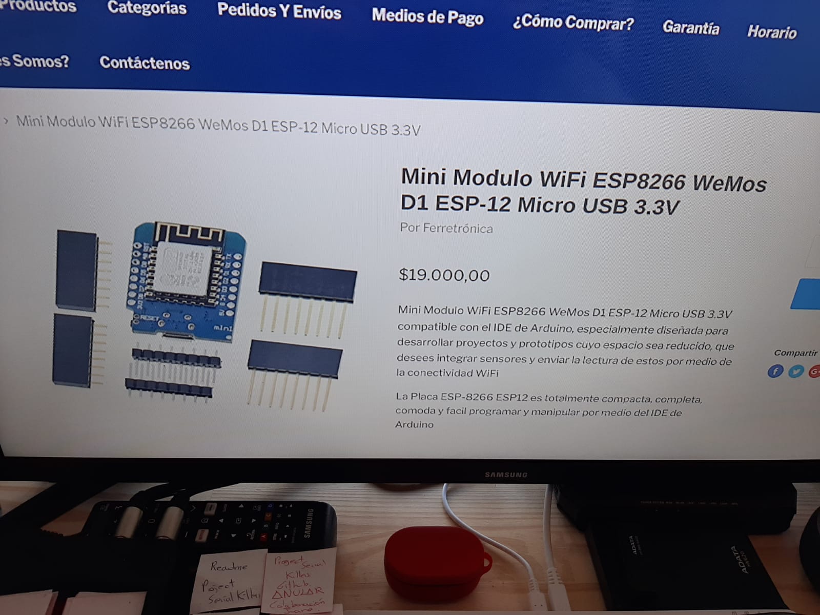
Material Oxidation Machine/assets/photo/WhatsApp Image 2023-07-24 at 15.56.36 (1).jpeg
