RuisoArt/PROJECT_MaterialOxidationMachine/Material Oxidation Machine/assets/photo/WhatsApp Image 2023-07-25 at 22.32.18.jpeg

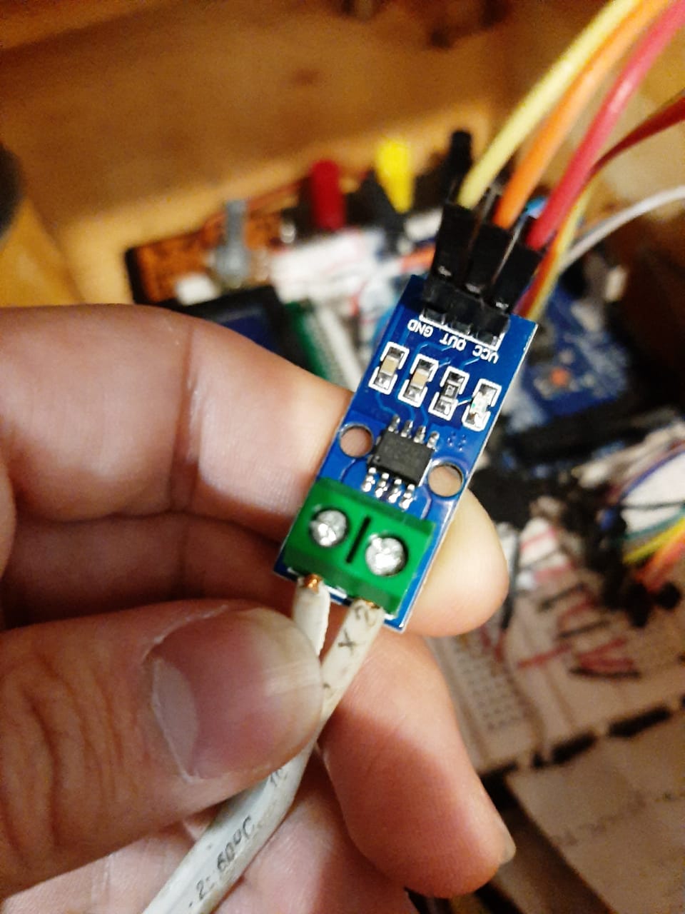
Material Oxidation Machine/assets/photo/WhatsApp Image 2023-07-25 at 22.32.18.jpeg
