RuisoArt/PROJECT_MaterialOxidationMachine/Material Oxidation Machine/assets/photo/WhatsApp Image 2023-07-26 at 20.01.16.jpeg

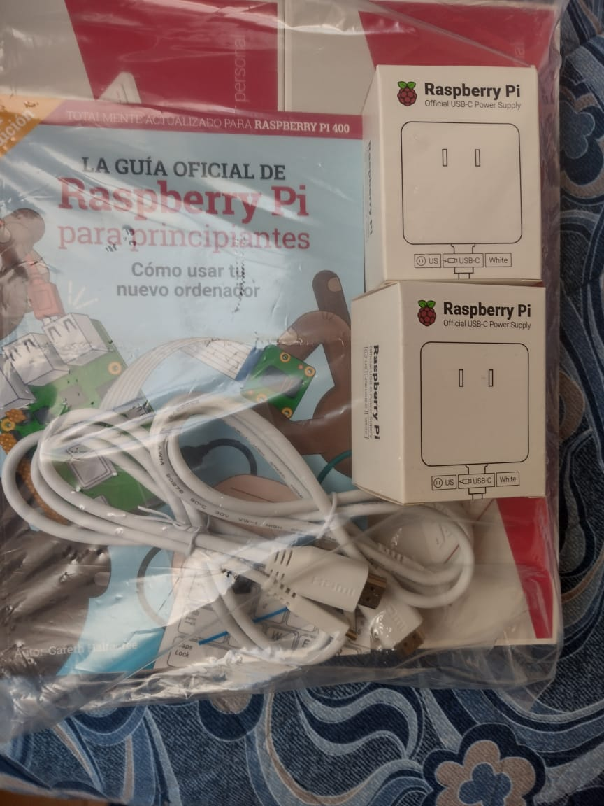
Material Oxidation Machine/assets/photo/WhatsApp Image 2023-07-26 at 20.01.16.jpeg
