RuisoArt/PROJECT_MaterialOxidationMachine/Material Oxidation Machine/assets/photo/WhatsApp Image 2023-07-26 at 20.02.54.jpeg

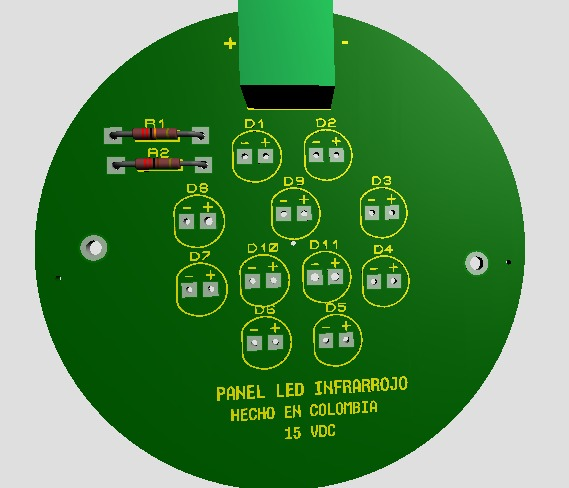
Material Oxidation Machine/assets/photo/WhatsApp Image 2023-07-26 at 20.02.54.jpeg
