RuisoArt/PROJECT_MaterialOxidationMachine/Material Oxidation Machine/assets/plans_img/Imagen de WhatsApp 2023-03-01 a las 15.04.18 8.jpg

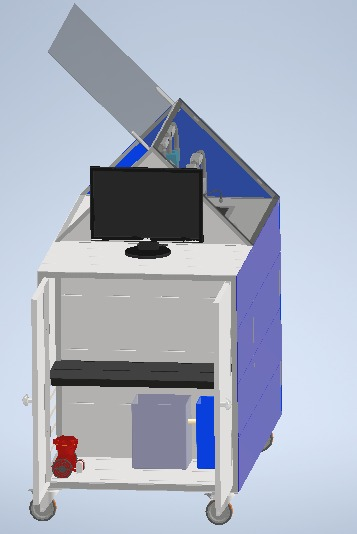
Material Oxidation Machine/assets/plans_img/Imagen de WhatsApp 2023-03-01 a las 15.04.18 8.jpg
