RuisoArt/PROJECT_MaterialOxidationMachine/Material Oxidation Machine/assets/screenshoot/2022-10-18-195106_1920x1080_scrot.png

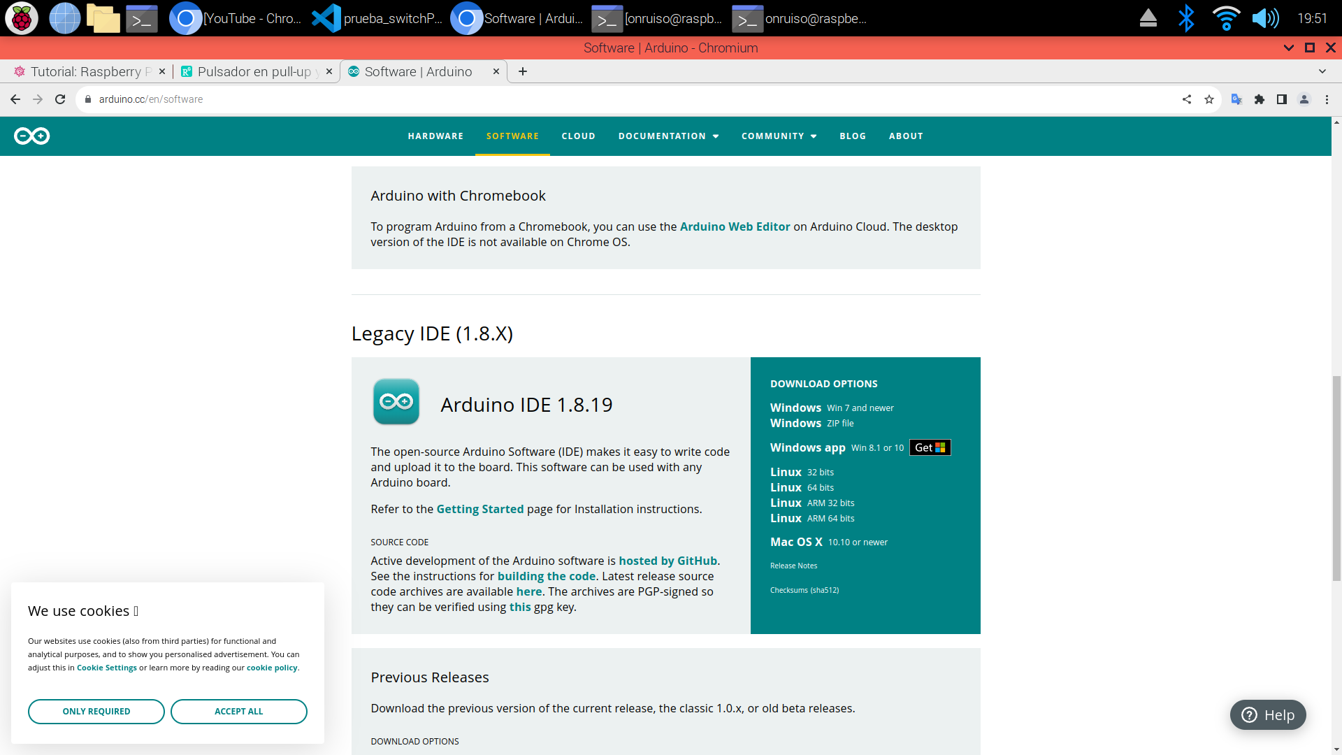
Material Oxidation Machine/assets/screenshoot/2022-10-18-195106_1920x1080_scrot.png
