RuisoArt/PROJECT_MaterialOxidationMachine/Material Oxidation Machine/assets/screenshoot/2022-11-25-151216_1920x1080_scrot.png

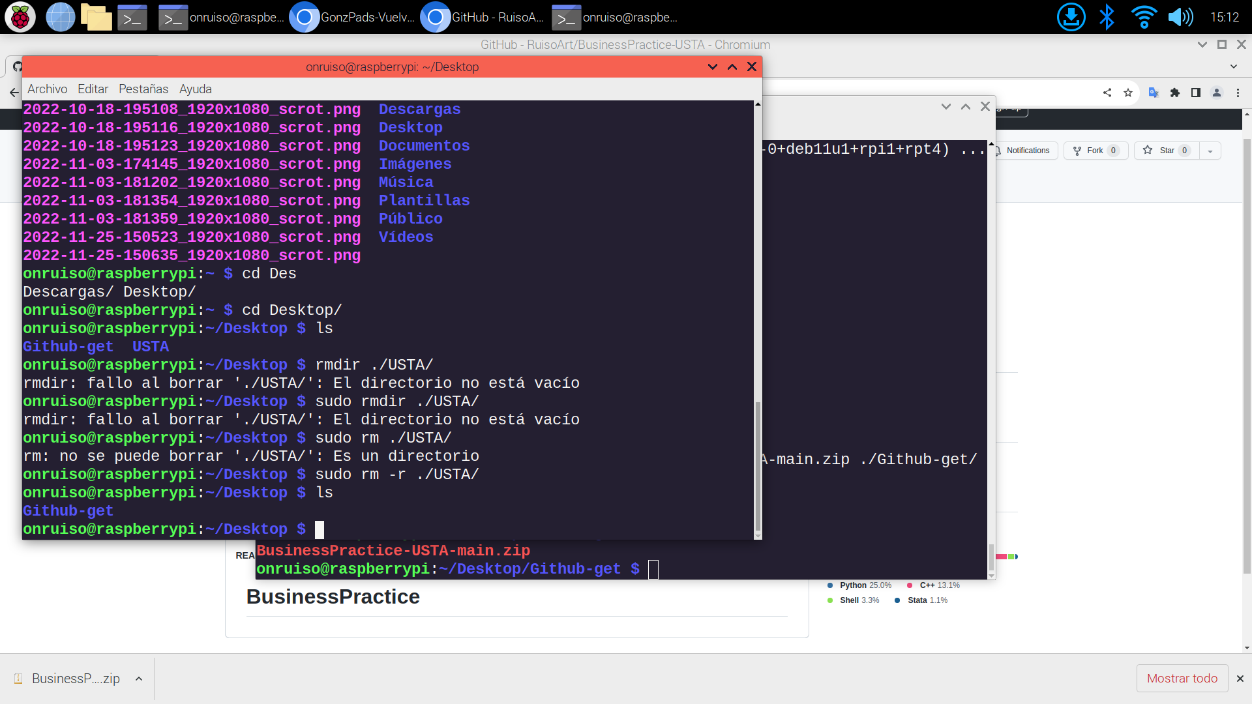
Material Oxidation Machine/assets/screenshoot/2022-11-25-151216_1920x1080_scrot.png
