RuisoArt/PROJECT_MaterialOxidationMachine/Material Oxidation Machine/assets/screenshoot/2022-12-15-145422_1920x1080_scrot.png

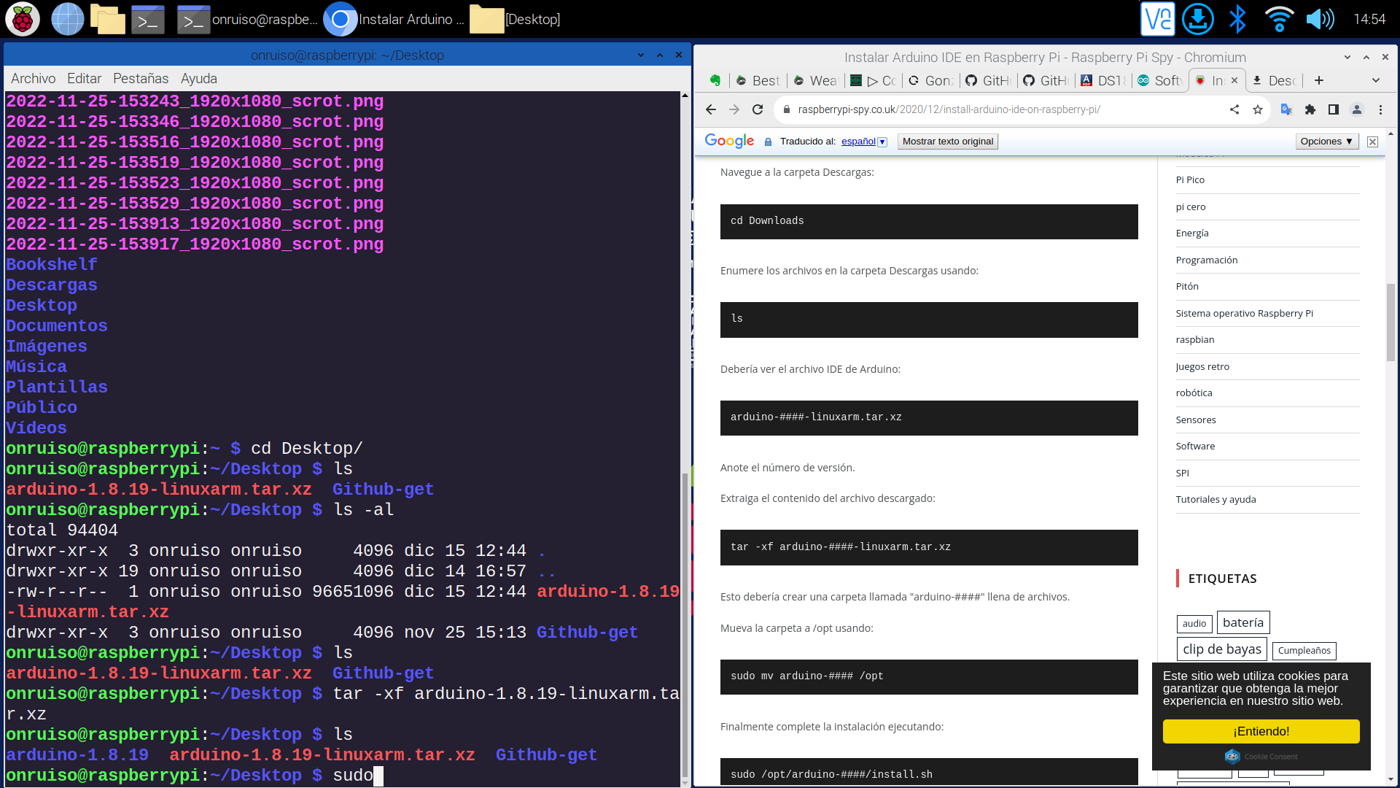
Material Oxidation Machine/assets/screenshoot/2022-12-15-145422_1920x1080_scrot.png
