RuisoArt/PROJECT_MaterialOxidationMachine/Material Oxidation Machine/assets/screenshoot/WhatsApp Image 2024-04-04 at 15.33.37_6b7c1e1a.jpg

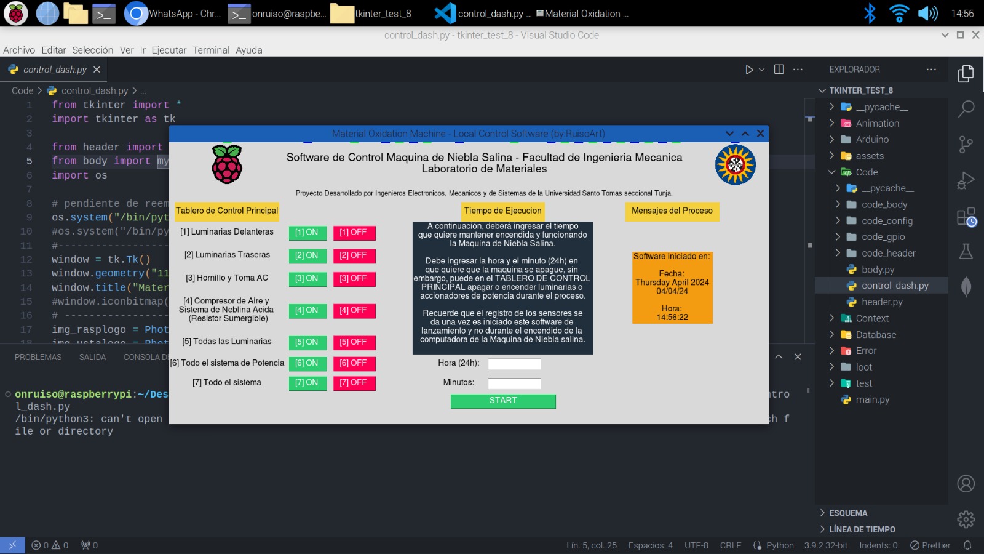
Material Oxidation Machine/assets/screenshoot/WhatsApp Image 2024-04-04 at 15.33.37_6b7c1e1a.jpg
