RuisoArt/PROJECT_MaterialOxidationMachine/Material Oxidation Machine/assets/screenshoot/WhatsApp Image 2024-04-04 at 15.33.37_7ff4c8ed.jpg

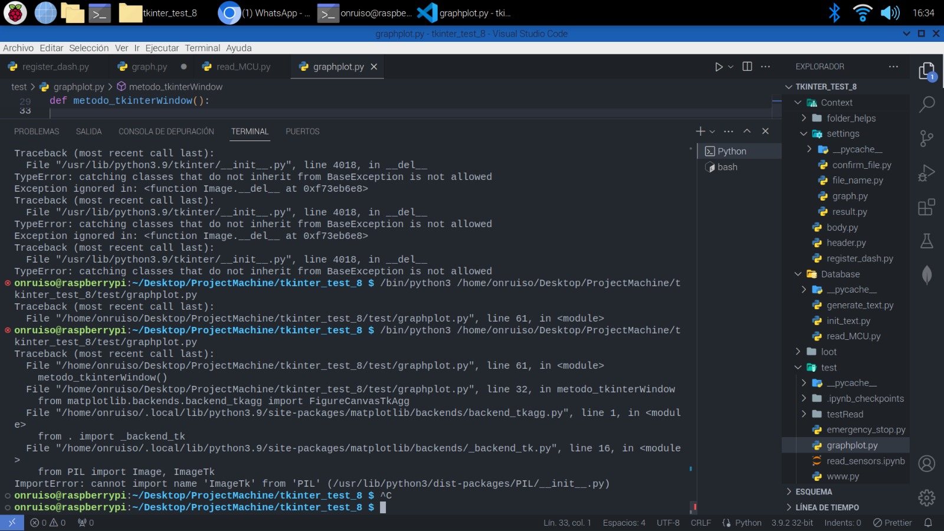
Material Oxidation Machine/assets/screenshoot/WhatsApp Image 2024-04-04 at 15.33.37_7ff4c8ed.jpg
