RuisoArt/PROJECT_MaterialOxidationMachine/Material Oxidation Machine/assets/screenshoot/WhatsApp Image 2024-04-04 at 15.33.38_9ffeb51c.jpg

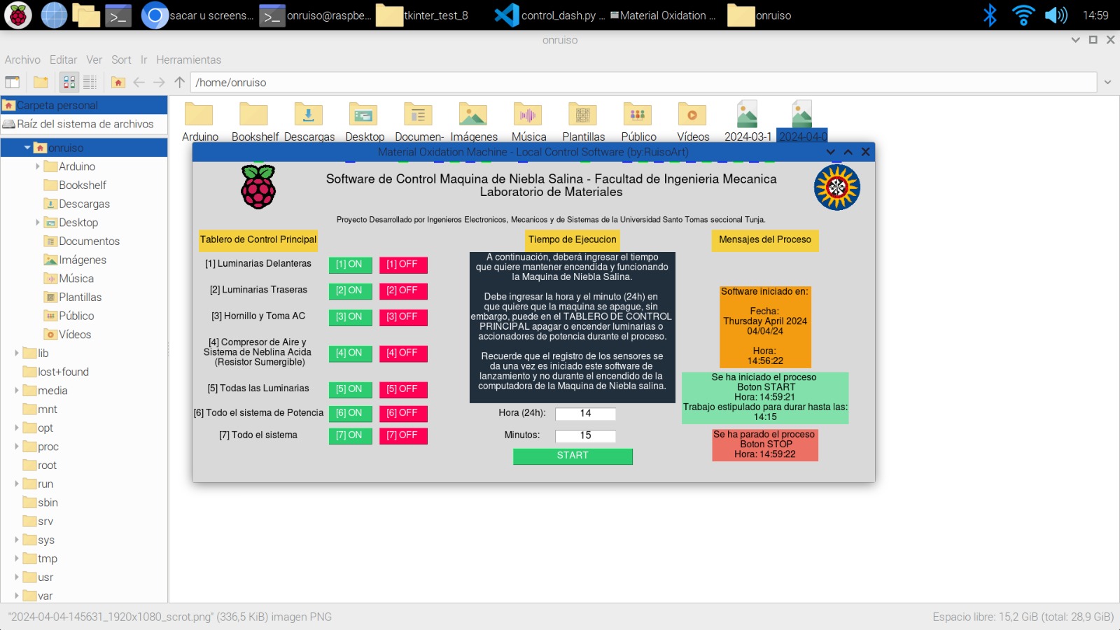
Material Oxidation Machine/assets/screenshoot/WhatsApp Image 2024-04-04 at 15.33.38_9ffeb51c.jpg
