RuisoArt/PROJECT_MaterialOxidationMachine/Material Oxidation Machine/assets/screenshoot/WhatsApp Image 2024-05-07 at 16.55.51(1).jpeg

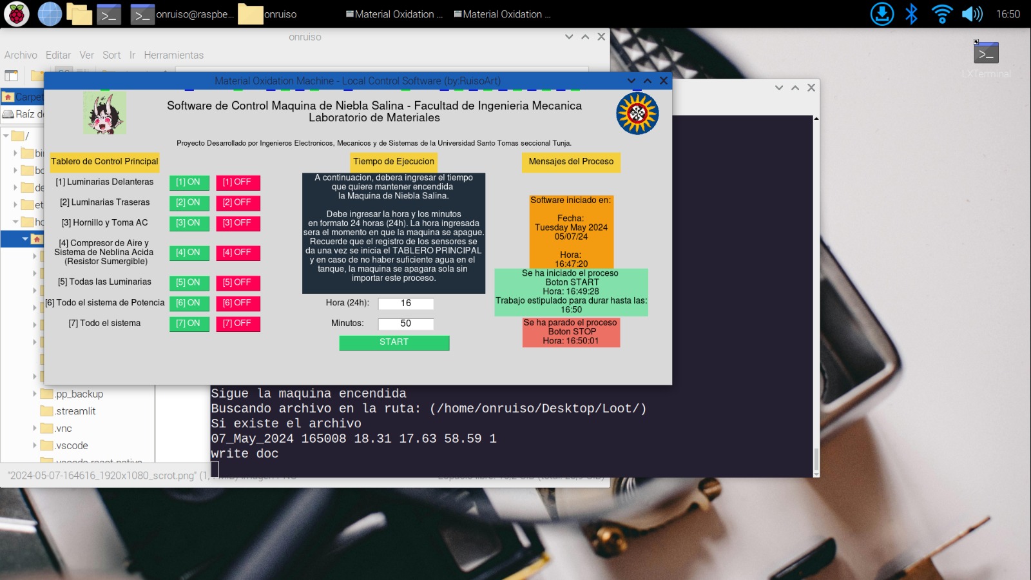
Material Oxidation Machine/assets/screenshoot/WhatsApp Image 2024-05-07 at 16.55.51(1).jpeg
