RuisoArt/PROJECT_MaterialOxidationMachine/Material Oxidation Machine/test/streamlit/streamlit_test_5/botin/1.csv

La fecha es: 1 La hora es: 1 Este es el registro numero: 9
La fecha es: 1 La hora es: 1 Este es el registro numero: 3
La fecha es: 1 La hora es: 1 Este es el registro numero: 3
La fecha es: 1 La hora es: 1 Este es el registro numero: 2
La fecha es: 1 La hora es: 1 Este es el registro numero: 2
