RuisoArt/PROJECT_MaterialOxidationMachine/Material Oxidation Machine/test/tkinter/tkinter_test_9/assets/img/COLOURRaspberryPI.jpeg

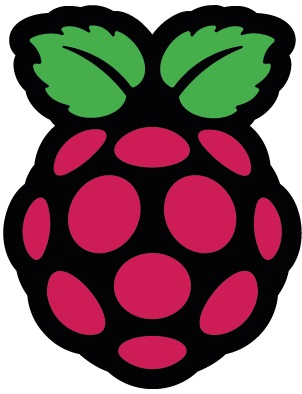
Material Oxidation Machine/test/tkinter/tkinter_test_9/assets/img/COLOURRaspberryPI.jpeg
