RuisoArt/PROJECT_MaterialOxidationMachine/Material Oxidation Machine/assets/diagram/the problem tree.jpg

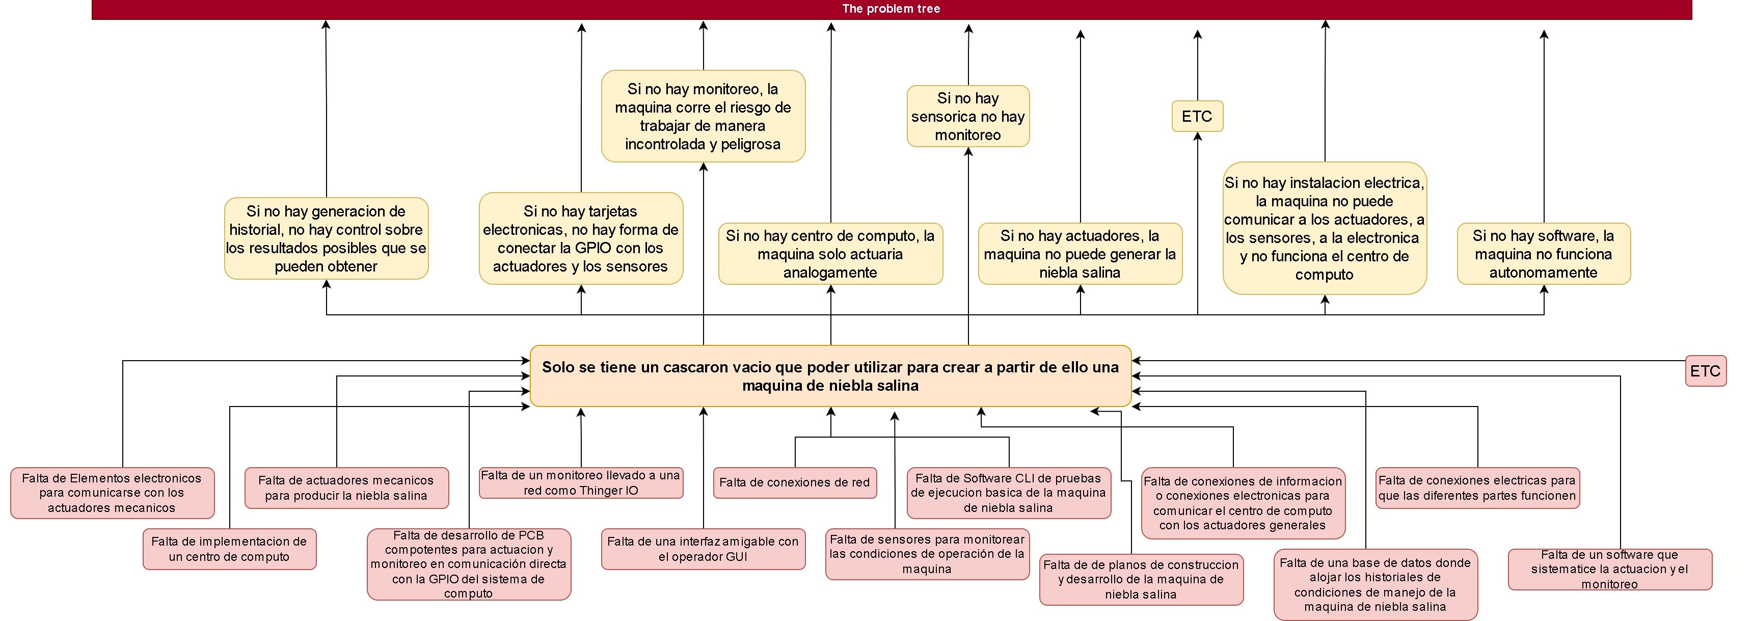
Material Oxidation Machine/assets/diagram/the problem tree.jpg
