RuisoArt/PROJECT_MaterialOxidationMachine/Material Oxidation Machine/assets/plans_pdf/PLANO CHASIS.pdf

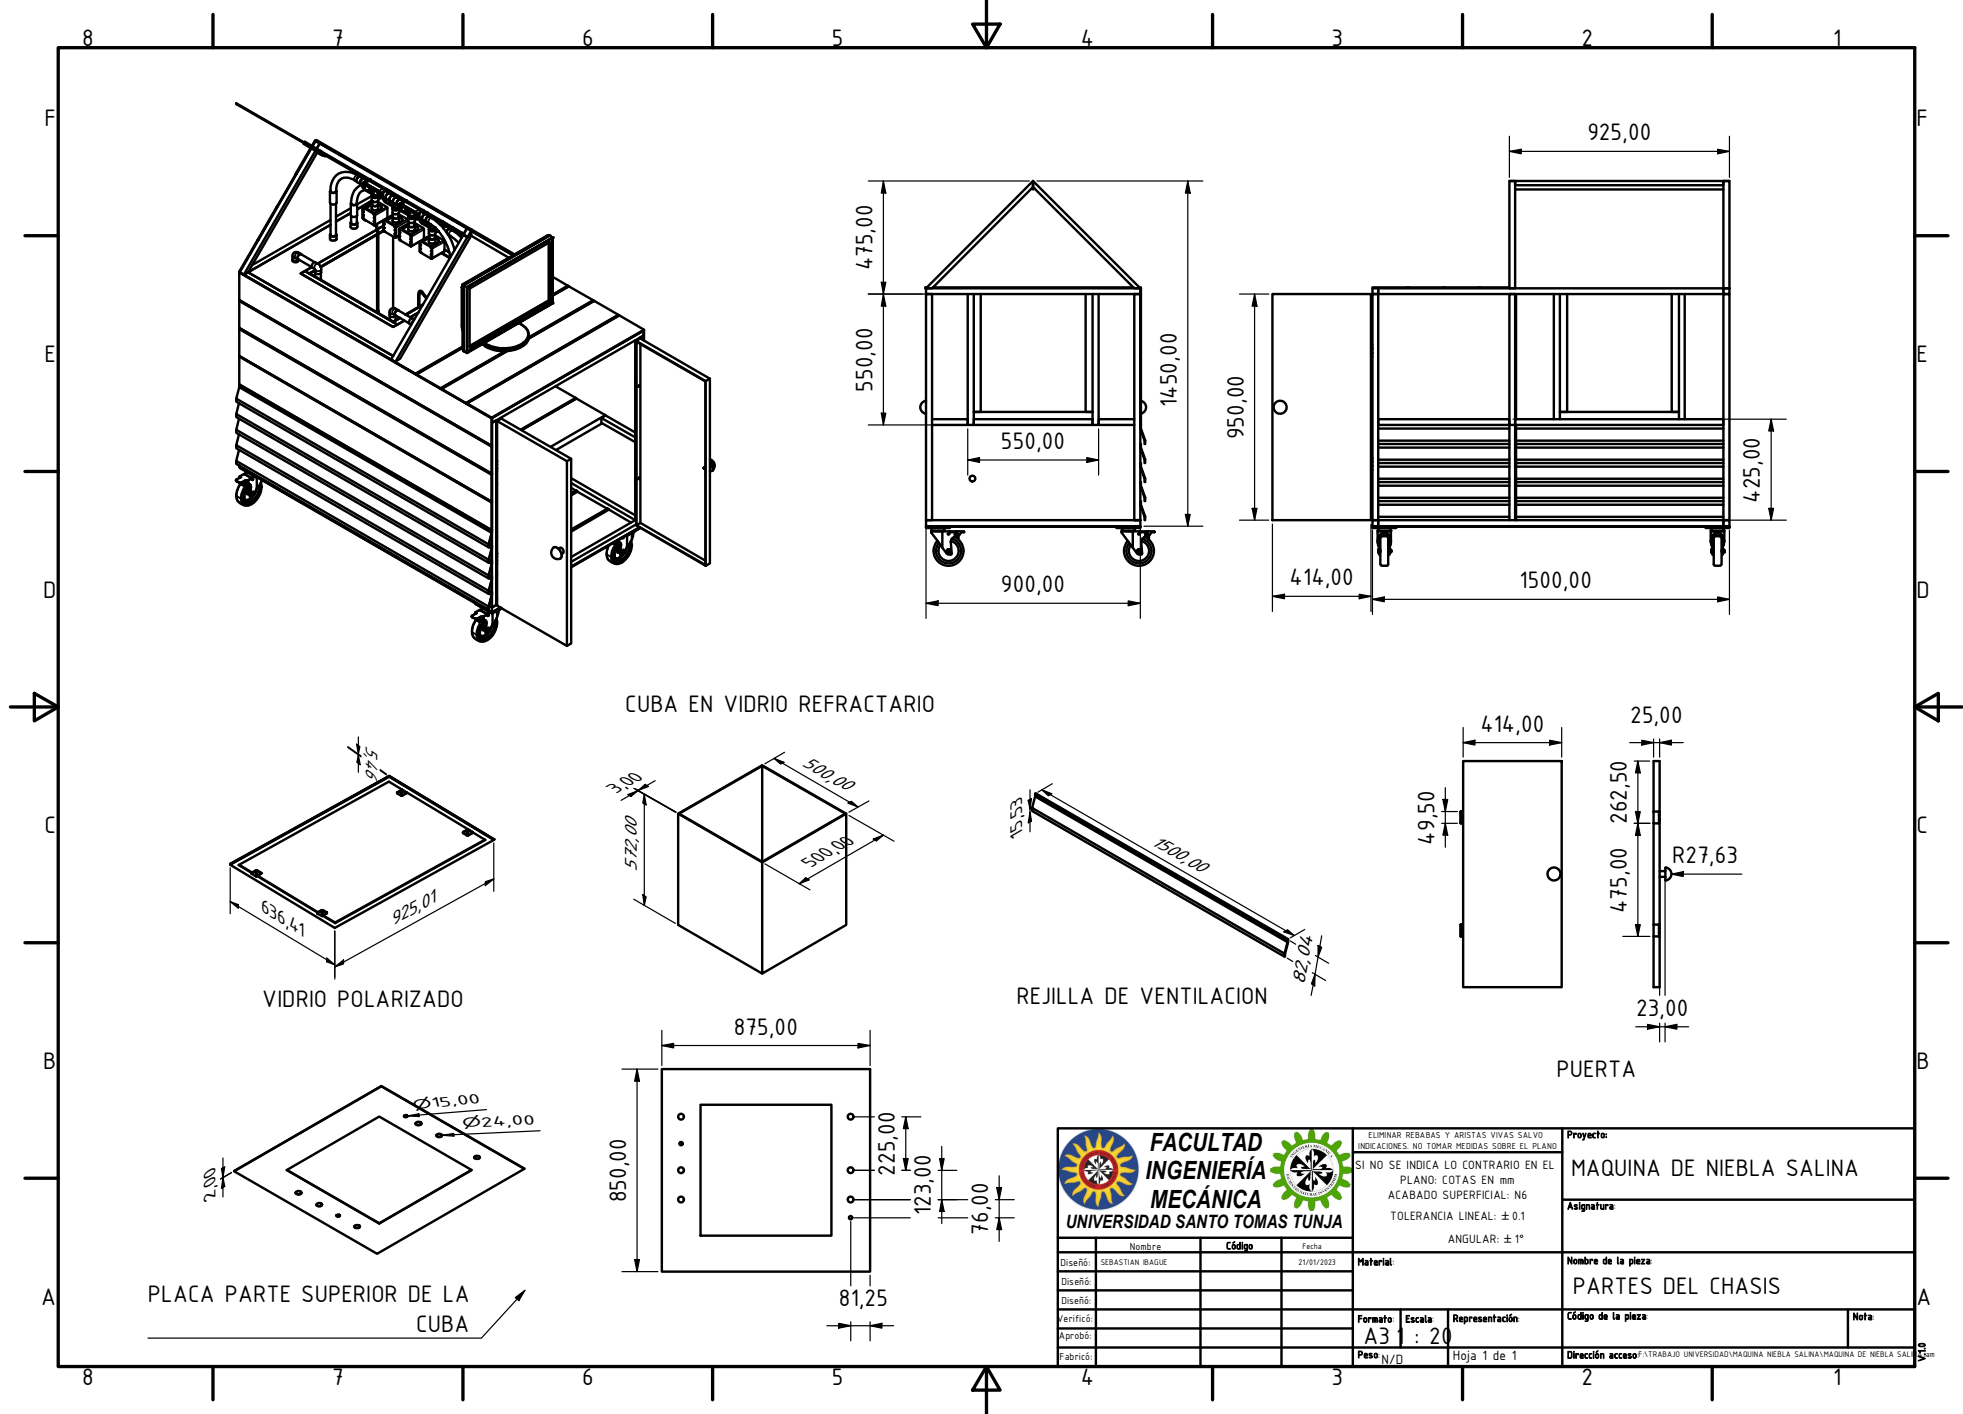
[picture p339: page 1]
VIDRIO POLARIZADO

CUBA EN VIDRIO REFRACTARIO

REJILLA DE VENTILACION

ELIMINAR REBABAS Y ARISTAS VIVAS SALVO
INDICACIONES. NO TOMAR MEDIDAS SOBRE EL PLANO
SI NO SE INDICA LO CONTRARIO EN EL

Proyecto:
MAQUINA DE NIEBLA SALINA

PLANO: COTAS EN mm
ACABADO SUPERFICIAL: N6
TOLERANCIA LINEAL: 0.1

UNIVERSIDAD SANTO TOMAS TUNJA

Nombre | C¦digo | Fecha

Dise¤¦: | SEBASTIAN IBAGUE | | 21/01/2023 | Material: | Nombre de la pieza: PARTES DEL CHASIS

Dise¤¦:

PLACA PARTE SUPERIOR DE LA

Verific¦: | | | | Formato: A3 1 : 20 | Escala: | Representaci¦n: | C¦digo de la pieza: | Nota:

Aprob¦:

Fabric¦: | | | | Peso: N/D | | Hoja 1 de 1 | Direcci¦n acceso:

F:\TRABAJO UNIVERSIDAD\MAQUINA NIEBLA SALINA\MAQUINA DE NIEBLA SALINA.iam
