RuisoArt/PROJECT_MaterialOxidationMachine/Material Oxidation Machine/assets/plans_pdf/PLANOS 2.pdf

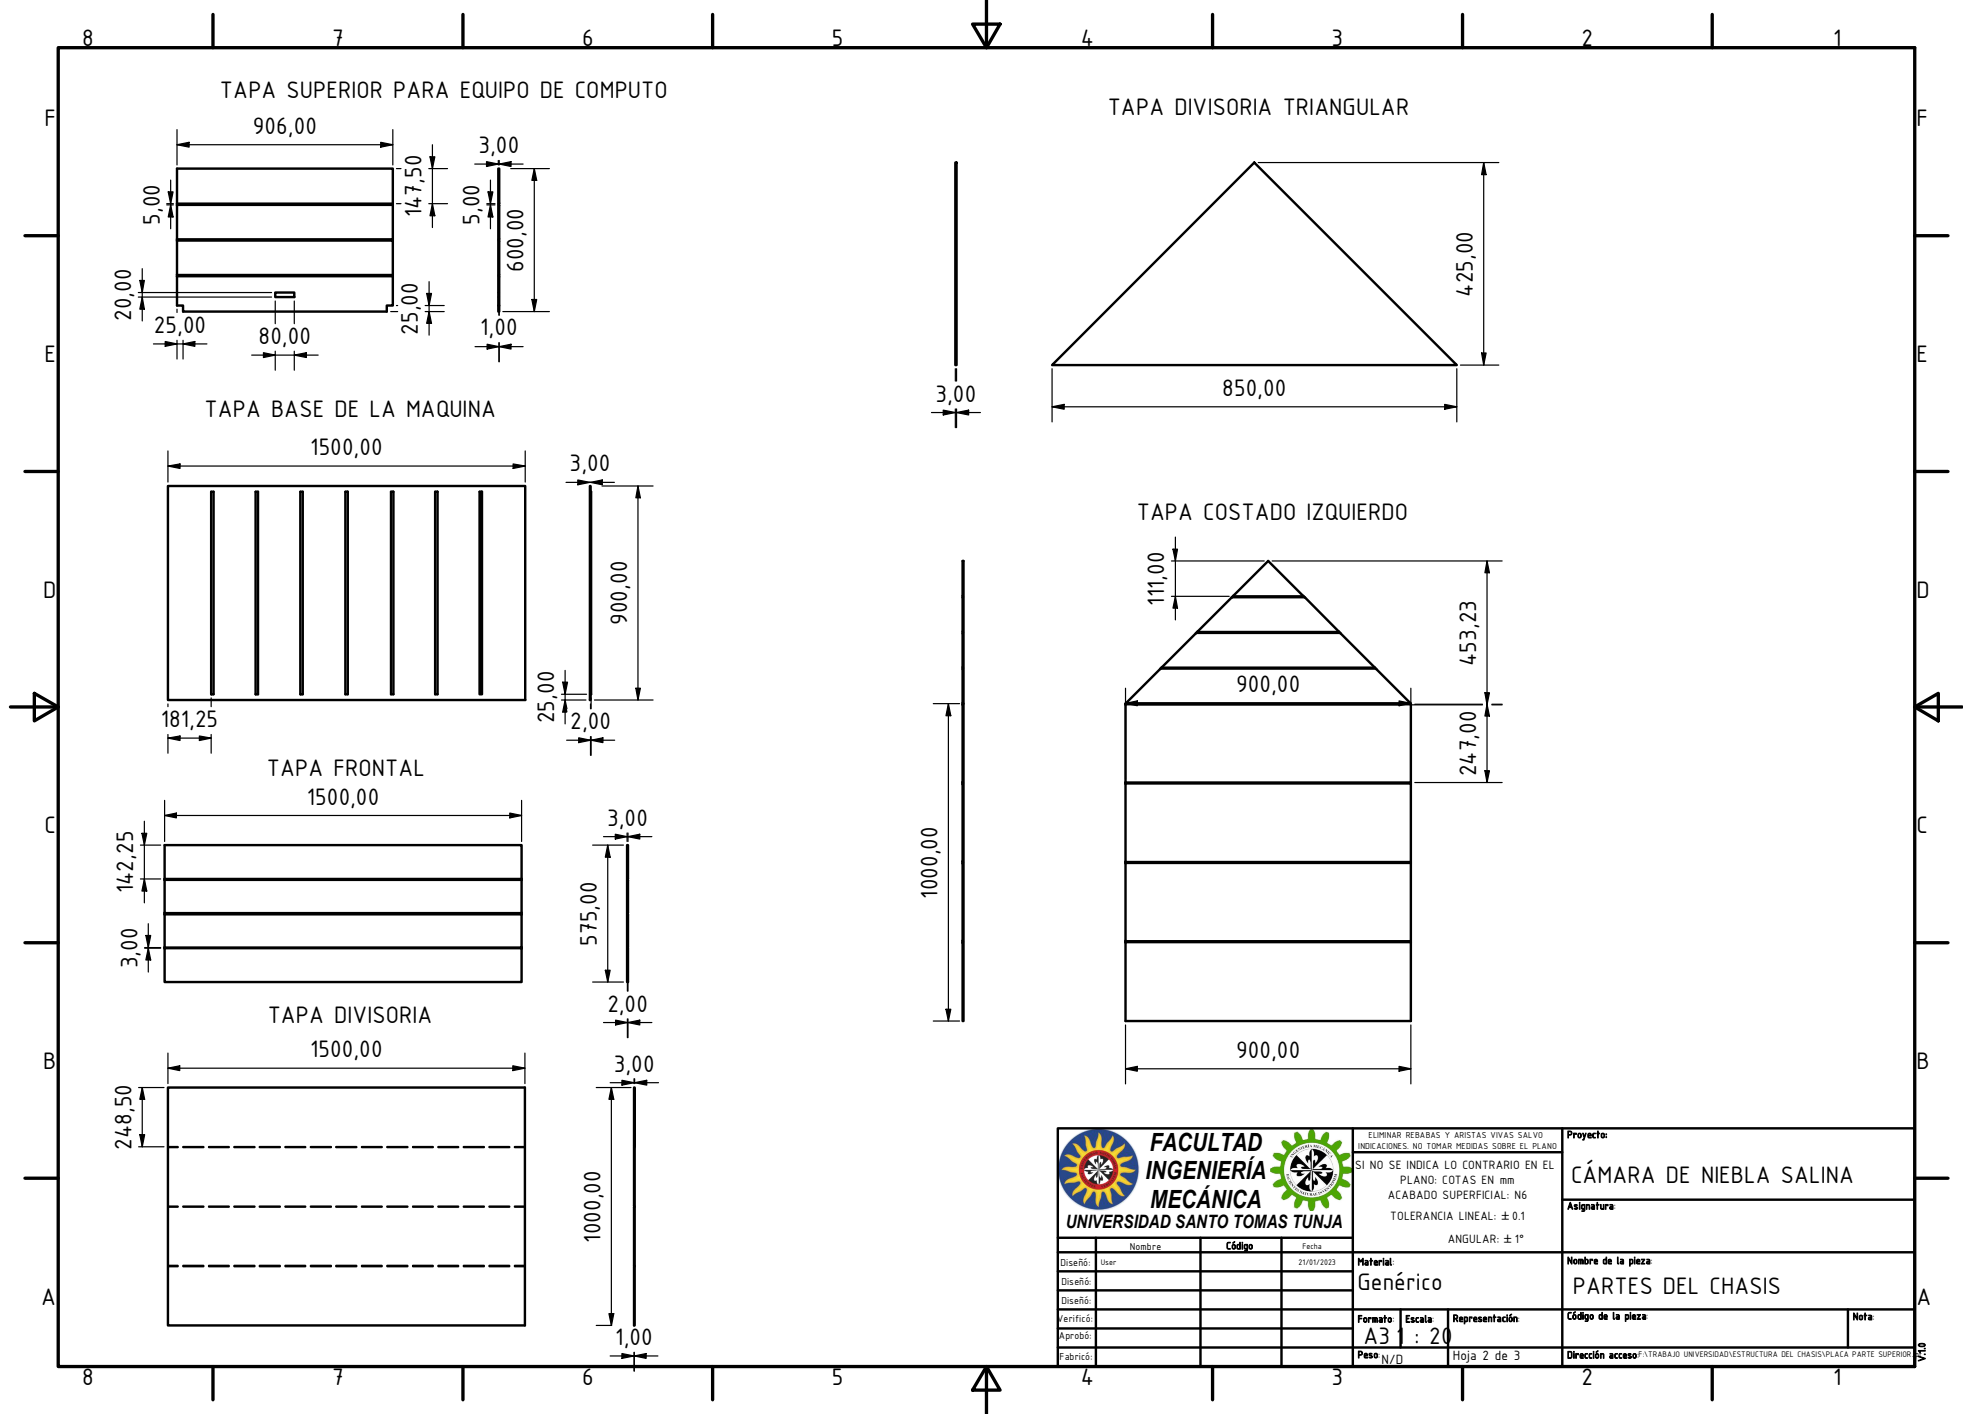
[picture p340: page 1]
¦: Aprob¦:; n: Peso:; Hoja 2 de 3; a: C¦digo de la pieza: Asignatura: Proyecto: Direcci¦n acceso: N/D

O INDICACIONES. NO TOMAR MEDIDAS SOBRE EL PLA

¦: Fabric¦: Dis e ¤ | | C
¦: Dis e ¤ | N U s e r | | 2 1 / 0 1 / 2 0 2 3 | M a t e ria l: Gen  ric o | N o m b r e d e l a pie z P A R T E S D E L C H A SIS

o m b r e | ¦ dig o | F e c h a

Dis e ¤
V e rific | | | | F o r m a t o: A3 | E s c a l a: 1 : 2 0 | R e p r e s e n t a ci¦ | o t
