RuisoArt/PROJECT_MaterialOxidationMachine/Material Oxidation Machine/assets/plans_pdf/PLANOS 3.pdf

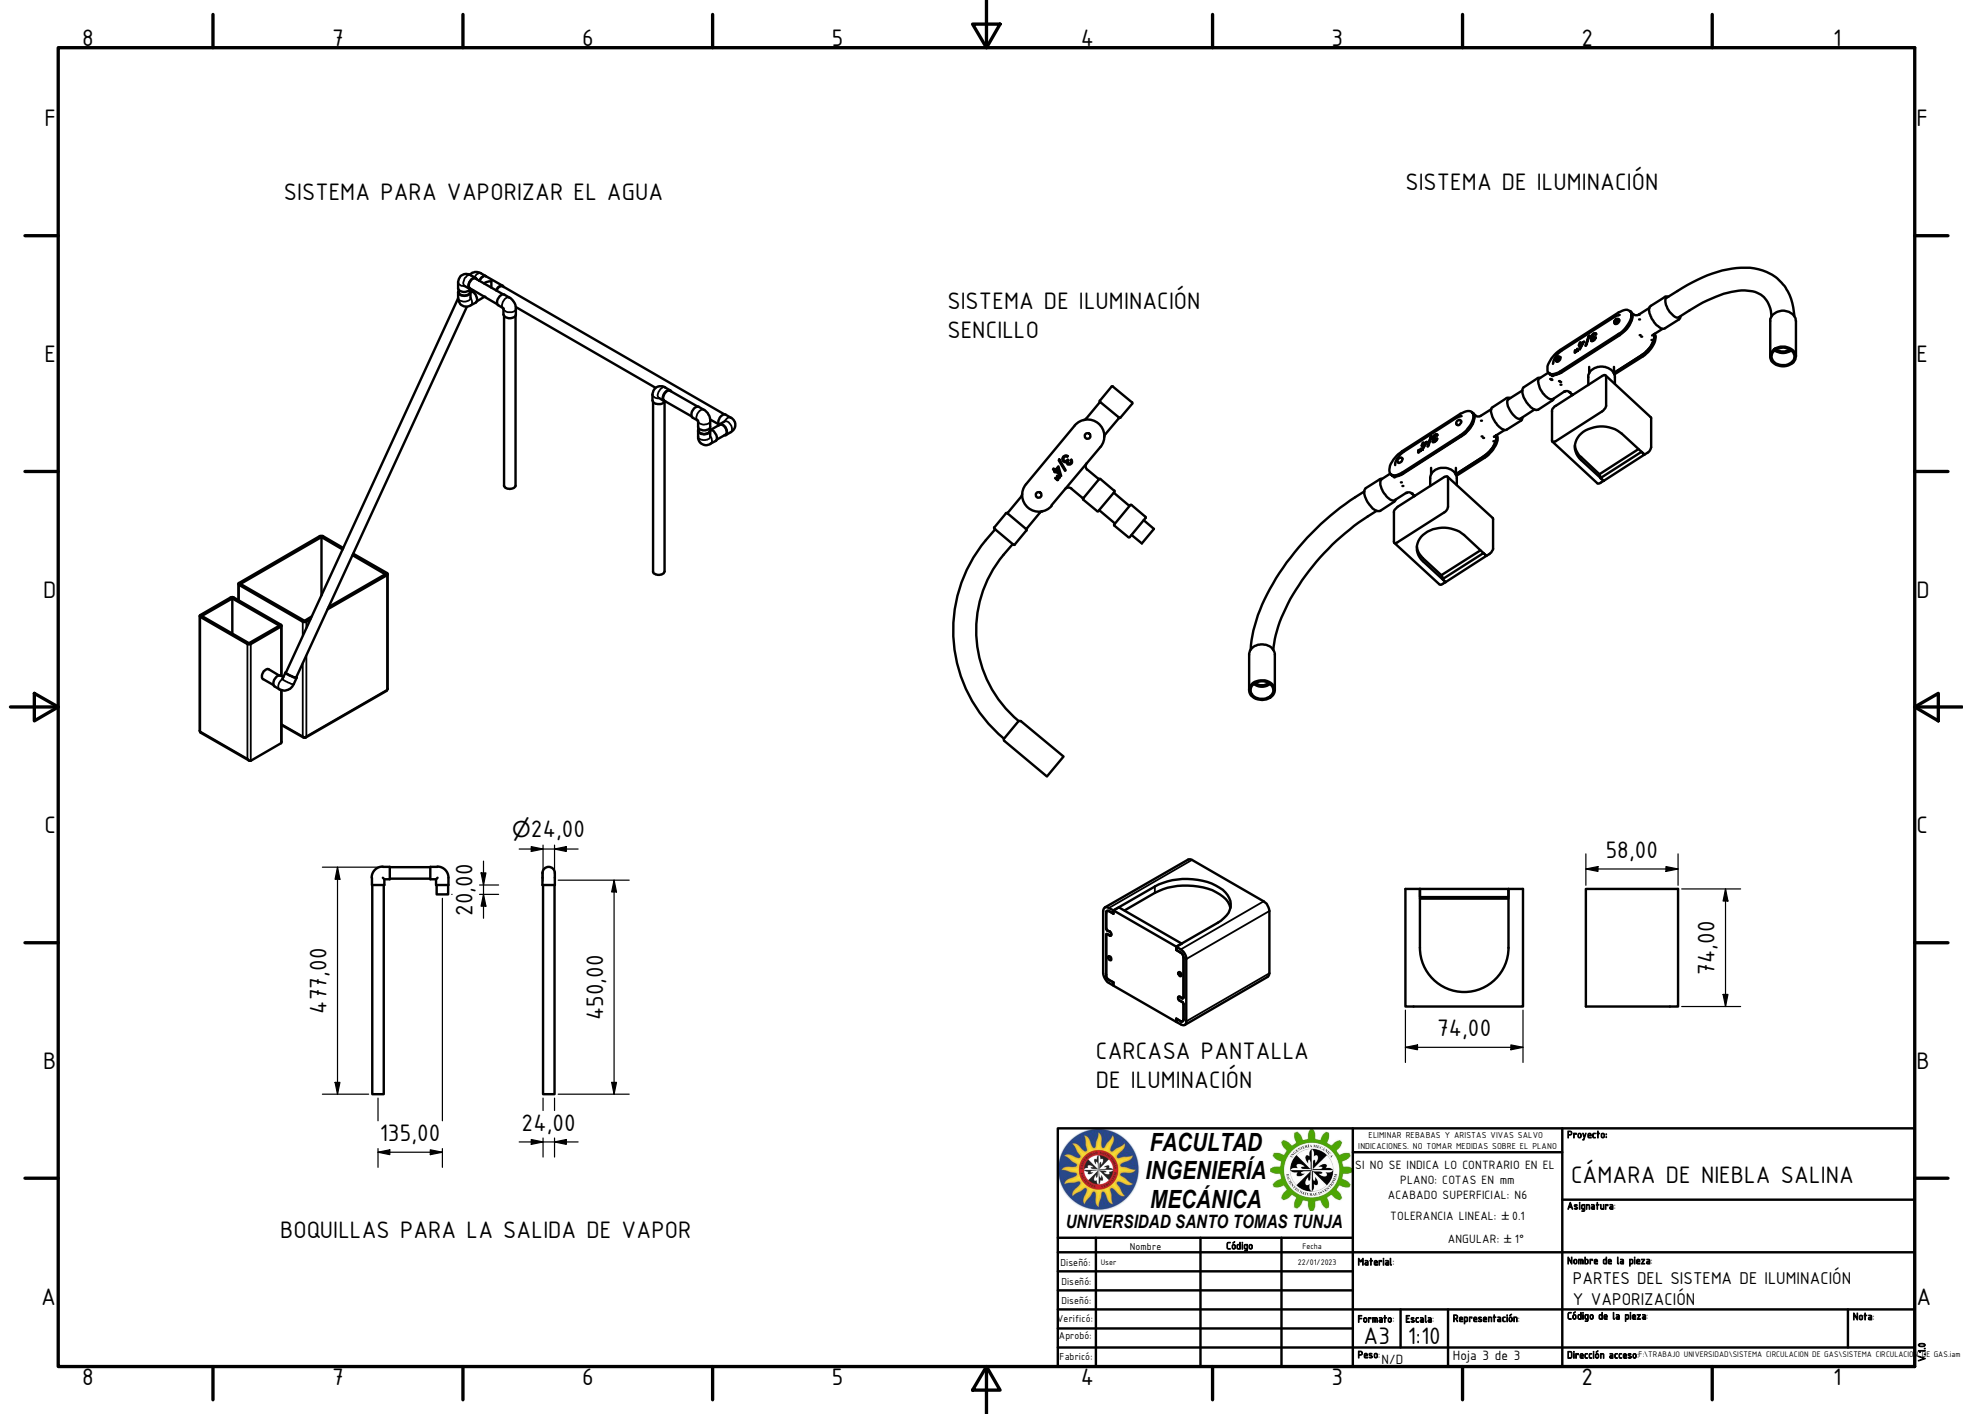
[picture p341: page 1]
CARCASA PANTALLA

SISTEMA DE ILUMINACIN

SISTEMA PARA VAPORIZAR EL AGUA

SENCILLO

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

Proyecto:
CyMARA DE NIEBLA SALINA

PLANO: COTAS EN mm
ACABADO SUPERFICIAL: N6
TOLERANCIA LINEAL: 0.1

UNIVERSIDAD SANTO TOMAS TUNJA

BOQUILLAS PARA LA SALIDA DE VAPOR

Nombre | C¦digo | Fecha

Dise¤¦: | User | | 22/01/2023 | Material: | Nombre de la pieza: PARTES DEL SISTEMA DE ILUMINACIN Y VAPORIZACIN

Dise¤¦:

Verific¦: | | | | Formato: A3 | Escala: 1:10 | Representaci¦n: | C¦digo de la pieza: | Nota:

Aprob¦:

Fabric¦: | | | | Peso: N/D | | Hoja 3 de 3 | Direcci¦n acceso:

F:\TRABAJO UNIVERSIDAD\SISTEMA CIRCULACION DE GAS\SISTEMA CIRCULACION DE GAS.iam
