RuisoArt/PROJECT_MaterialOxidationMachine/Material Oxidation Machine/assets/plans_pdf/PLANOS 1_merged.pdf

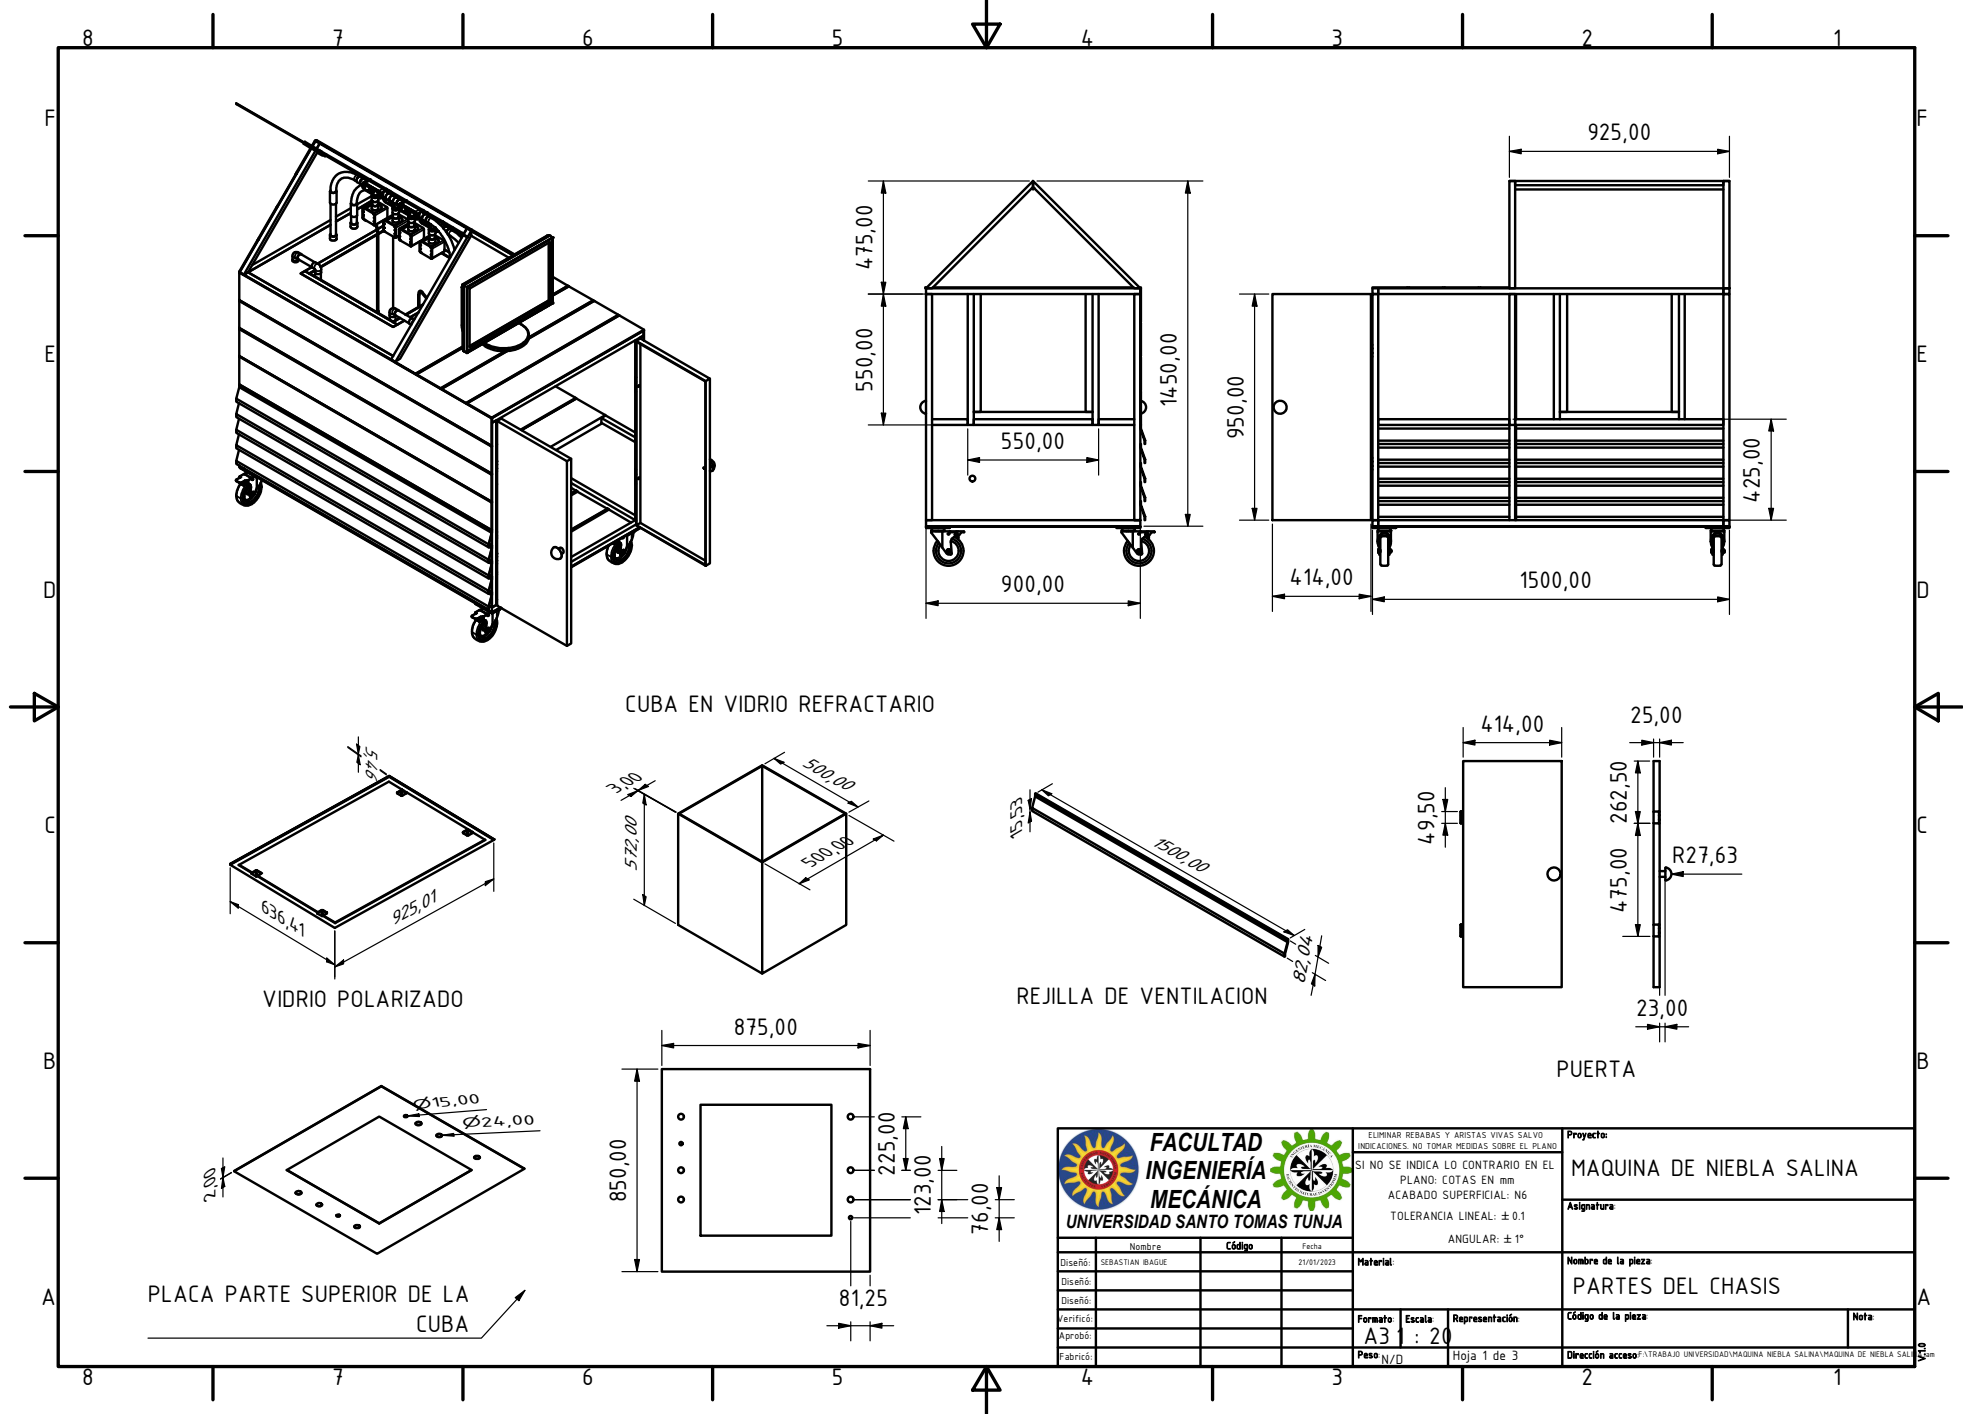
[picture p342: page 1]
Dise¤¦:; Nombre; Fecha; FACULTAD INGENIERËA MECÈNICA; Verific¦:; Fabric¦:; C¦digo; Aprob¦:; ANGULAR: B1n; Material:; Formato: A3; Escala: 1 : 20; Representaci¦n:; Peso:; Hoja 1 de 3; Asignatura:; Direcci¦n acceso:; SEBASTIAN IBAGUE; Nota:; VIDRIO POLARIZADO; PUERTA; CUBA

CUBA EN VIDRIO REFRACTARIO

REJILLA DE VENTILACION

ELIMINAR REBABAS Y ARISTAS VIVAS SALVO
INDICACIONES. NO TOMAR MEDIDAS SOBRE EL PLANO
SI NO SE INDICA LO CONTRARIO EN EL

Proyecto:
MAQUINA DE NIEBLA SALINA

PLANO: COTAS EN mm
ACABADO SUPERFICIAL: N6
TOLERANCIA LINEAL: B0.1

UNIVERSIDAD SANTO TOMAS TUNJA

Nombre de la pieza:
PARTES DEL CHASIS

PLACA PARTE SUPERIOR DE LA

C¦digo de la pieza:

F:\TRABAJO UNIVERSIDAD\MAQUINA NIEBLA SALINA\MAQUINA DE NIEBLA SALINA.iam

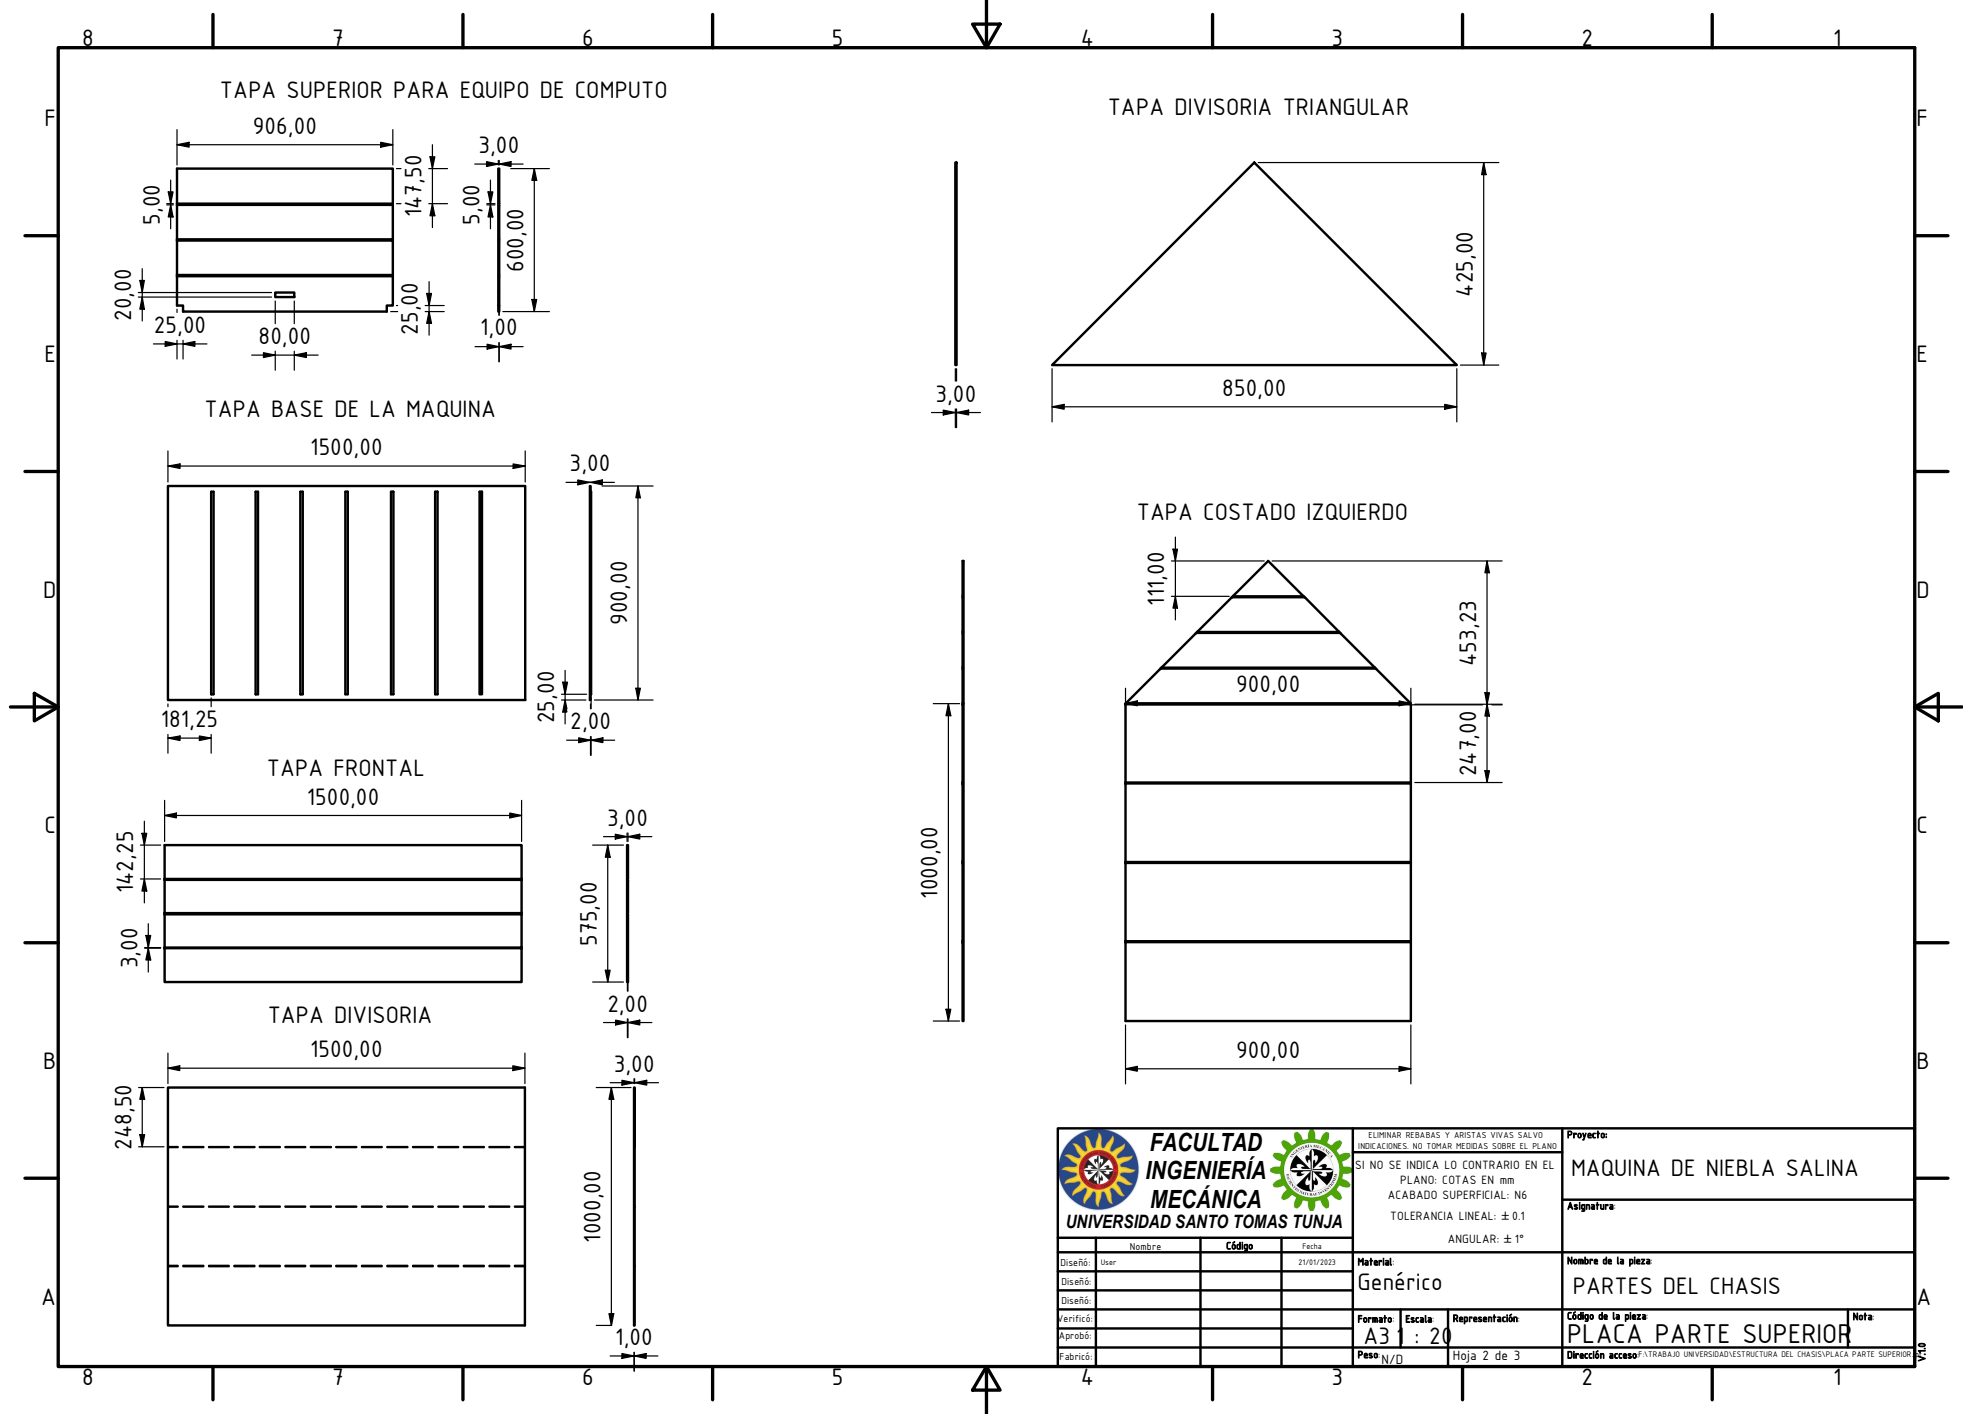
[picture p343: page 2]
RIO; Dis; NIER; VER; IDA; NJA; rific; ¦: Fabric¦:; ¦ dig; ¦: Aprob¦:; LIMIN; RIS; VIV; DIC; FICIA; CIA; LIN; ria; l: Gen ; ric; n: Peso:; Hoja 2 de 3; a pie; a: C¦digo de la pieza: Asignatura: Proyecto: Direcci¦n acceso: N/D; NIV; SID; SIS; UIN; NIE; UIP; DIVIS; RIA; UIE

O INDICACIONES. NO TOMAR MEDIDAS SOBRE EL PLA

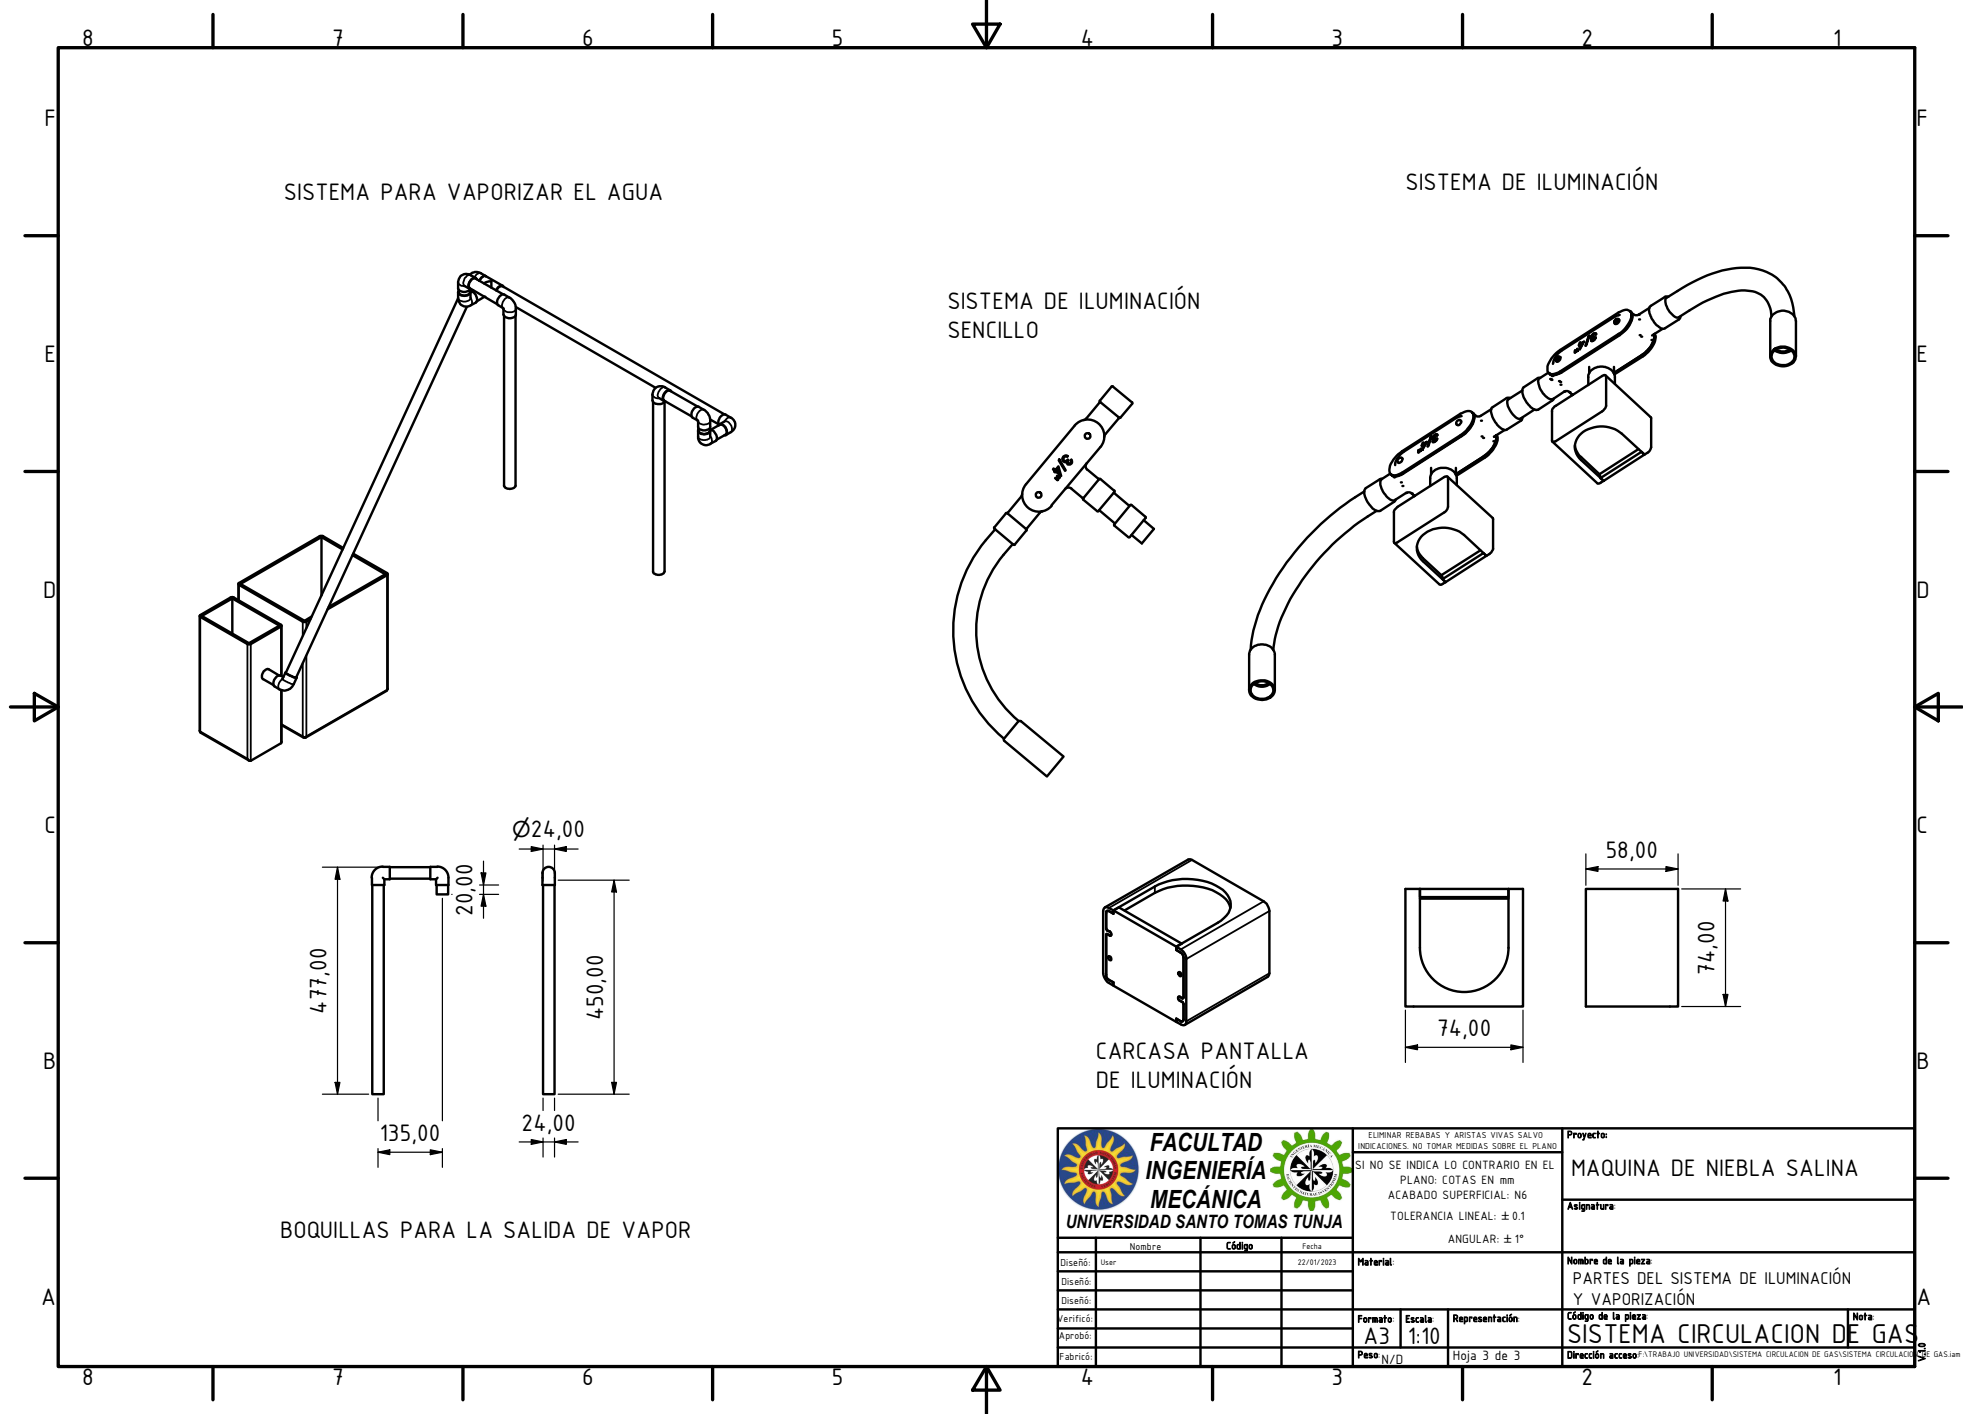
[picture p344: page 3]
Dise¤¦:; Nombre; Fecha; FACULTAD INGENIERËA MECÈNICA; Verific¦:; Fabric¦:; C¦digo; Aprob¦:; ANGULAR: B1n; Material:; Formato: A3; Escala: 1:10; Representaci¦n:; Peso:; Hoja 3 de 3; Asignatura:; Direcci¦n acceso:; User; Nota:; CARCASA PANTALLA DE ILUMINACIN

SISTEMA DE ILUMINACIN

SISTEMA PARA VAPORIZAR EL AGUA

SENCILLO

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

Proyecto:
MAQUINA DE NIEBLA SALINA

PLANO: COTAS EN mm
ACABADO SUPERFICIAL: N6
TOLERANCIA LINEAL: B0.1

UNIVERSIDAD SANTO TOMAS TUNJA

BOQUILLAS PARA LA SALIDA DE VAPOR

Nombre de la pieza:
PARTES DEL SISTEMA DE ILUMINACIN
Y VAPORIZACIN
SISTEMA CIRCULACION DE GAS

C¦digo de la pieza:

F:\TRABAJO UNIVERSIDAD\SISTEMA CIRCULACION DE GAS\SISTEMA CIRCULACION DE GAS.iam
