RuisoArt/PROJECT_MaterialOxidationMachine/Material Oxidation Machine/assets/doc/practica_empresarial/RUT.pdf

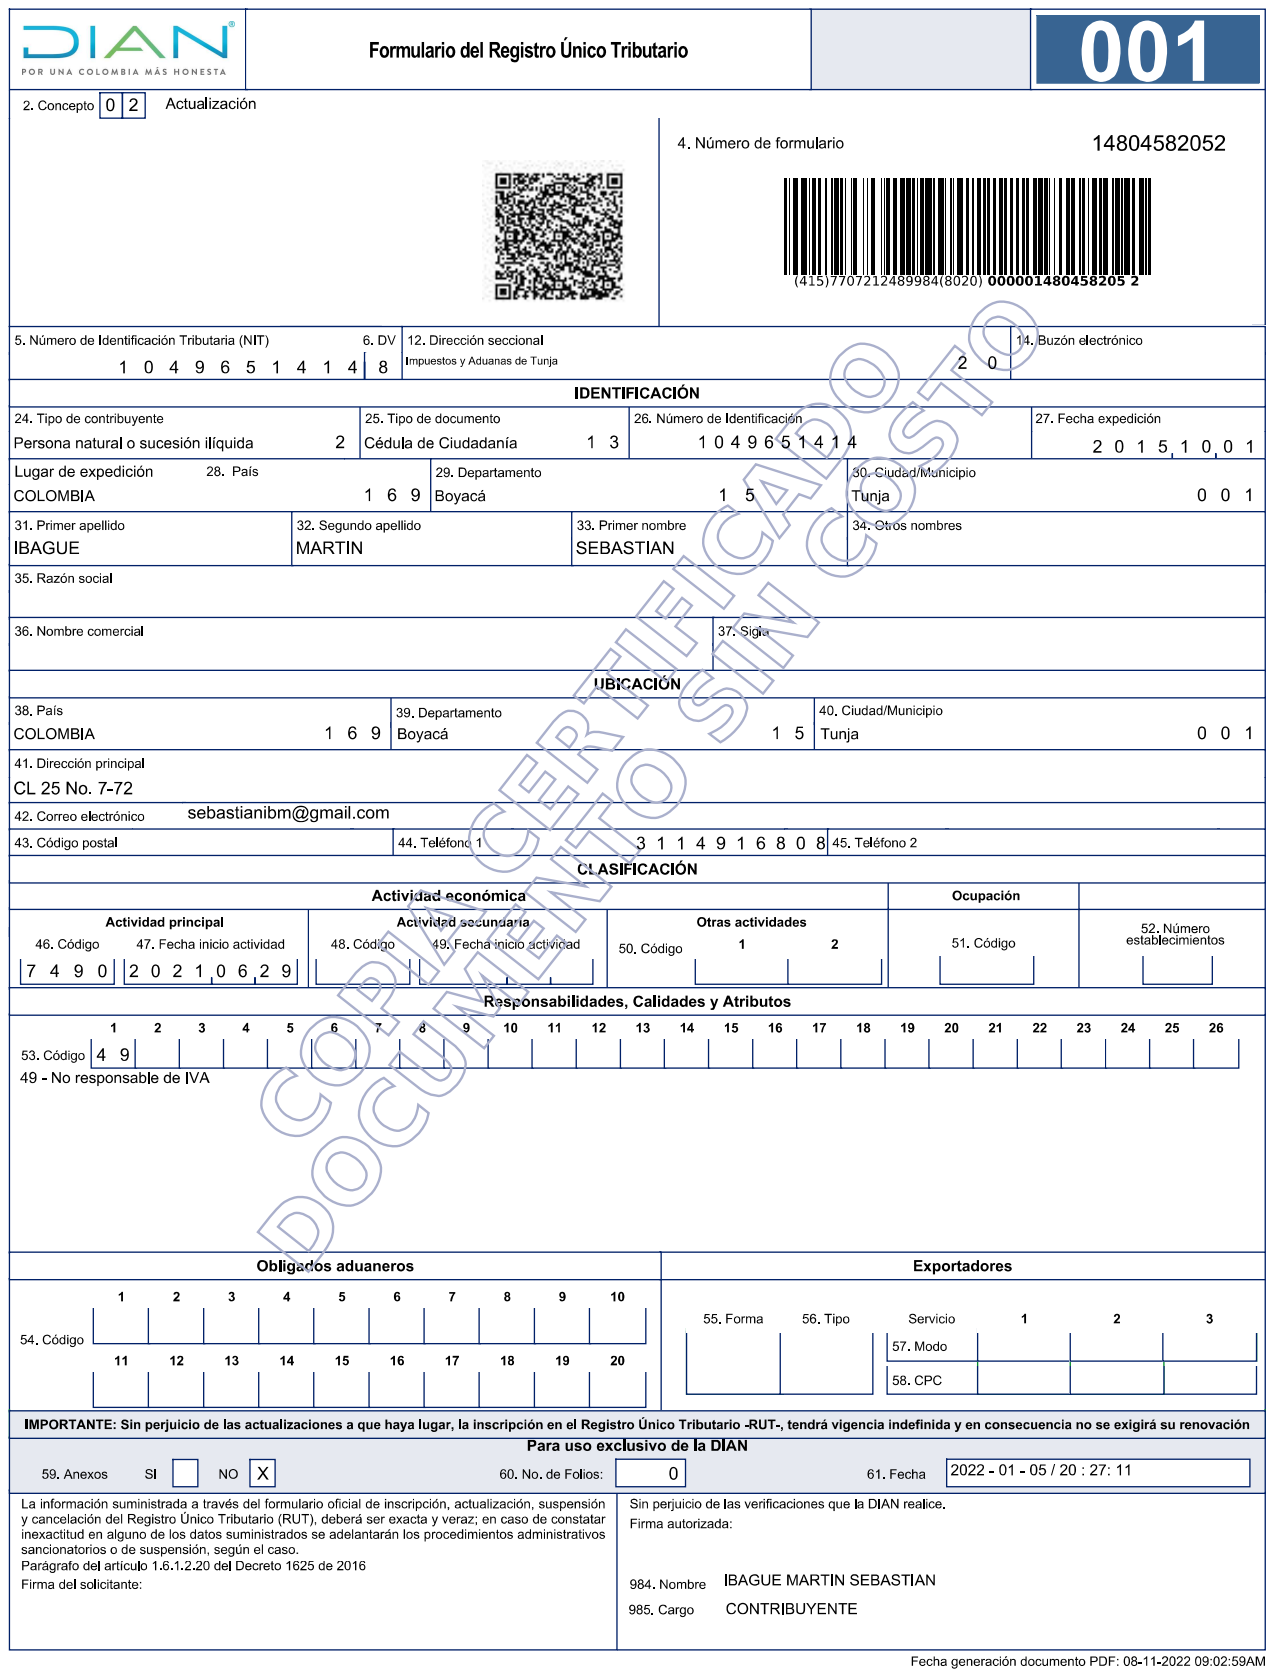
[picture p345: page 1]
