RuisoArt/PROJECT_MaterialOxidationMachine/(list of files, drawings)

Other design files:
assets/models/PCB/PANEL LED INFRARROJO/PANEL LED INFRARROJO/PANTALLA LED INFRARROJO.pdsprj
assets/models/PCB/PANEL LED ULTRAVIOLETA/PANEL LED ULTRAVIOLETA/PANTALLA LED ULTAVIOLETA.pdsprj
