RuisoArt/PROJECT_MaterialOxidationMachine/Material Oxidation Machine/app/Database/stop_machine.py

import RPi.GPIO as GPIO
import time
#from ..Code.code_gpio import output_7_seven as off

#--------------------------------------------------------------------------------
GPIO.setmode(GPIO.BOARD)

pin0 = 32 #GPIO 12 
GPIO.setup(pin0, GPIO.OUT)
GPIO.output(pin0,0)

pin1 = 36 #GPIO 16
GPIO.setup(pin1, GPIO.OUT)
GPIO.output(pin1,0)

pin2 = 38 #GPIO 20
GPIO.setup(pin2, GPIO.OUT)
GPIO.output(pin2,0)

pin3 = 40 #GPIO 21 
GPIO.setup(pin3, GPIO.OUT)
GPIO.output(pin3,0)
#--------------------------------------------------------------------------------

def emergency_stop(sensor4):
    if sensor4 == "0":
        print("La maquina debe apagarse")
        apaguelo(7)
        #off.output_off(7)
    else:
        print("Sigue la maquina encendida")
    
def apaguelo(number):
    if number == 7:
        time.sleep(0.25)
        GPIO.output(pin0, 0)
        time.sleep(0.25)
        GPIO.output(pin1, 0)
        time.sleep(0.25)
        GPIO.output(pin2, 0)
        time.sleep(0.25)
        GPIO.output(pin3, 0)
        print("Todas las salidas se han apagado")
    else:
        print("No ha llegado lo que se solicuta para encender el pin 0 al 3")
