RuisoArt/PROJECT_MaterialOxidationMachine/Material Oxidation Machine/test/switch/switch_test_1/Temp_One_DS18B20.py

# Link de compra ferretronica = https://ferretronica.com/products/sensor-temperatura-termocupla-sumergible-ds18b20?_pos=1&_sid=6512f47e3&_ss=r
# Datasheet DS18820 = https://pdf1.alldatasheet.com/datasheet-pdf/view/58557/DALLAS/DS18B20.html

# Codigo para un solo sensor
# https://github.com/israel-dryer/Raspberry-Pi-Sensors/blob/master/ds18b20_single.py

import os
import glob
import time

#these tow lines mount the device:
os.system('modprobe w1-gpio')
os.system('modprobe w1-therm')
 
base_dir = '/sys/bus/w1/devices/'
device_path = glob.glob(base_dir + '28*')[0] #get file path of sensor
rom = device_path.split('/')[-1] #get rom name

def read_temp_raw():
    with open(device_path +'/w1_slave','r') as f:
        valid, temp = f.readlines()
    return valid, temp
 
def read_temp():
    valid, temp = read_temp_raw()

    while 'YES' not in valid:
        time.sleep(0.2)
        valid, temp = read_temp_raw()

    pos = temp.index('t=')
    if pos != -1:
        #read the temperature .
        temp_string = temp[pos+2:]
        temp_c = float(temp_string)/1000.0 
        temp_f = temp_c * (9.0 / 5.0) + 32.0
        return temp_c, temp_f
 
print(' ROM: '+ rom)

while True:
    c, f = read_temp()
    print('C={:,.3f} F={:,.3f}'.format(c, f))
    time.sleep(1)
