RuisoArt/PROJECT_MaterialOxidationMachine/(commit log)

2023-02-21 PCB Electronics
    Update Folder PCB Electronics
2023-02-21 Documents
    My documents in business practice
    [COTIZACION (2).xlsx, COTIZACION (3).xlsx, COTIZACION Y PRESUPUESTO.xlsx, COTIZACION.xlsx, SEGUNDA COTIZACION.xlsx, costos de la raspberry ve2.xlsx, hoja de presupuesto ve3.xlsx]
2023-02-21 software
    folder test code
    [6-12-2022.csv]
2023-02-21 software
    Arduino software
2023-02-21 sensor read
2023-09-21 changed files and folders
    [6-12-2022.csv, COTIZACION (2).xlsx, COTIZACION (3).xlsx, COTIZACION Y PRESUPUESTO.xlsx, COTIZACION.xlsx, SEGUNDA COTIZACION.xlsx, costos de la raspberry ve2.xlsx, data.csv]
2023-09-21 pcb gpio board
2023-09-21 pcb infrared panel
2023-09-21 pcb ultraviolet panel
2023-09-21 pcb led screen
2023-09-21 pcb impact machine
2023-09-21 Led Board
2023-09-21 documents and software
    [6-12-2022.csv, COTIZACION (2).xlsx, COTIZACION (3).xlsx, COTIZACION Y PRESUPUESTO.xlsx, COTIZACION.xlsx, EA-TU-F-020 Programación de espacios y practicas Felipe Sistemas.xlsx, Logical framework ve1 [Luis Felipe Narvaez Gomez - 2312660].xlsm, Logical framework ve2 [Luis Felipe Narvaez Gomez - 2312660].xlsm]
2023-10-08 dashboard test
    [data.csv]
2023-10-25 version de dashboard streamlit 3
2023-10-26 streamlit test 5
    [1.csv]
2023-11-15 libro de grado
2023-11-16 avances diagramas y libro de grado
2023-11-21 libro de grado y planos electricos
2024-03-04 nuevo libro de grado
2024-03-04 cambios libro de grado y nuevos documentos anexados y version 6 tkinter software
2024-03-06 tkinter version 6 y 7
    funcionando interfaz de control, faltan detalles, e inicio del fin de interfaz 2 de vizualizacion de registros
2024-03-08 cambios en propuesta de grado
2024-03-11 plano electrico y electronico, cambios en tkinter 7
    [PANTALLA LED INFRARROJO.pdsprj, PANTALLA LED ULTAVIOLETA.pdsprj]
2024-03-15 nuevos cambios de tkinter
2024-03-15 parada de emergencia
2024-03-19 new Libro de grado
2024-04-02 CHANGES IN DOC AND GRAPH
    [PANTALLA LED INFRARROJO.pdsprj, PANTALLA LED ULTAVIOLETA.pdsprj]
2024-04-05 new data
    [referencias libro de grado.xlsx]
2024-04-07 changes project
    [COTIZACION (2).xlsx, COTIZACION (3).xlsx, COTIZACION Y PRESUPUESTO.xlsx, COTIZACION.xlsx, SEGUNDA COTIZACION.xlsx, costos de la raspberry ve2.xlsx, cronograma de actividades tesis.xlsx, hoja de presupuesto ve3.xlsx]
2024-04-07 project dash
    [data.csv]
2024-04-07 changes sensors
2024-04-07 changes streamlit
    [1.csv]
2024-04-07 changes switch
    [6-12-2022.csv]
2024-05-02 Ultima Ficha de Objetivos
2024-05-02 changes in version 3 in Principal doc
    libro de grado con correcciones por parte de comite
2024-05-08 utima version de libro ve4
2024-05-08 ultimas imagenes de paneles Software Completo
