RuisoArt/PROJECT_MaterialOxidationMachine/Material Oxidation Machine/assets/photo/20220916_174845.jpg

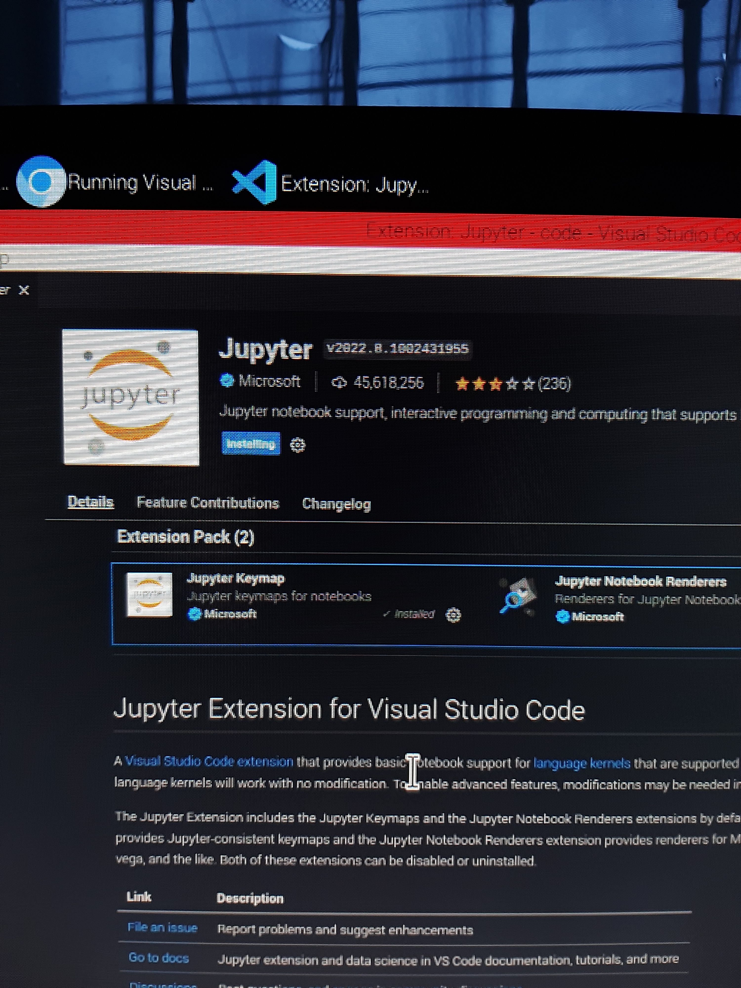
Material Oxidation Machine/assets/photo/20220916_174845.jpg
