RuisoArt/PROJECT_MaterialOxidationMachine/Material Oxidation Machine/assets/photo/20220930_193127.jpg

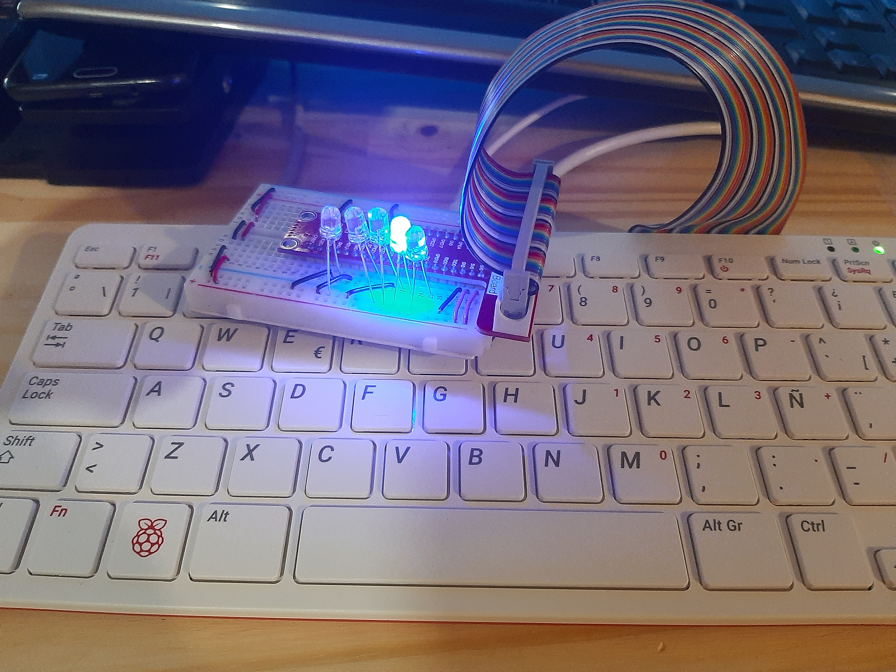
Material Oxidation Machine/assets/photo/20220930_193127.jpg
