RuisoArt/PROJECT_MaterialOxidationMachine/Material Oxidation Machine/assets/photo/20220930_193439.jpg

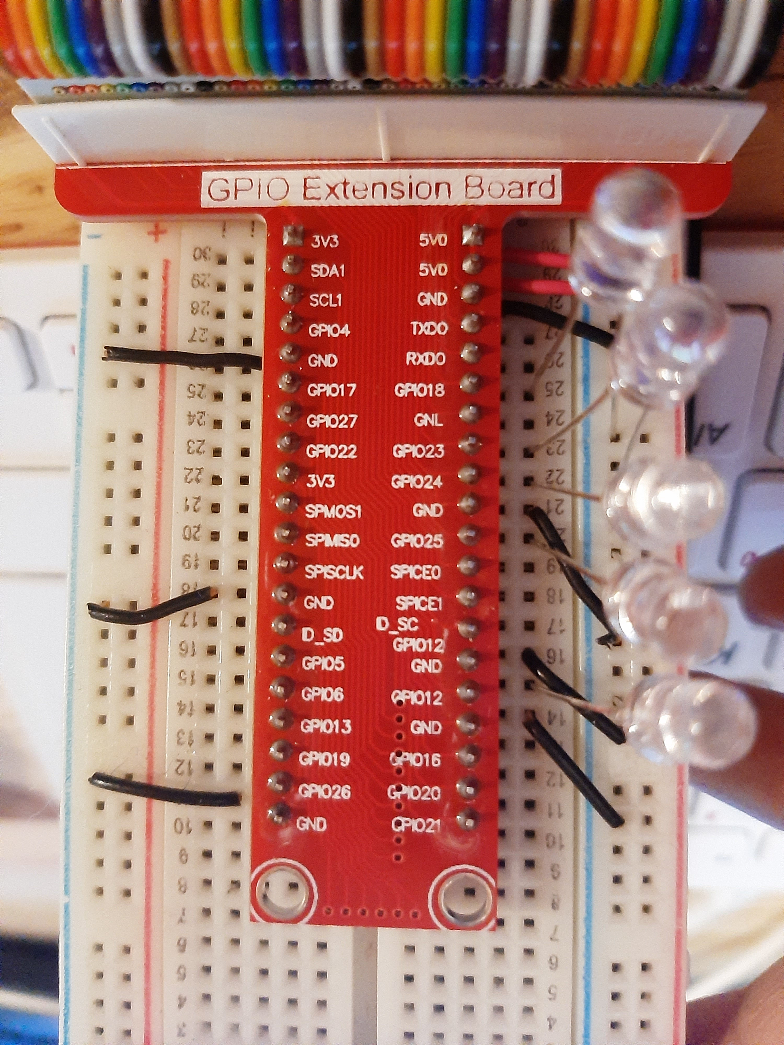
Material Oxidation Machine/assets/photo/20220930_193439.jpg
