RuisoArt/PROJECT_MaterialOxidationMachine/Material Oxidation Machine/assets/photo/20221001_225022.jpg

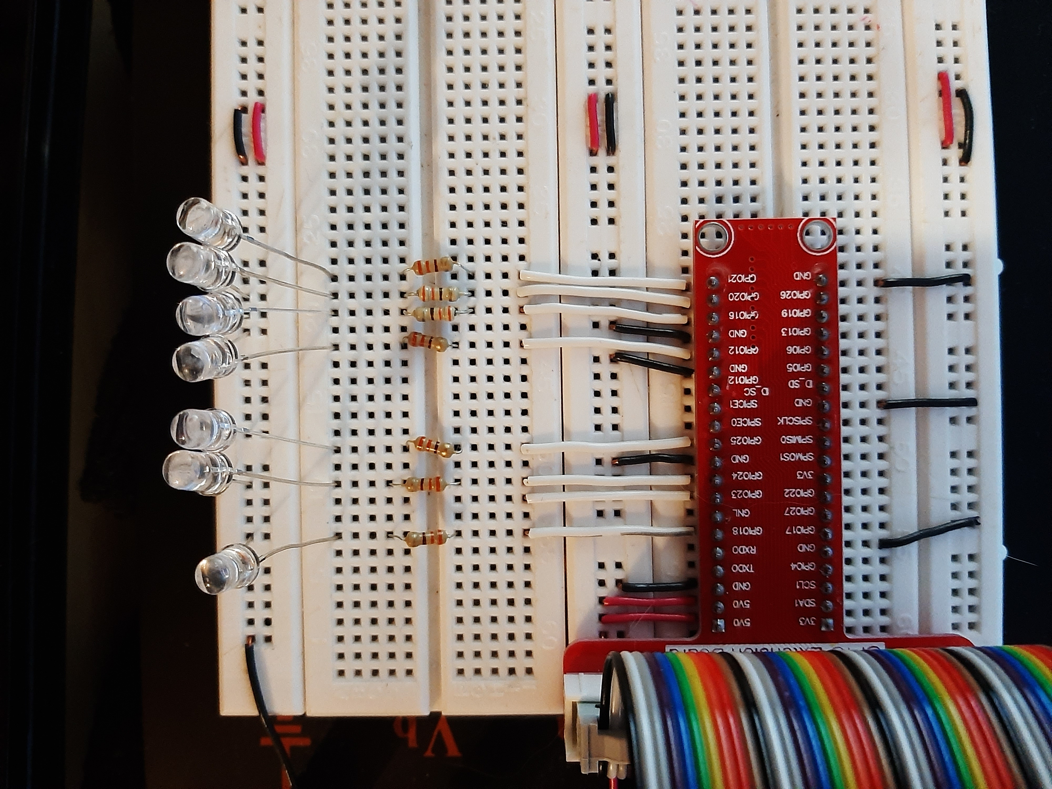
Material Oxidation Machine/assets/photo/20221001_225022.jpg
