RuisoArt/PROJECT_MaterialOxidationMachine/Material Oxidation Machine/assets/photo/20221001_231718.jpg

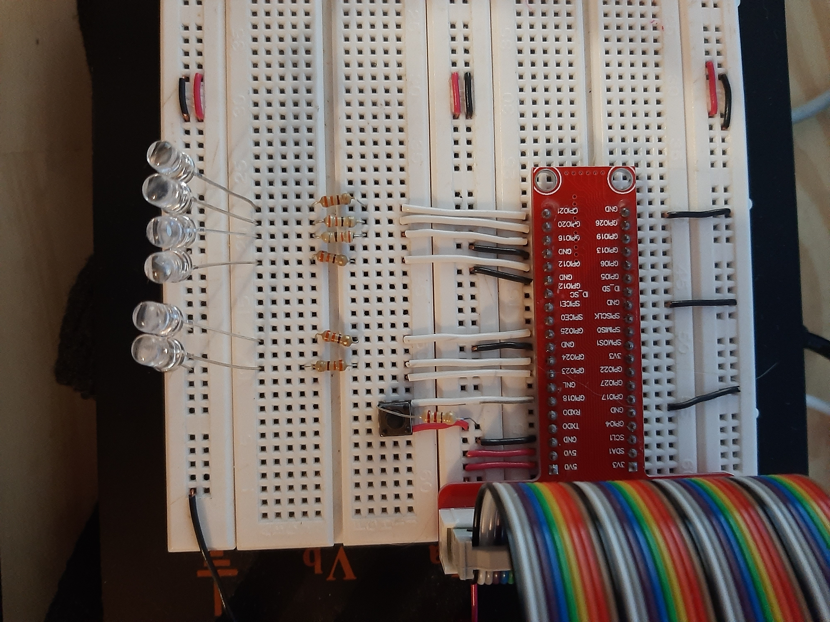
Material Oxidation Machine/assets/photo/20221001_231718.jpg
