RuisoArt/PROJECT_MaterialOxidationMachine/Material Oxidation Machine/assets/photo/20221019_152233.jpg

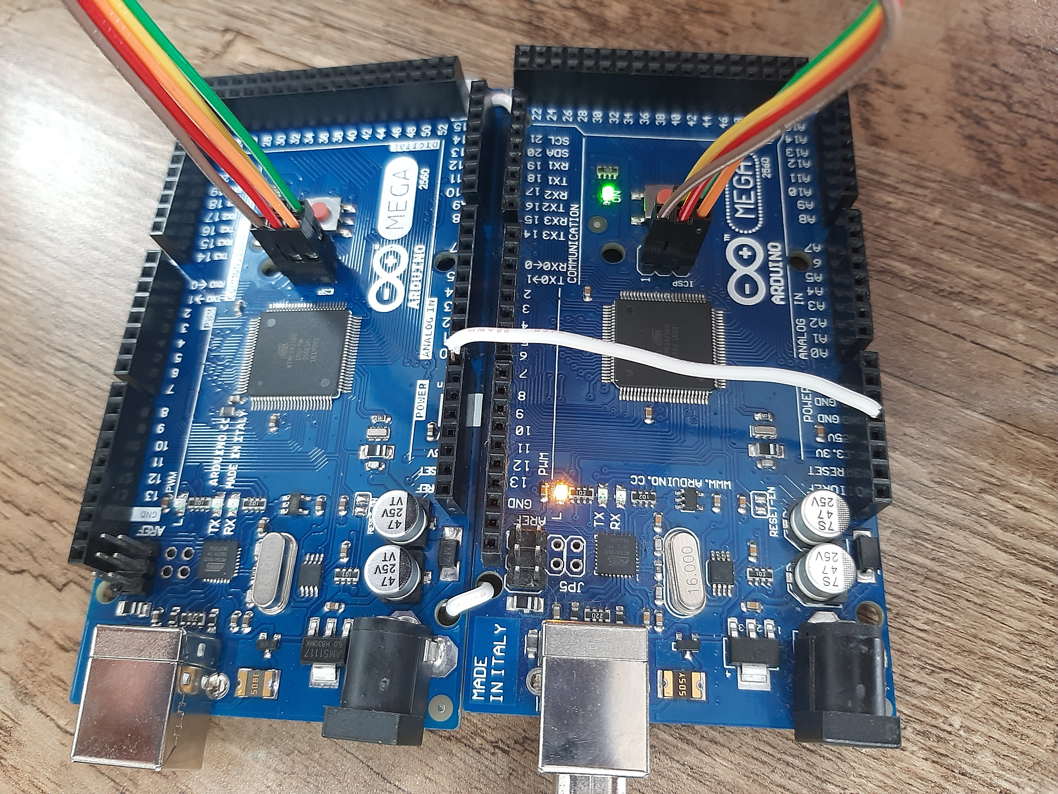
Material Oxidation Machine/assets/photo/20221019_152233.jpg
