RuisoArt/PROJECT_MaterialOxidationMachine/Material Oxidation Machine/assets/photo/20221103_165110.jpg

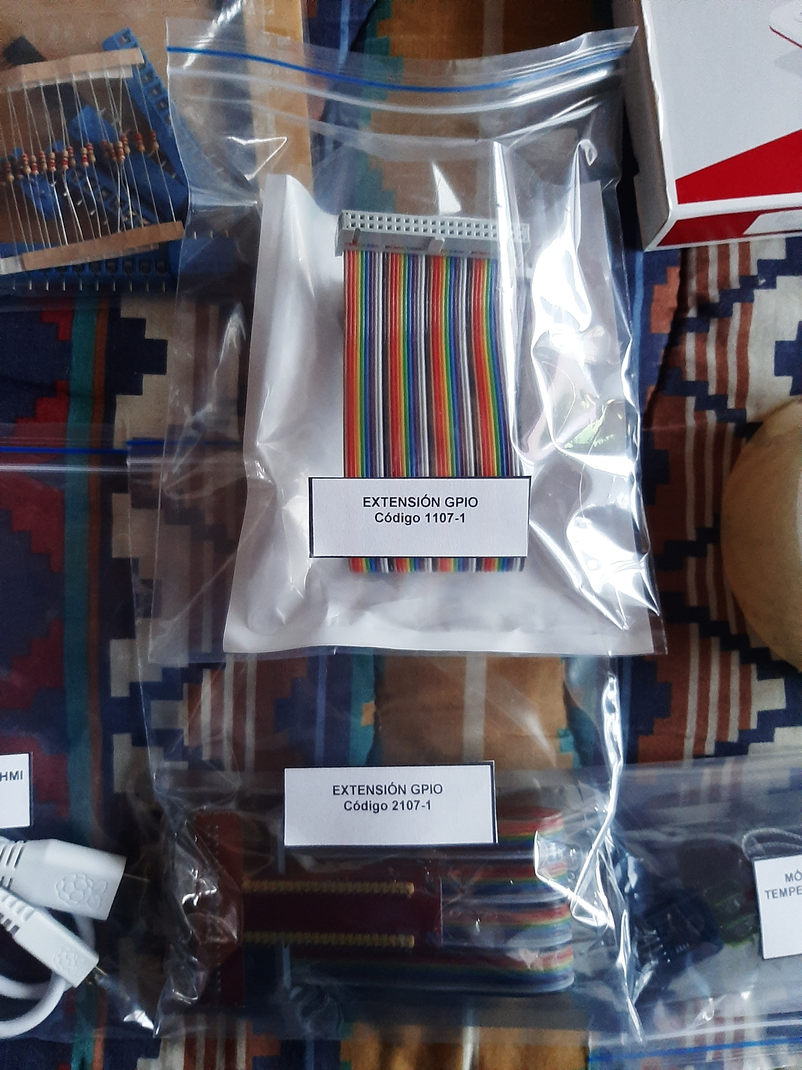
Material Oxidation Machine/assets/photo/20221103_165110.jpg
